M2I-CySat/CySat-1-Structures/20180421_144640.jpg

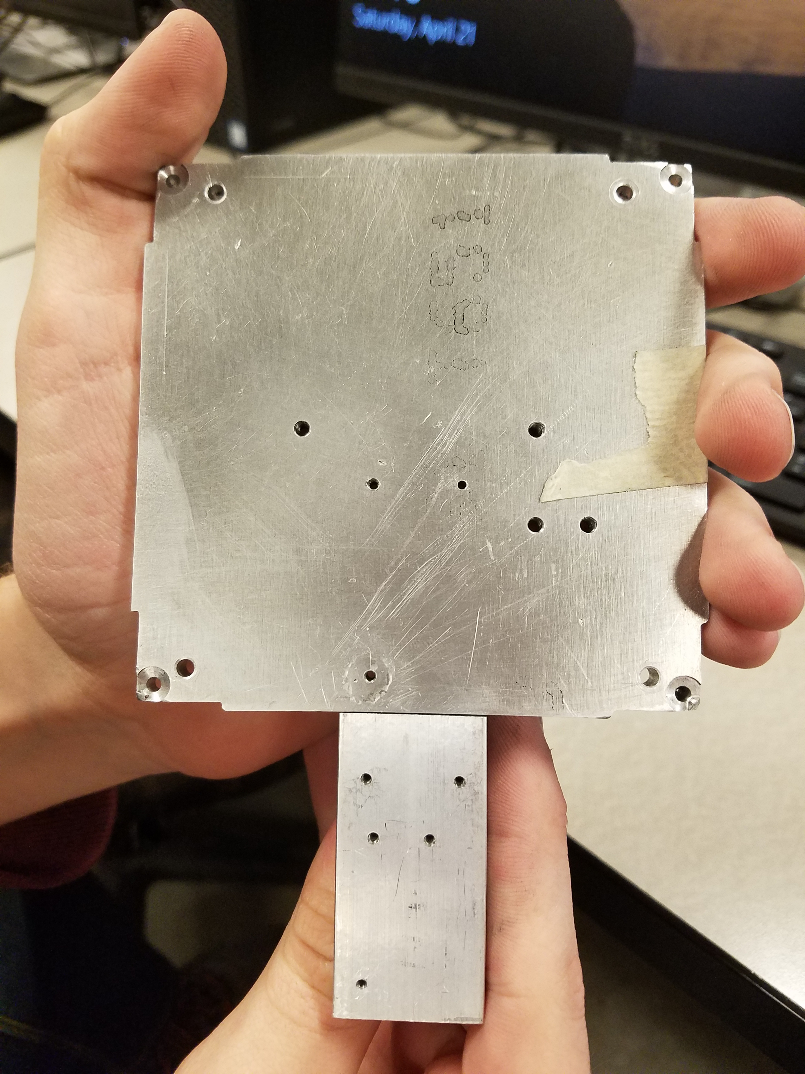
20180421_144640.jpg
