M2I-CySat/CySat-1-Structures/20180418_163143.jpg

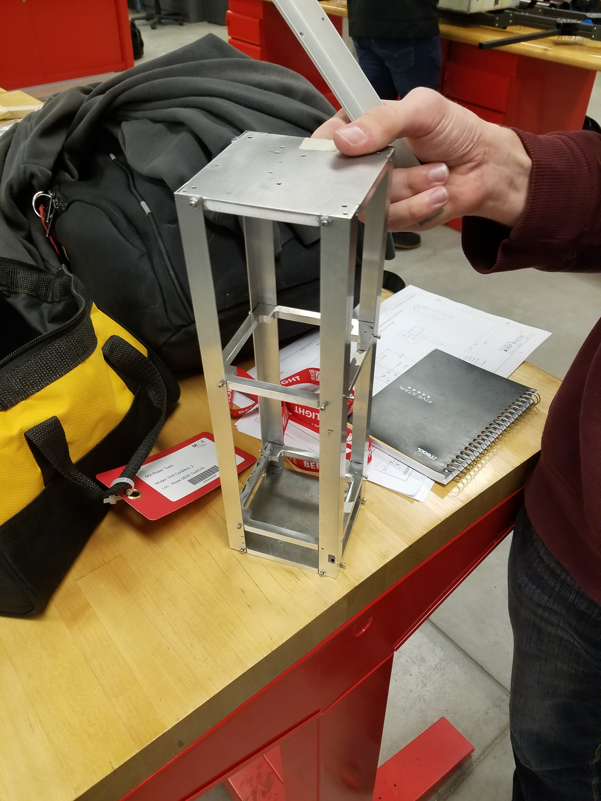
20180418_163143.jpg
