M2I-CySat/CySat-1-Structures/README.md

CySat-Structure

The SolidWorks files showing the structural arrangement of the satellite and all its components

===============
