M2I-CySat/CySat-1-Structures/20180421_144650.jpg

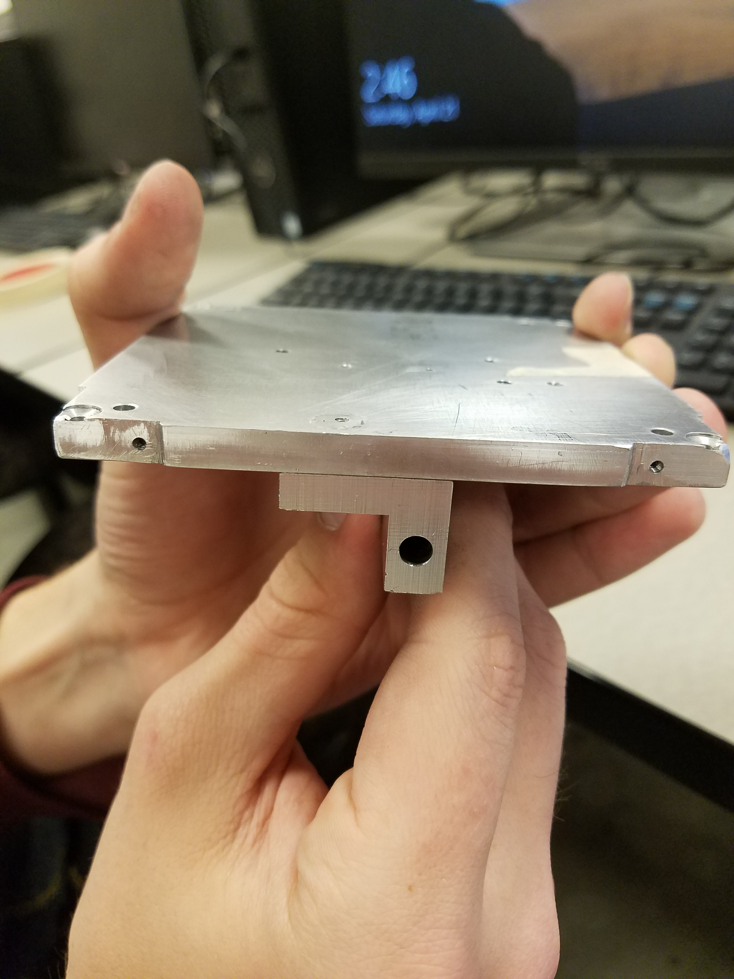
20180421_144650.jpg
