M2I-CySat/CySat-1-Structures/20180421_145329.jpg

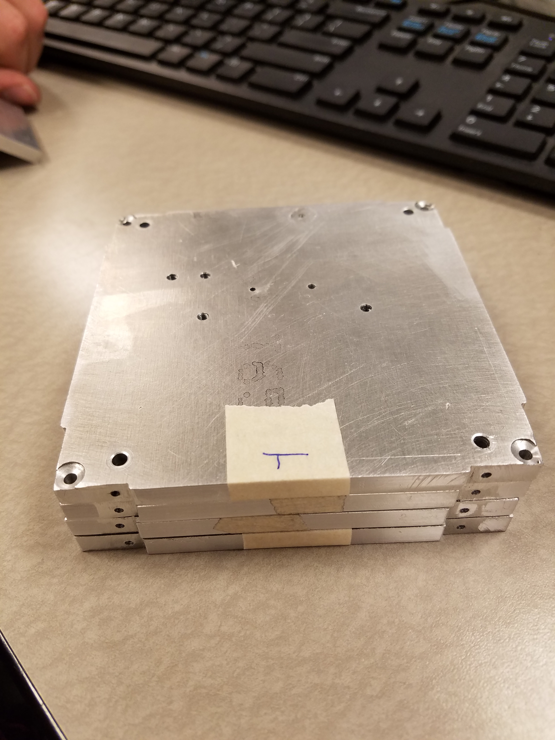
20180421_145329.jpg
