M2I-CySat/CySat-1-Structures/20180421_145657.jpg

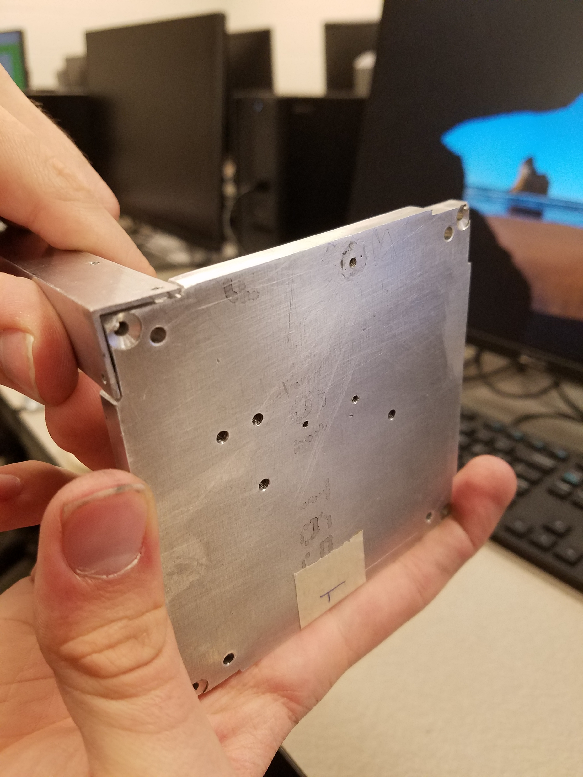
20180421_145657.jpg
