M2I-CySat/CySat-1-Structures/20180421_153506.jpg

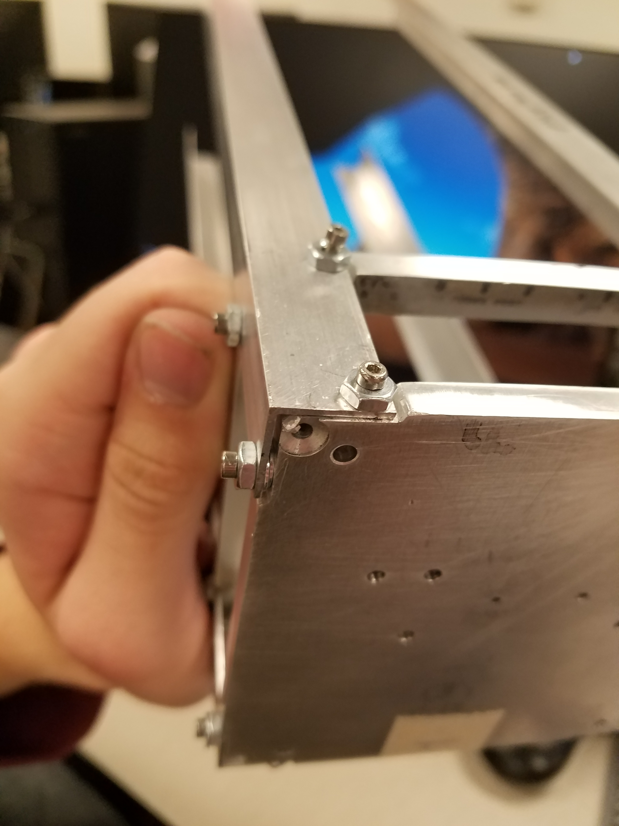
20180421_153506.jpg
