M2I-CySat/CySat-1-Structures/20180421_154950.jpg

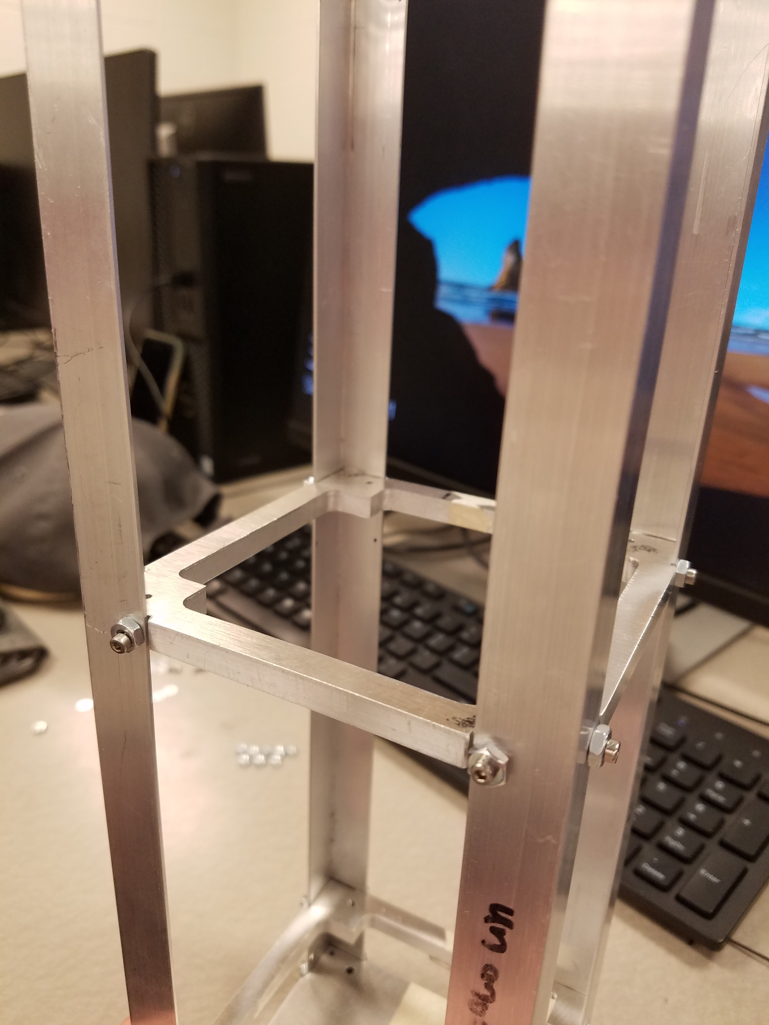
20180421_154950.jpg
