M2I-CySat/CySat-1-Structures/20180421_160213.jpg

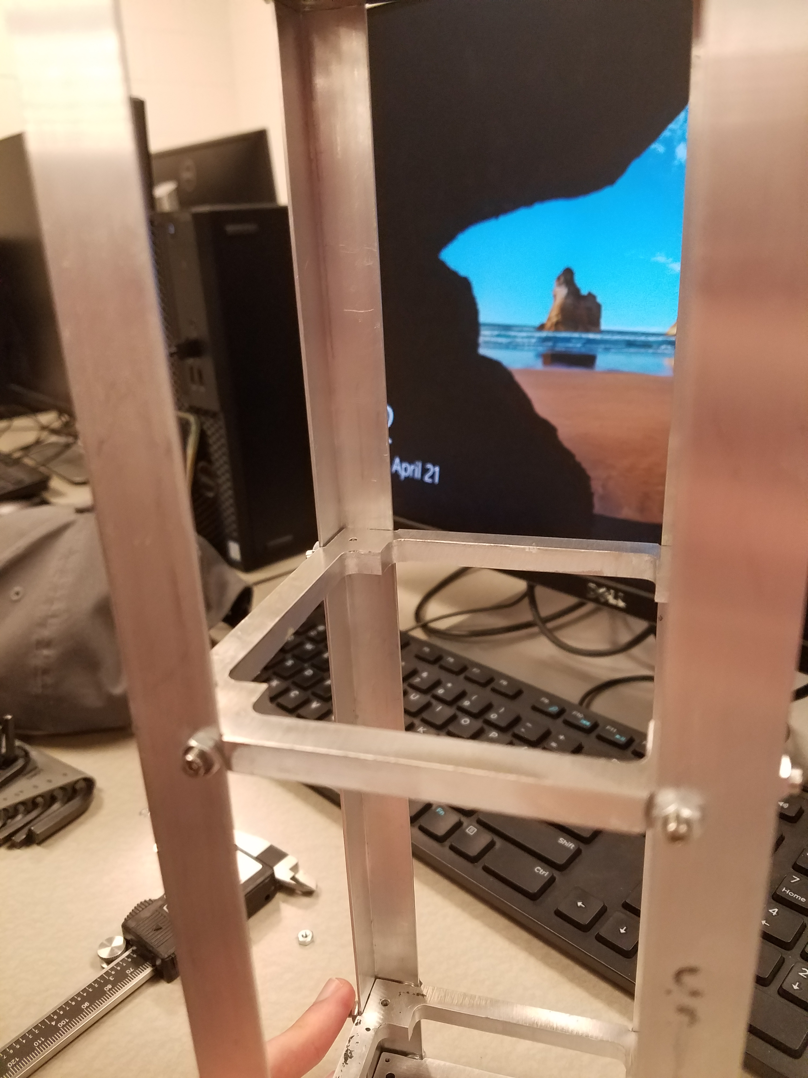
20180421_160213.jpg
