M2I-CySat/CySat-1-Structures/20180421_160232.jpg

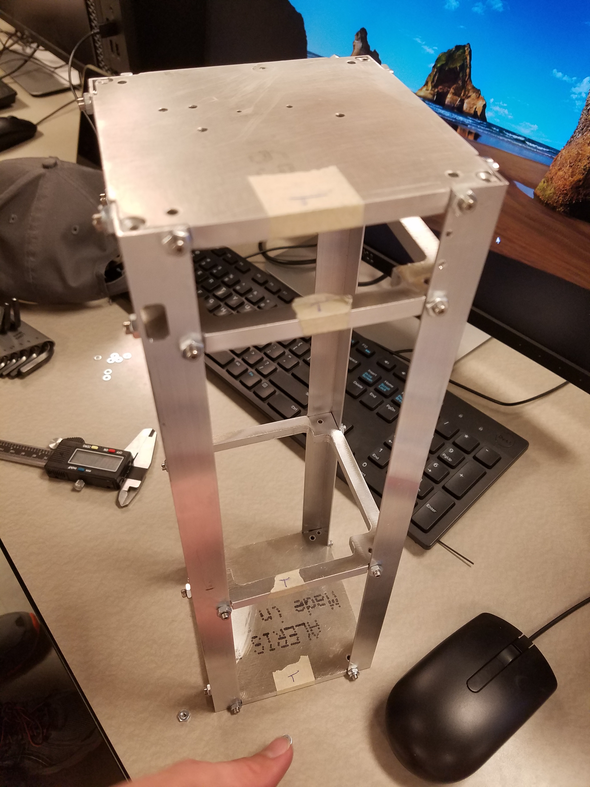
20180421_160232.jpg
