M2I-CySat/CySat-1-Structures/20180421_160246.jpg

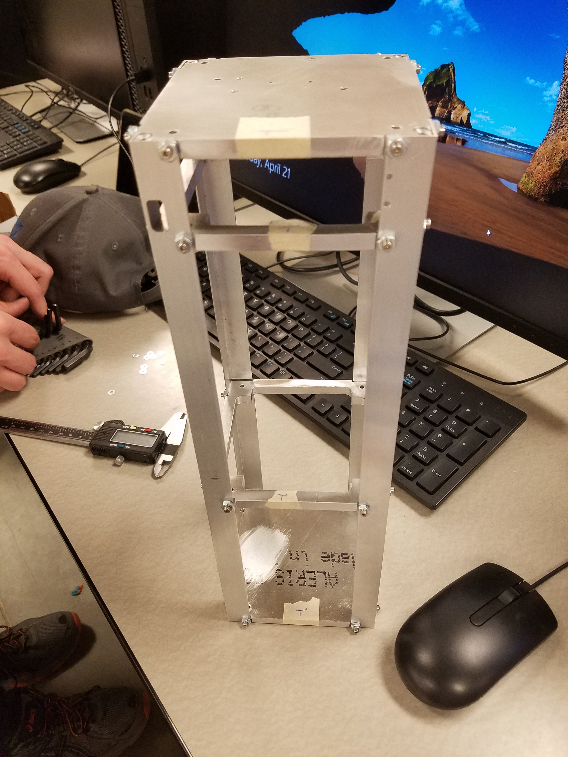
20180421_160246.jpg
