M2I-CySat/CySat-1-Structures/Asteroid 3U Mission - 2014-2015/Render 1.JPG

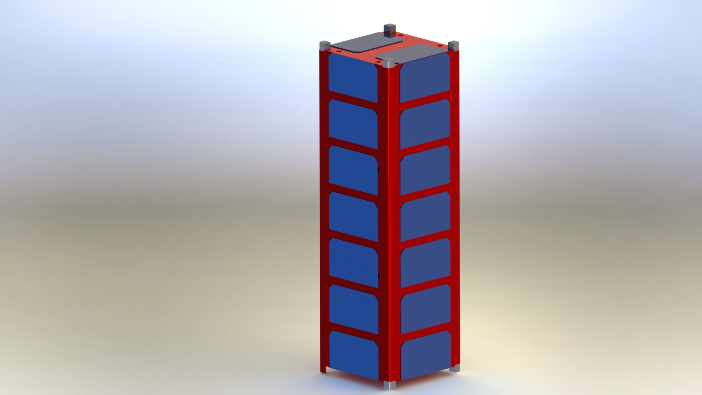
Asteroid 3U Mission - 2014-2015/Render 1.JPG
