M2I-CySat/CySat-1-Structures/2017-2017 Model/Assembly/connected rail assembly.SLDASM

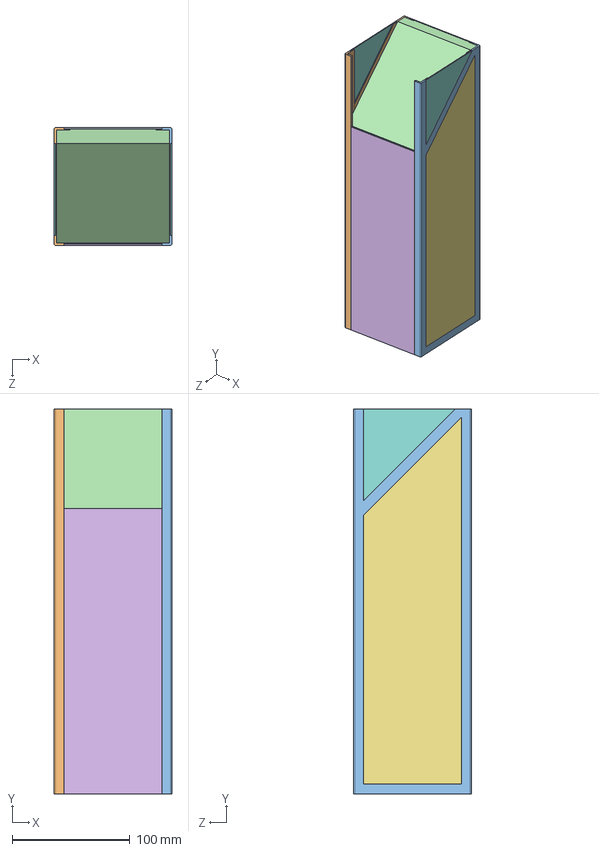
[picture p20: CAD file, 2016-10-22]
2017-2017 Model/Assembly/connected rail assembly.SLDASM
100.0 x 327.5 x 100.0 mm
back panel
Connected rail no midcut left
Connected rail no midcut right
top panel
bottom panel
fore panel
side panel lower x 2
side panel upper x 2
