M2I-CySat/CySat-1-Structures/Asteroid 3U Mission - 2014-2015/Assem4.SLDASM

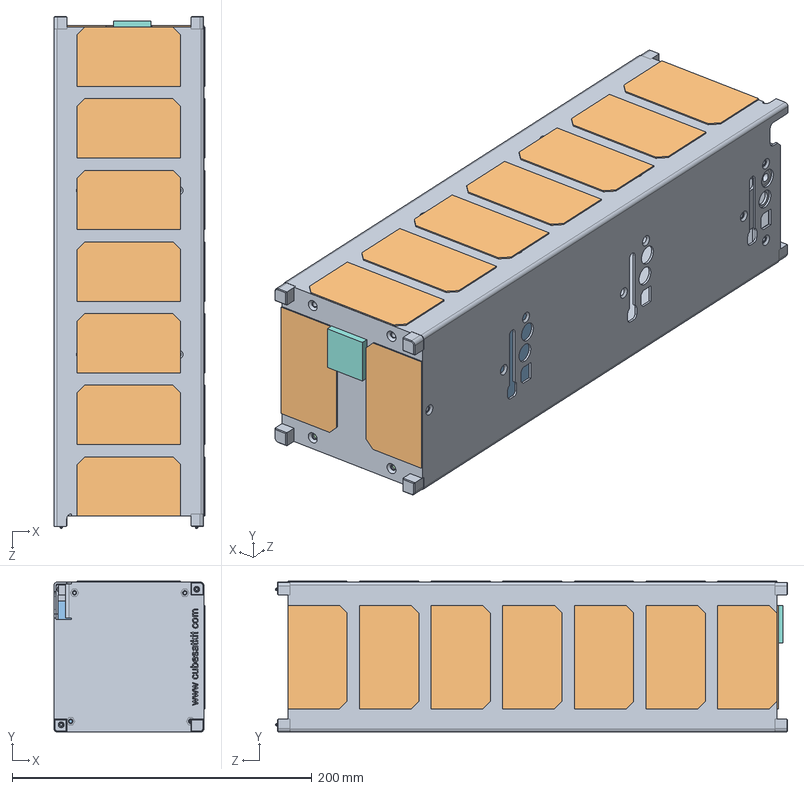
[picture p21: CAD file, 2016-01-22]
Asteroid 3U Mission - 2014-2015/Assem4.SLDASM
100.8 x 100.8 x 341.8 mm
CSK_3U_Chassis_Solid_RevC
Solarcell x 16
Attitude control board
CNDH block
EPS board block
Hack HD block x 2
Infared Spectormeter block
patch antenna
Power Batteries block x 2
