M2I-CySat/CySat-1-Structures/Asteroid 3U Mission-2015-2016/Generalized model/Top Panel components/Top panel solidworks part/Top_Panel_ASSY-2.SLDPRT

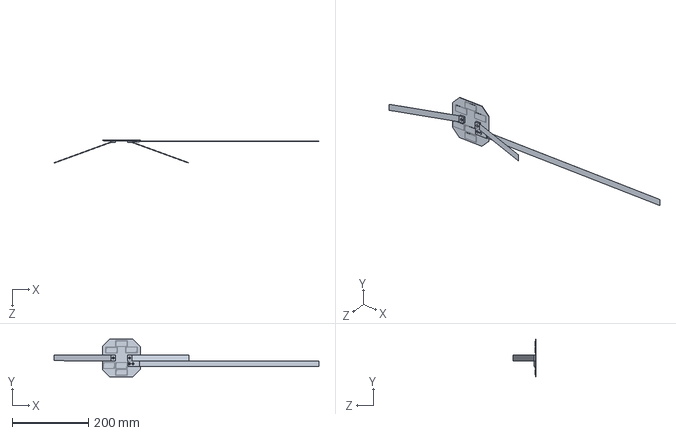
[picture p22: CAD file, 2014-09-20]
Asteroid 3U Mission-2015-2016/Generalized model/Top Panel components/Top panel solidworks part/Top_Panel_ASSY-2.SLDPRT
694.1 x 99.0 x 60.0 mm
