M2I-CySat/CySat-1-Structures/CySAT Mission 1/SolidWorks 2-22-14/Bottom panel components/solidwork part/Bottom_Panel_ASSY-1.SLDPRT

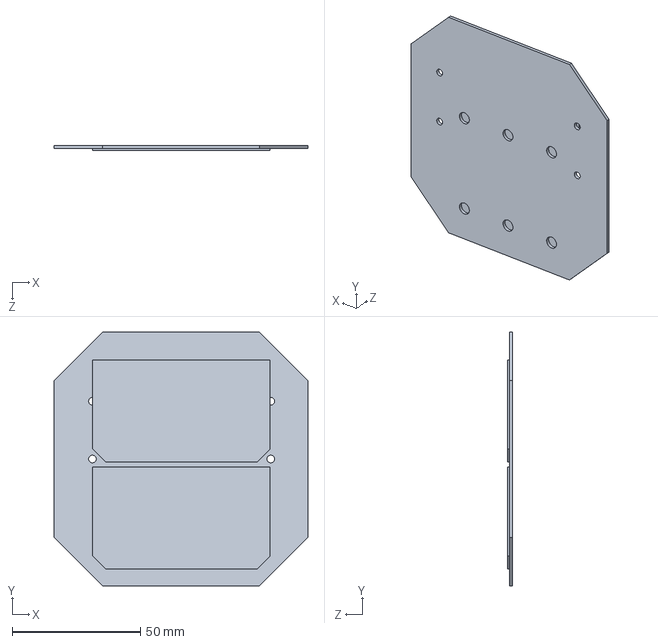
[picture p23: CAD file, 2015-09-26]
CySAT Mission 1/SolidWorks 2-22-14/Bottom panel components/solidwork part/Bottom_Panel_ASSY-1.SLDPRT
99.0 x 99.0 x 2.10 mm
