M2I-CySat/CySat-1-Structures/CySAT Mission 1/SolidWorks 2-22-14/SidePanels/solar panel assembly 2.SLDPRT

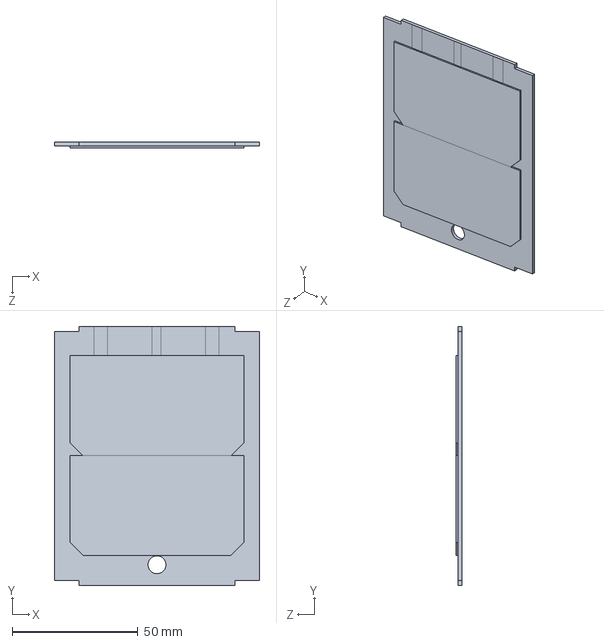
[picture p24: CAD file, 2015-09-26]
CySAT Mission 1/SolidWorks 2-22-14/SidePanels/solar panel assembly 2.SLDPRT
81.7 x 103.0 x 2.30 mm
