M2I-CySat/CySat-1-Structures/Full Assembly.SLDASM

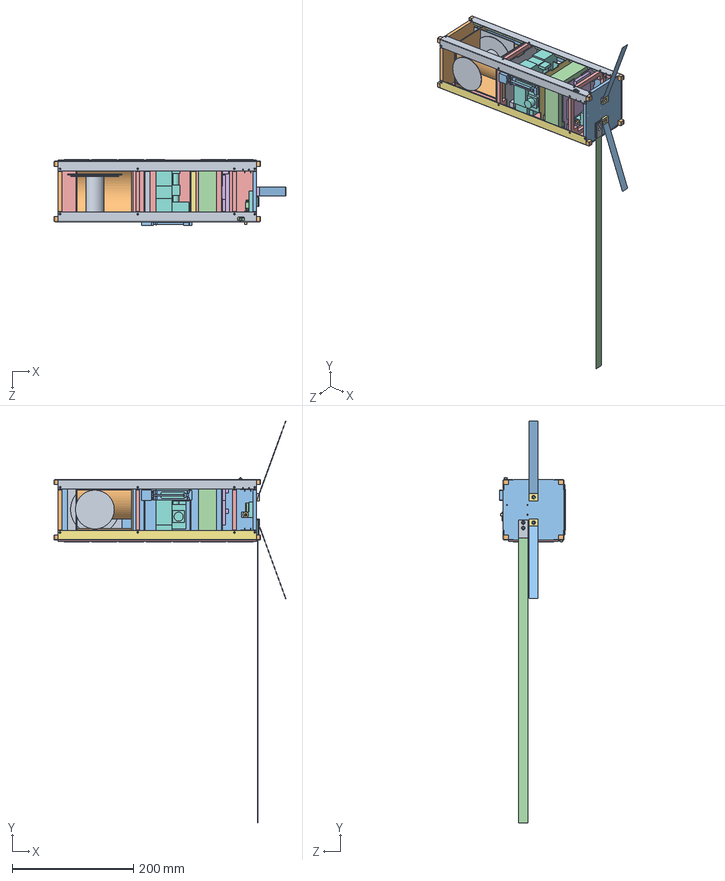
[picture p26: CAD file, 2018-05-31]
Full Assembly.SLDASM
382.0 x 663.1 x 109.5 mm
Rail x 3
Bottom Panel
Top Panel(current)
Basic Rails x 4
Center Supports(1) x 2
Dipole_Antenna_Mount_Bottom x 2
Dipole_Antenna_Mount_Top x 2
Mono_Antenna_Mount_Bottom
Mono_Antenna_Mount_Top
standoff(design2) x 8
Dipole x 2
Monopole
Custom Solar Panel
HeRadio
motherboard
ADCS
payloadcontrolboard
Stowed Deployable Magne
634-01101 CubeSat Kit Remove-Before-Flight (RBF) Switch x 3
Cut down RBF
TopRBF
Rail_no_RBF
Custom RBF Bracket
CySAT Antenna
RBF Pin
Custom Solar Panel with camera
EndurosatEPSBatt
