M2I-CySat/CySat-1-Structures/CySAT Mission 1/SolidWorks 2-22-14/Bottom panel components/Bottom_Panel_ASSY-1.SLDASM

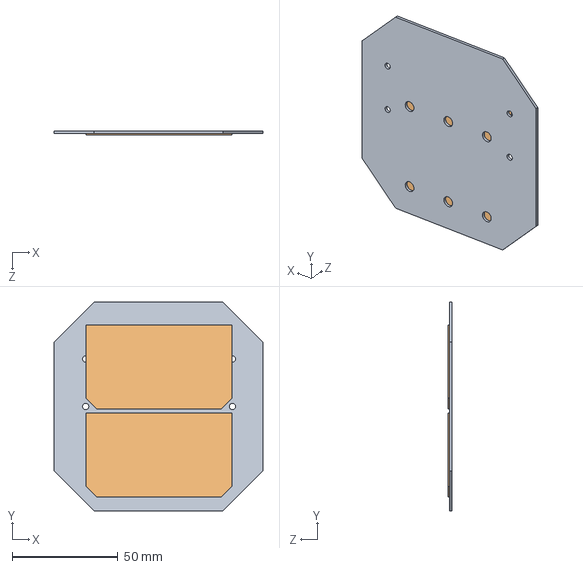
[picture p27: CAD file, 2014-10-18]
CySAT Mission 1/SolidWorks 2-22-14/Bottom panel components/Bottom_Panel_ASSY-1.SLDASM
99.0 x 99.0 x 2.10 mm
Bottom_Panel
Solar_Cell x 2
