M2I-CySat/CySat-1-Structures/CySAT Mission 1/SolidWorks 2-22-14/SidePanels/3D-25-00212-revA_1-6.sldasm

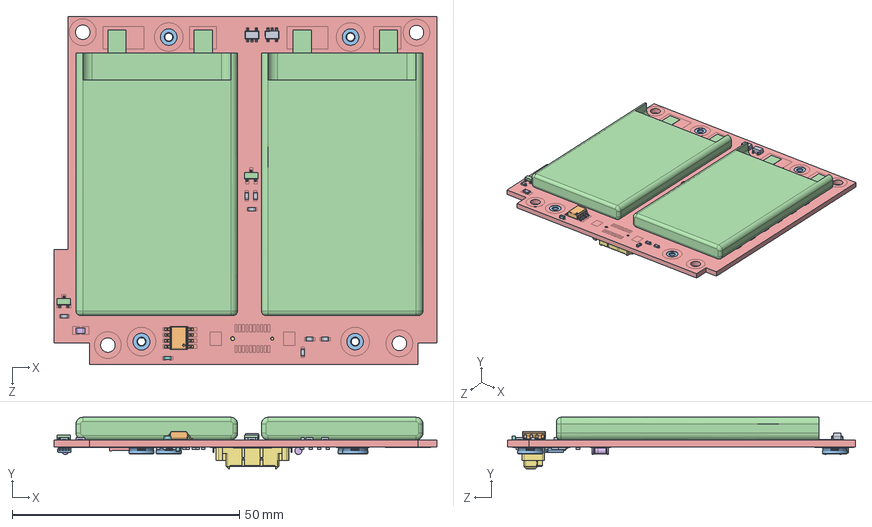
[picture p28: CAD file, 2014-10-18]
CySAT Mission 1/SolidWorks 2-22-14/SidePanels/3D-25-00212-revA_1-6.sldasm
84.3 x 11.3 x 76.6 mm
R0603_1 x 25
SO-8_1
3D-13-00246_1 x 4
SOT-23_1 x 2
R2512_1
minimelf_Domyslna_1 x 2
K3D-KX15-20K3DE-R1 JAE_1
C0603_1 x 2
SOT-23-5_1 x 2
SMDC260F-12_1
TSSOP-8_AA (TSSOP-8)_1
3.7V BATTERY_1 x 2
3D-11-00227-REVA_1
R0805_1
