M2I-CySat/CySat-1-Structures/Asteroid 3U Mission-2015-2016/Generalized model/full rod (no thread).SLDPRT

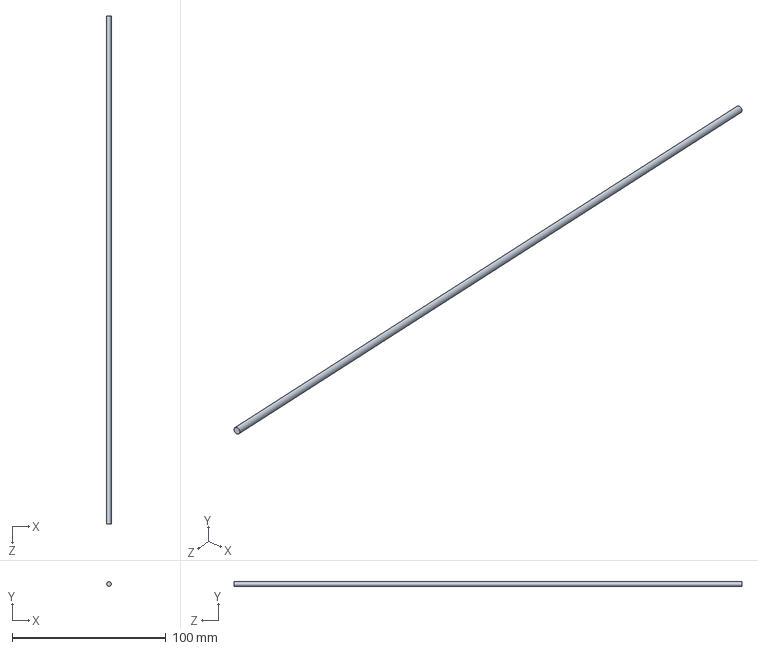
[picture p29: CAD file, 2016-04-02]
Asteroid 3U Mission-2015-2016/Generalized model/full rod (no thread).SLDPRT
3.00 x 3.00 x 330.6 mm
