M2I-CySat/CySat-1-Structures/Asteroid 3U Mission-2015-2016/Generalized model/skeleton structure assembly.SLDASM

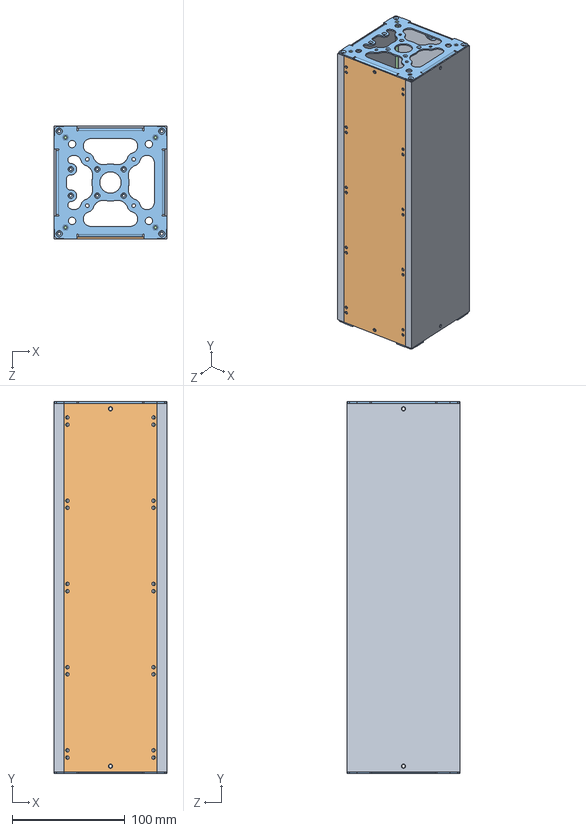
[picture p30: CAD file, 2016-04-02]
Asteroid 3U Mission-2015-2016/Generalized model/skeleton structure assembly.SLDASM
100.0 x 330.6 x 100.0 mm
3sided sidepanel
3panelsidepanel
csk_payload_adapter_plate_reva x 2
full rod (no thread) x 4
