M2I-CySat/CySat-1-Structures/Asteroid 3U Mission-2015-2016/Generalized model/New skeleton structure assembly.SLDASM

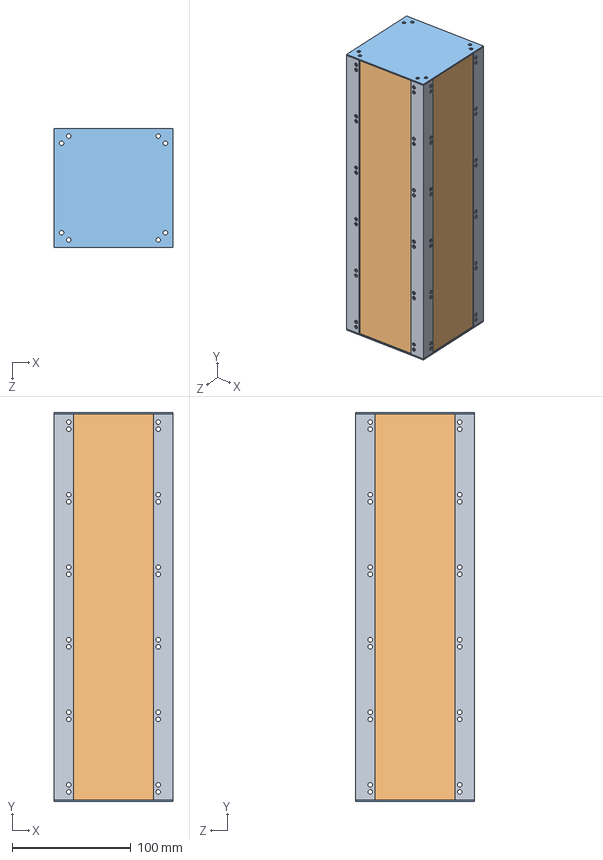
[picture p31: CAD file, 2016-02-27]
Asteroid 3U Mission-2015-2016/Generalized model/New skeleton structure assembly.SLDASM
100.0 x 327.0 x 100.0 mm
Newrails x 4
Sidepanel x 4
general_top_bottom x 2
