M2I-CySat/CySat-1-Structures/Asteroid 3U Mission-2015-2016/Generalized model/Top Panel components/Top_Panel_ASSY-2.SLDASM

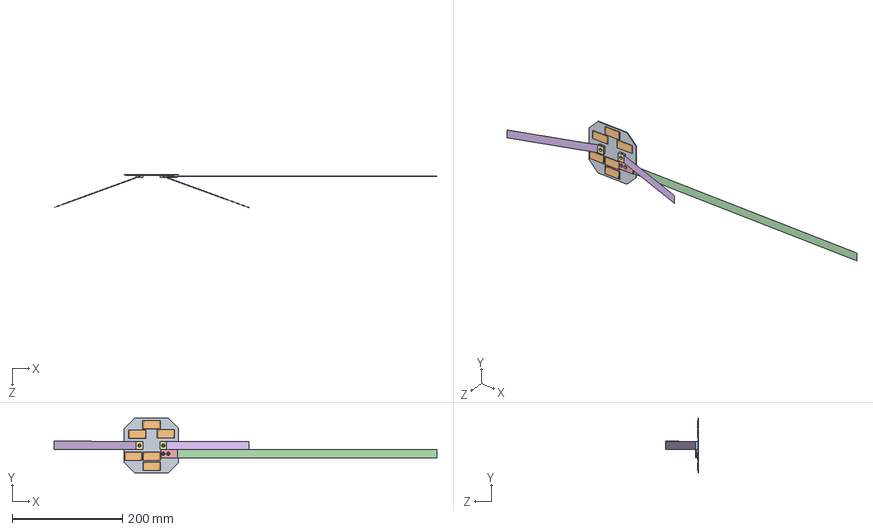
[picture p32: CAD file, 2014-09-20]
Asteroid 3U Mission-2015-2016/Generalized model/Top Panel components/Top_Panel_ASSY-2.SLDASM
694.1 x 99.0 x 60.0 mm
Top_Panel
Taskcell x 6
Dipole_Antenna_Mount_Bottom x 2
Monopole_Antenna
Mono_Antenna_Mount_Top
Dipole_Antenna x 2
Dipole_Antenna_Mount_Top x 2
