M2I-CySat/CySat-1-Structures/CySAT Mission 1/SolidWorks 2-22-14/He-100.SLDASM

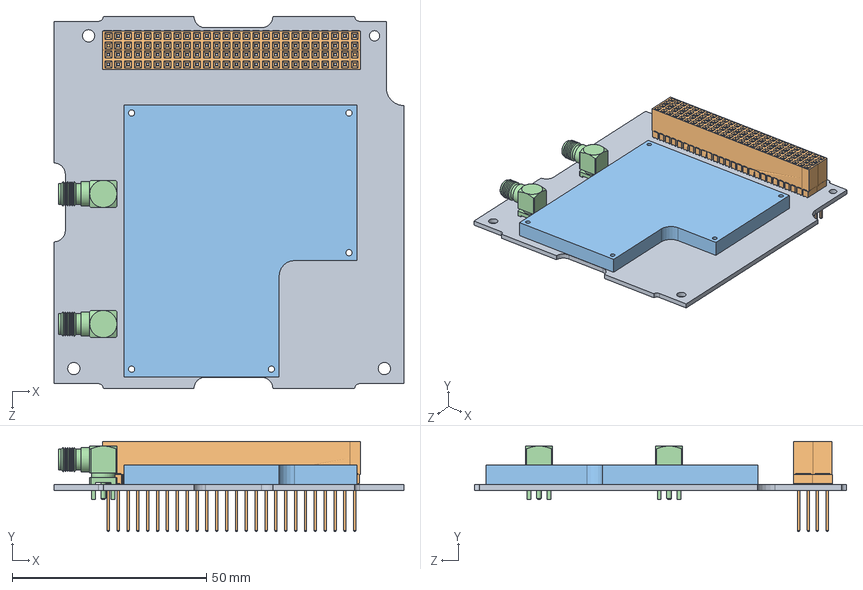
[picture p33: CAD file, 2014-10-18]
CySAT Mission 1/SolidWorks 2-22-14/He-100.SLDASM
90.2 x 23.2 x 95.9 mm
PCB
ESQ-126-14-X-D x 2
Heatsink_He
SMA-J-P-X-RA-TH1 x 2
