M2I-CySat/CySat-1-Structures/UND New Solidworks Parts/New EPS 10w.SLDASM

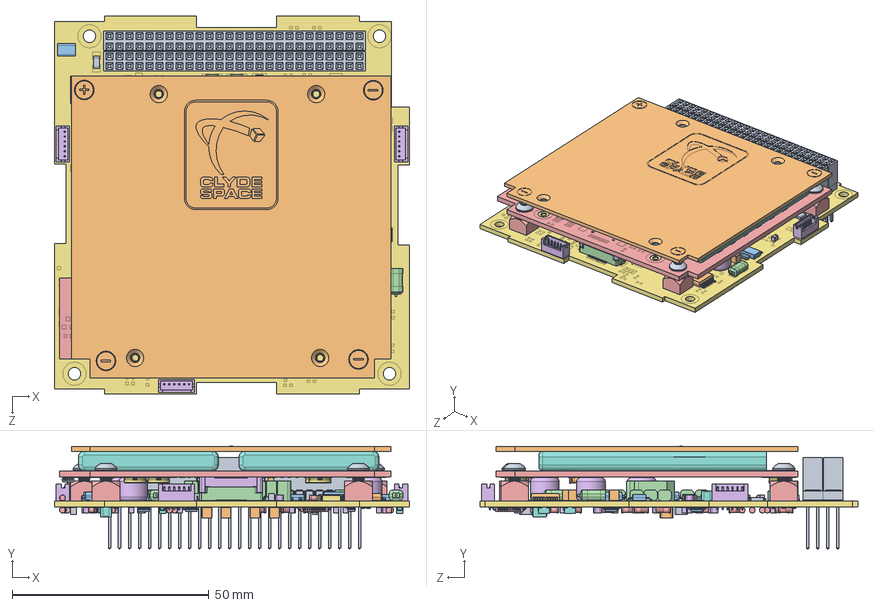
[picture p35: CAD file, 2015-04-13]
UND New Solidworks Parts/New EPS 10w.SLDASM
90.2 x 26.1 x 95.9 mm
3D-13-00250 x 4
3D-11-00224-REVA
sot-223 x 4
C_TANT_C x 12
SOD-8 x 29
C0805x1.52mm x 23
R1206 x 3
C_TANT_A x 3
ESQ-126-39-X-D x 2
C1210x2.8mm x 11
DIODESMC x 3
QFN-14 x 2
TQFP-48
DF13-6P-125-DSA x 3
3D-05-00154
3D-09-00156 x 3
C1206x1.9mm x 5
ssop20
MSOP10 x 3
3D-09-00172 x 2
3D-13-00233 x 4
3D-09-00171 x 3
3D-11-00262-REVA
MSOP12___ _________
R2512 x 3
minimelf_Domyslna x 4
R1218
KX14-20K2DE
3D-11-00227-REVA
KX15-20K4DE-R1
3D-13-00246 x 4
3.7V BATTERY x 2
TSSOP-8_AA (TSSOP-8)
SMDC260F-12
