M2I-CySat/CySat-1-Structures/UND New Solidworks Parts/NewTaskCells1.SLDASM

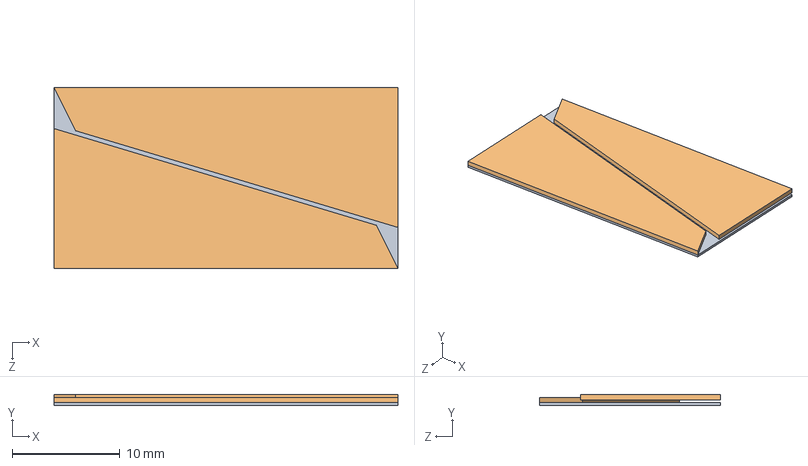
[picture p36: CAD file, 2015-04-06]
UND New Solidworks Parts/NewTaskCells1.SLDASM
32.0 x 1.00 x 16.8 mm
TaskeCellsBase
OnePanelForTaskCells x 2
