M2I-CySat/CySat-1-Structures/UND New Solidworks Parts/Payload Board Assembly.SLDASM

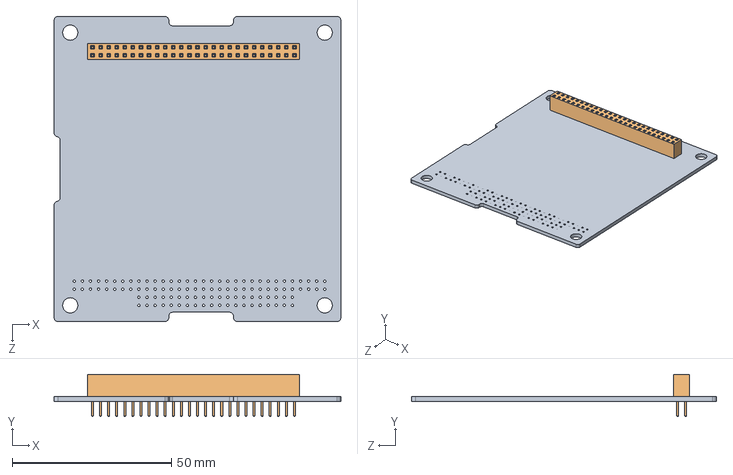
[picture p37: CAD file, 2015-04-04]
UND New Solidworks Parts/Payload Board Assembly.SLDASM
90.2 x 13.3 x 95.9 mm
payloadboard
CSK_Stacking_Bus_Connector
