M2I-CySat/CySat-1-Structures/2015 Mission/radiometer_assem.SLDPRT

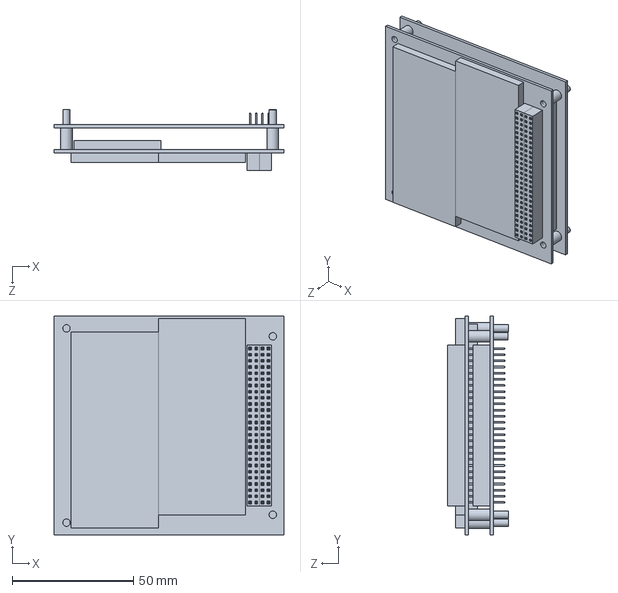
[picture p38: CAD file, 2014-10-18]
2015 Mission/radiometer_assem.SLDPRT
94.9 x 90.2 x 25.0 mm
