M2I-CySat/CySat-1-Structures/2017-2017 Model/Bottom Panel/bottom panel.SLDPRT

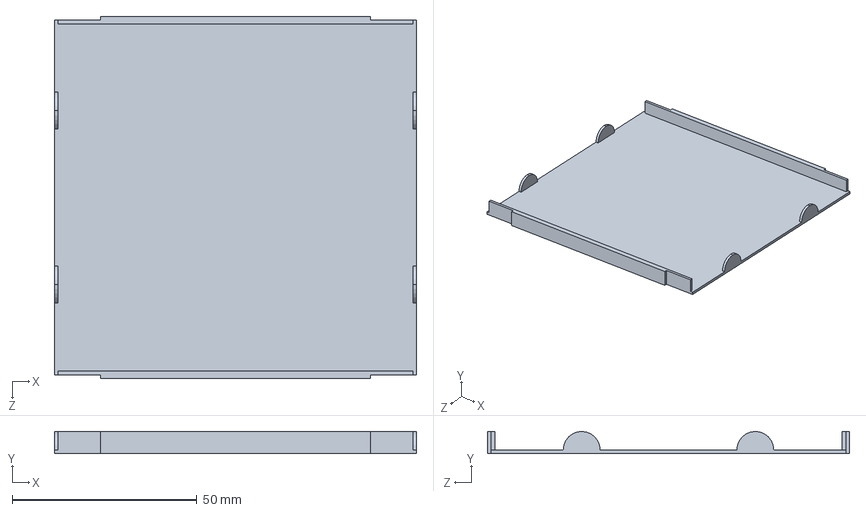
[picture p39: CAD file, 2016-10-22]
2017-2017 Model/Bottom Panel/bottom panel.SLDPRT
98.0 x 6.00 x 98.0 mm
