M2I-CySat/CySat-1-Structures/2017-2017 Model/Rails/Connected rail no midcut right.SLDPRT

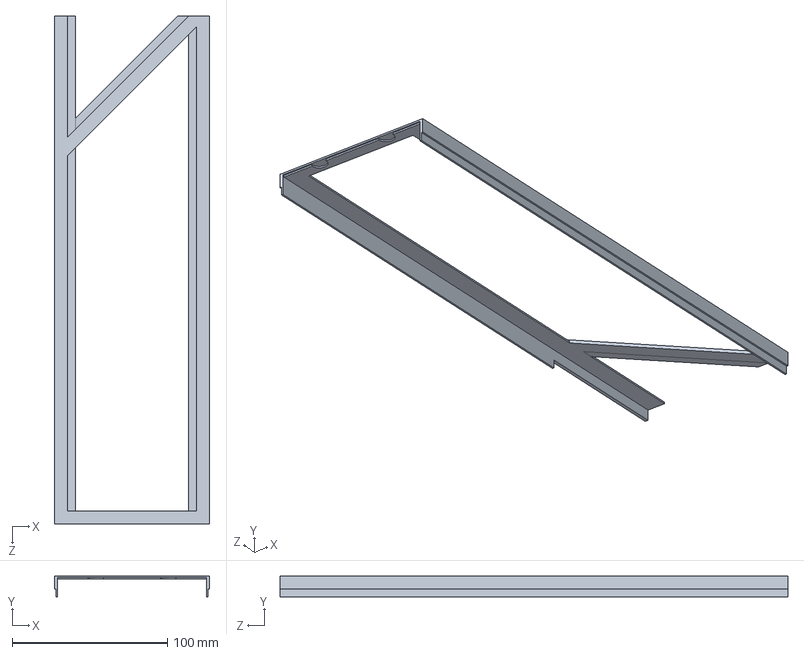
[picture p40: CAD file, 2016-10-22]
2017-2017 Model/Rails/Connected rail no midcut right.SLDPRT
100.0 x 13.5 x 327.5 mm
