M2I-CySat/CySat-1-Structures/2017-2017 Model/Side Panels/side panel lower.SLDPRT

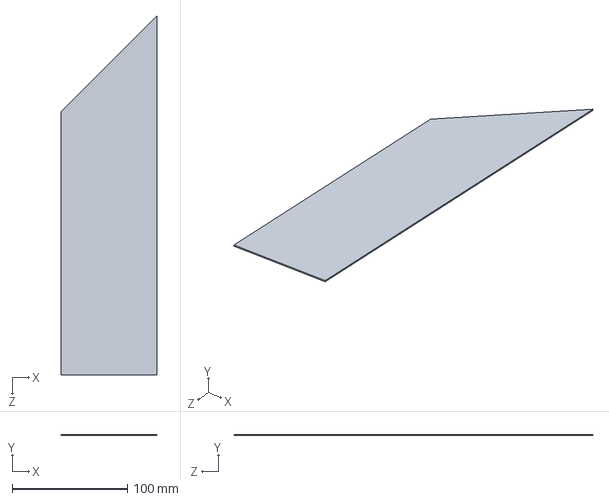
[picture p41: CAD file, 2016-10-22]
2017-2017 Model/Side Panels/side panel lower.SLDPRT
83.0 x 1.00 x 312.0 mm
