M2I-CySat/CySat-1-Structures/2017-2017 Model/Top Panel/top panel.SLDPRT

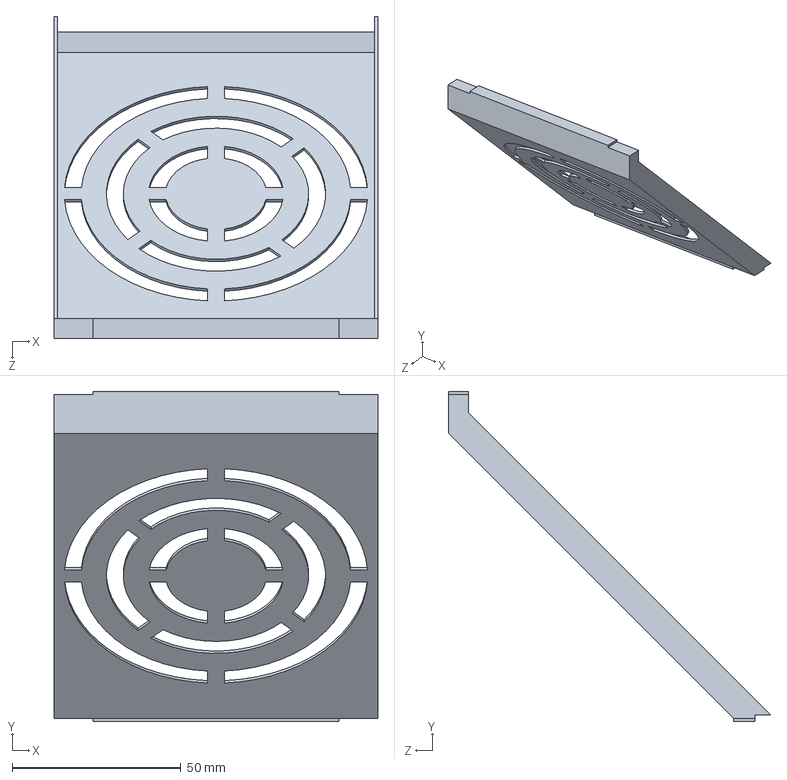
[picture p42: CAD file, 2016-10-22]
2017-2017 Model/Top Panel/top panel.SLDPRT
96.0 x 98.0 x 95.5 mm
