M2I-CySat/CySat-1-Structures/Asteroid 3U Mission - 2014-2015/board block/CNDH block.SLDPRT

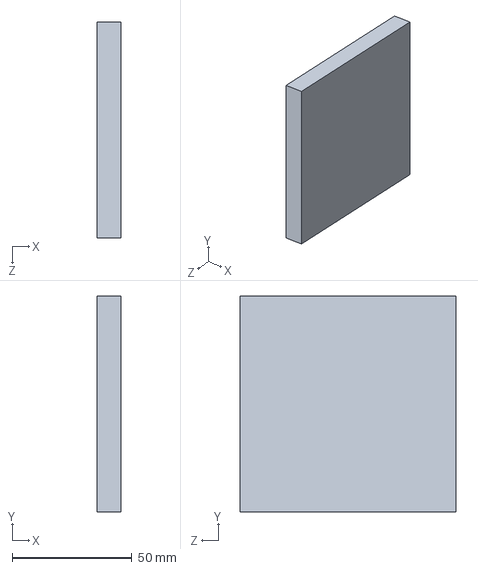
[picture p43: CAD file, 2016-01-22]
Asteroid 3U Mission - 2014-2015/board block/CNDH block.SLDPRT
10.0 x 90.0 x 90.0 mm
