M2I-CySat/CySat-1-Structures/Asteroid 3U Mission-2015-2016/board block/patch antenna.SLDPRT

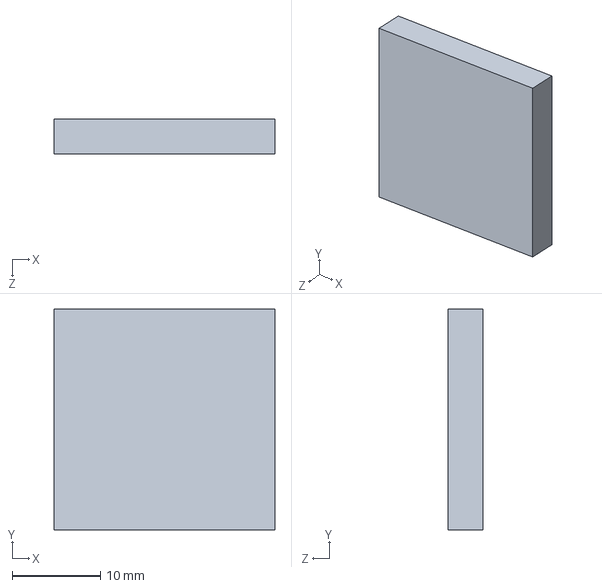
[picture p44: CAD file, 2016-01-23]
Asteroid 3U Mission-2015-2016/board block/patch antenna.SLDPRT
25.0 x 25.0 x 4.00 mm
