M2I-CySat/CySat-1-Structures/Asteroid 3U Mission-2015-2016/Generalized model/3panelsidepanel half.SLDPRT

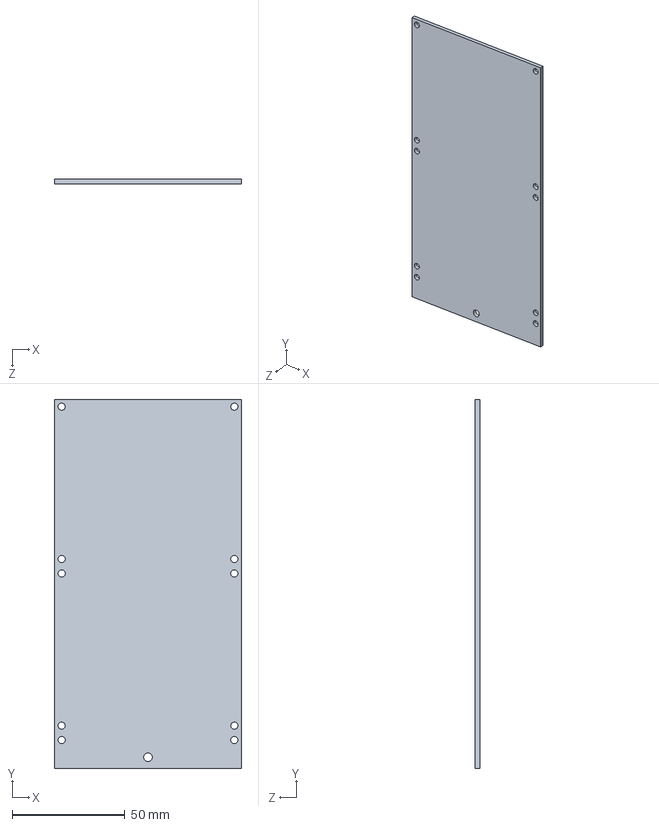
[picture p45: CAD file, 2016-04-16]
Asteroid 3U Mission-2015-2016/Generalized model/3panelsidepanel half.SLDPRT
83.0 x 163.8 x 2.00 mm
