M2I-CySat/CySat-1-Structures/Asteroid 3U Mission-2015-2016/Generalized model/New folder/3sided sidepanel 3d printable conex top half.SLDPRT

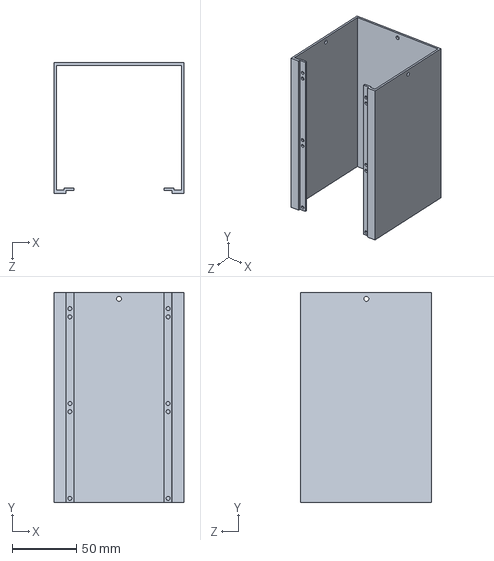
[picture p46: CAD file, 2016-04-16]
Asteroid 3U Mission-2015-2016/Generalized model/New folder/3sided sidepanel 3d printable conex top half.SLDPRT
101.2 x 163.8 x 101.8 mm
