M2I-CySat/CySat-1-Structures/Asteroid 3U Mission-2015-2016/Generalized model/Top Panel components/Mono_Antenna_Mount_Top.SLDPRT

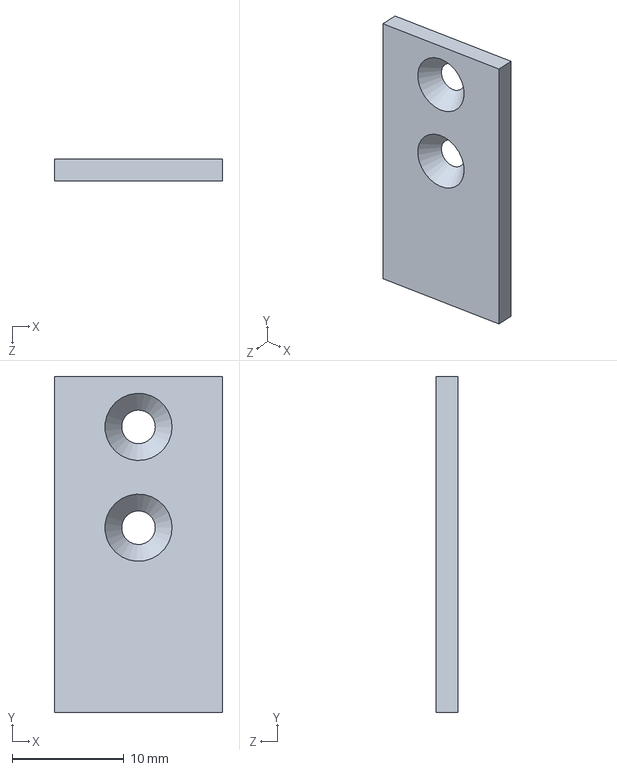
[picture p47: CAD file, 2015-10-31]
Asteroid 3U Mission-2015-2016/Generalized model/Top Panel components/Mono_Antenna_Mount_Top.SLDPRT
15.0 x 30.0 x 2.00 mm
