M2I-CySat/CySat-1-Structures/Bottom Panel With Hole.SLDPRT

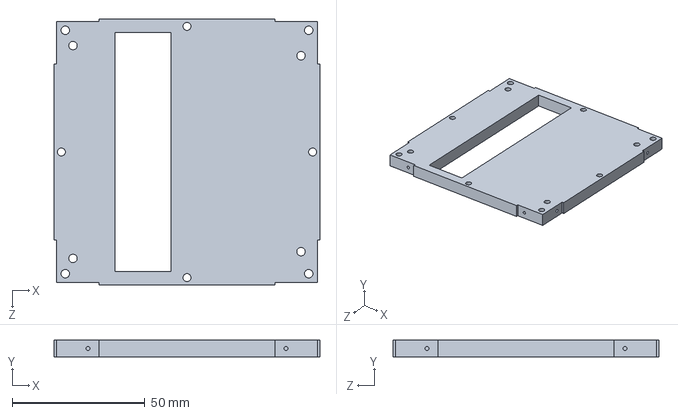
[picture p48: CAD file, 2018-05-31]
Bottom Panel With Hole.SLDPRT
100.0 x 6.35 x 100.0 mm
