M2I-CySat/CySat-1-Structures/CySAT Mission 1/SolidWorks 2-22-14/Bottom panel components/Solar_Cell.SLDPRT

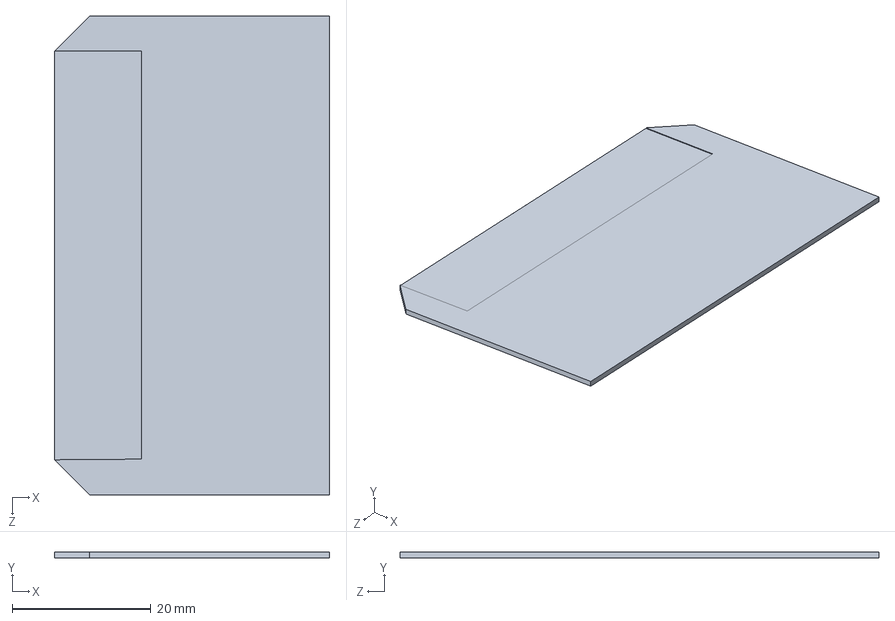
[picture p49: CAD file, 2014-10-18]
CySAT Mission 1/SolidWorks 2-22-14/Bottom panel components/Solar_Cell.SLDPRT
39.7 x 0.8 x 69.1 mm
