M2I-CySat/CySat-1-Structures/CySAT Mission 1/SolidWorks 2-22-14/diagnosticpannlea-1.SLDPRT

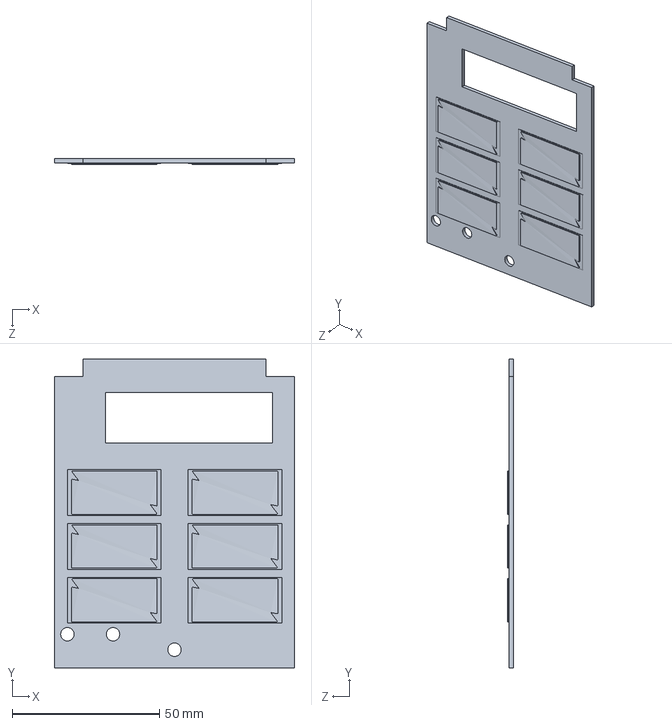
[picture p50: CAD file, 2015-10-31]
CySAT Mission 1/SolidWorks 2-22-14/diagnosticpannlea-1.SLDPRT
81.6 x 104.9 x 2.05 mm
