M2I-CySat/CySat-1-Structures/CySAT Mission 1/SolidWorks 2-22-14/SidePanels/Side Panel Components/Side_panel_feb2.SLDPRT

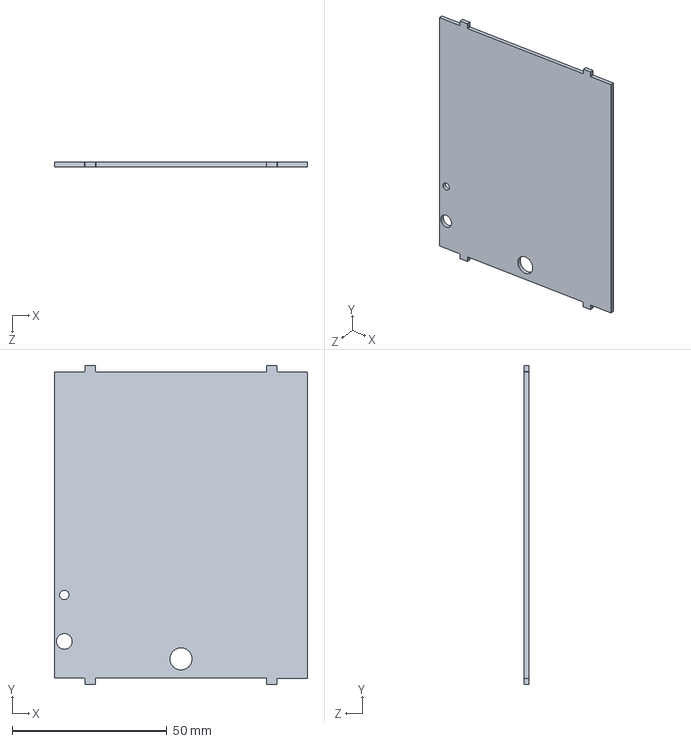
[picture p51: CAD file, 2014-10-18]
CySAT Mission 1/SolidWorks 2-22-14/SidePanels/Side Panel Components/Side_panel_feb2.SLDPRT
81.7 x 103.0 x 1.52 mm
