M2I-CySat/CySat-1-Structures/CySAT Mission 1/SolidWorks 2-22-14/SidePanels/Solidworks parts/3D-25-00212-revA_1.SLDPRT

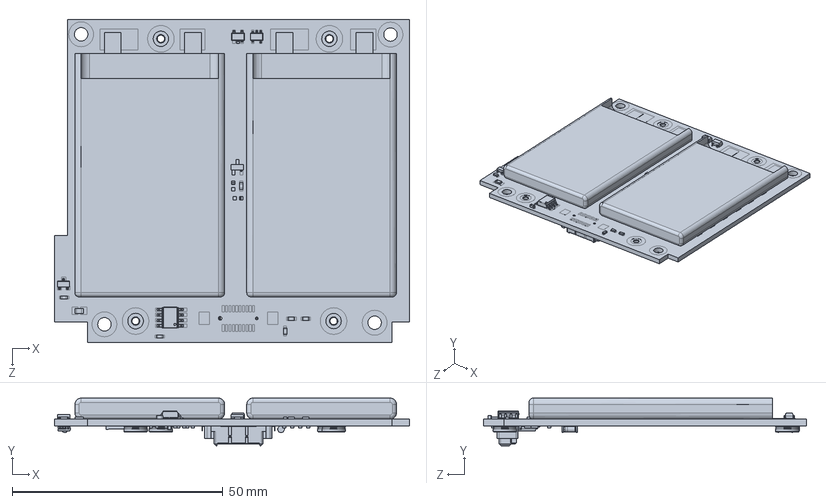
[picture p52: CAD file, 2014-10-18]
CySAT Mission 1/SolidWorks 2-22-14/SidePanels/Solidworks parts/3D-25-00212-revA_1.SLDPRT
84.3 x 11.3 x 76.6 mm
