M2I-CySat/CySat-1-Structures/CySAT Mission 1/SolidWorks 2-22-14/Spacers 2-22-14/Finished 1.55 cm.SLDPRT

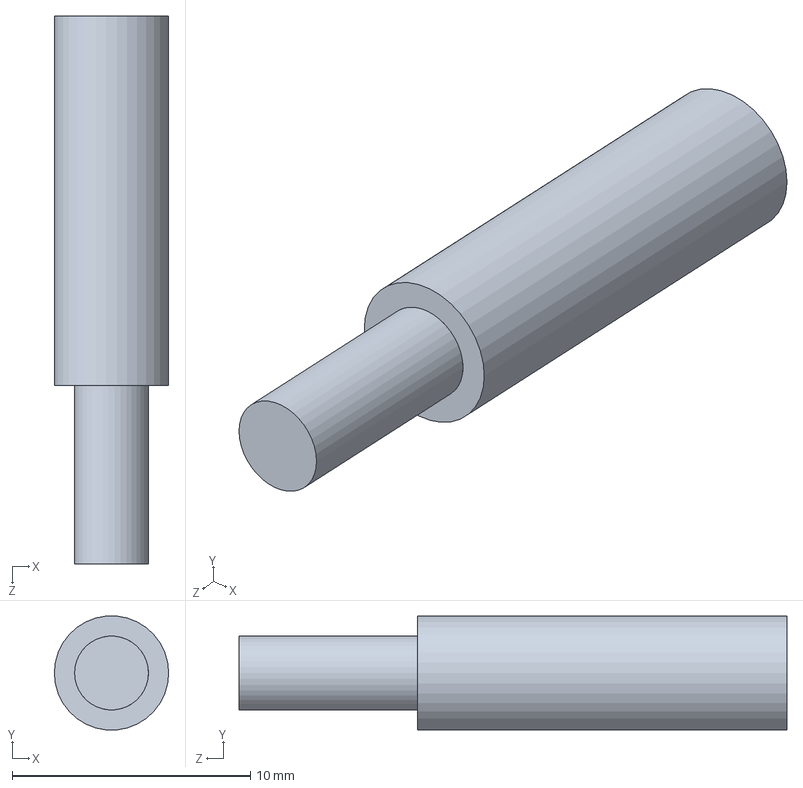
[picture p53: CAD file, 2015-09-26]
CySAT Mission 1/SolidWorks 2-22-14/Spacers 2-22-14/Finished 1.55 cm.SLDPRT
4.80 x 4.78 x 23.0 mm
