M2I-CySat/CySat-1-Structures/SolidWorks Main UND Model/He-100.SLDPRT

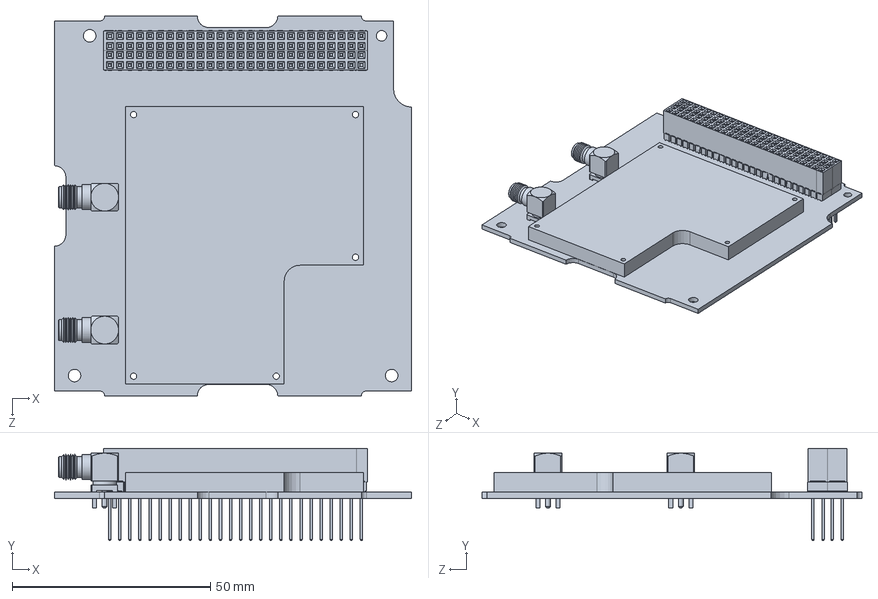
[picture p54: CAD file, 2014-12-13]
SolidWorks Main UND Model/He-100.SLDPRT
90.2 x 23.2 x 95.9 mm
