M2I-CySat/CySat-1-Structures/SolidWorks Main UND Model/Spacers 2-22-14/1.6 cm part 1.SLDPRT

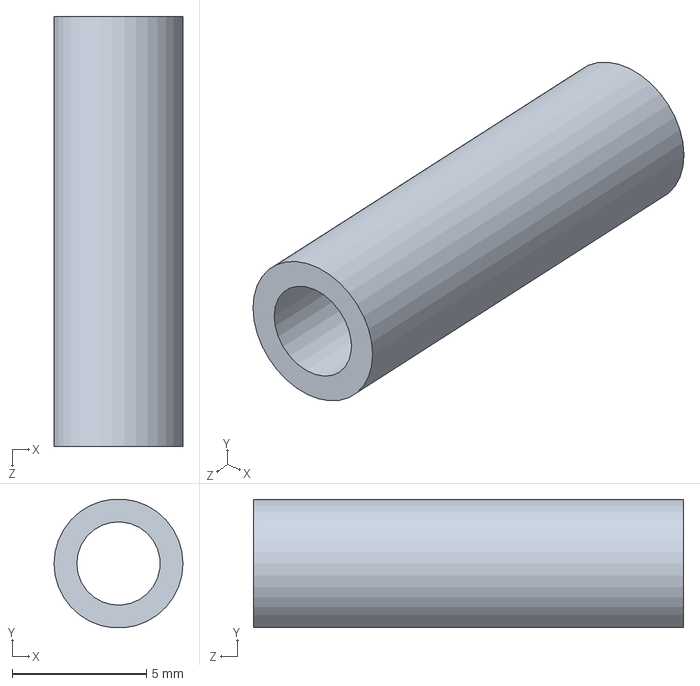
[picture p55: CAD file, 2014-10-18]
SolidWorks Main UND Model/Spacers 2-22-14/1.6 cm part 1.SLDPRT
4.80 x 4.78 x 16.0 mm
