M2I-CySat/CySat-1-Structures/2017-2017 Model/Side Panels/side panel upper.SLDPRT

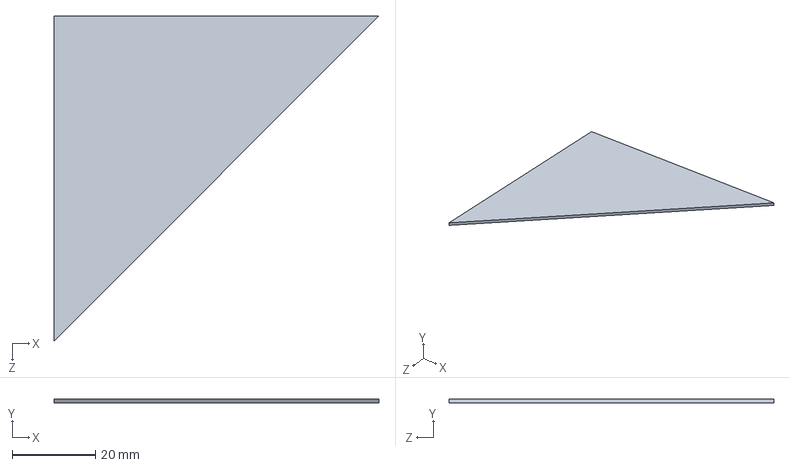
[picture p56: CAD file, 2016-10-22]
2017-2017 Model/Side Panels/side panel upper.SLDPRT
78.0 x 1.00 x 78.0 mm
