M2I-CySat/CySat-1-Structures/Asteroid 3U Mission - 2014-2015/board block/Power Batteries block.SLDPRT

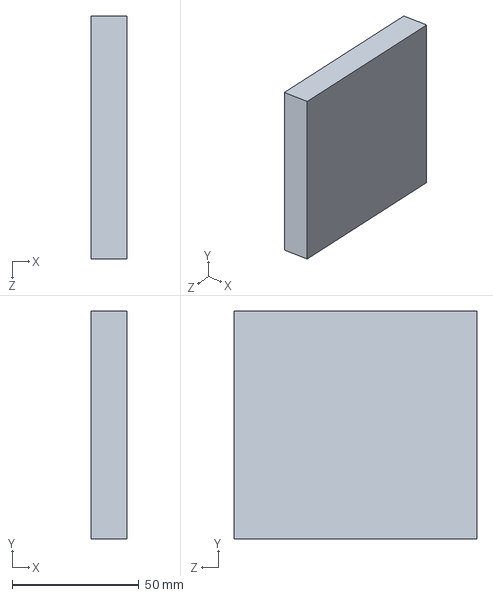
[picture p57: CAD file, 2016-01-22]
Asteroid 3U Mission - 2014-2015/board block/Power Batteries block.SLDPRT
14.4 x 90.0 x 96.0 mm
