M2I-CySat/CySat-1-Structures/Asteroid 3U Mission - 2014-2015/Solarcell.SLDPRT

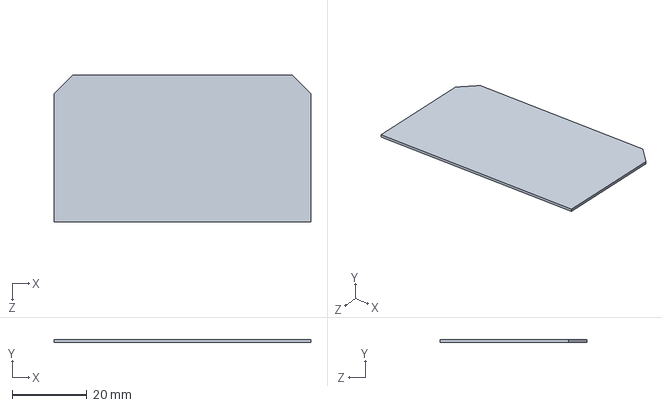
[picture p58: CAD file, 2015-11-14]
Asteroid 3U Mission - 2014-2015/Solarcell.SLDPRT
69.0 x 0.762 x 39.6 mm
