M2I-CySat/CySat-1-Structures/Asteroid 3U Mission-2015-2016/board block/Infared Spectormeter block.SLDPRT

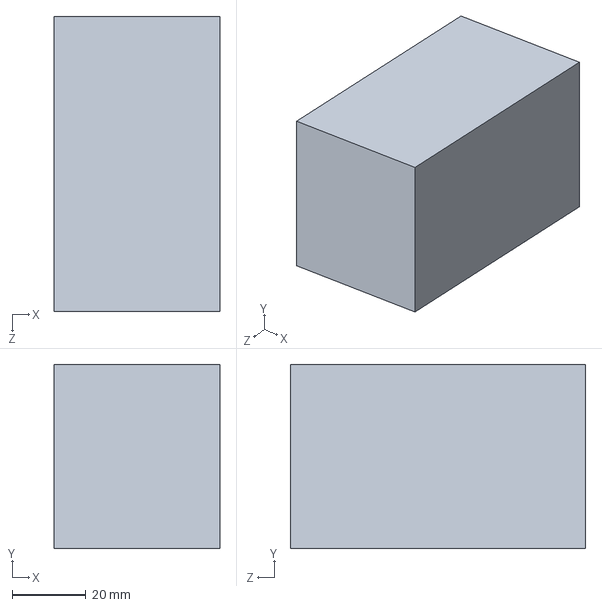
[picture p59: CAD file, 2016-01-23]
Asteroid 3U Mission-2015-2016/board block/Infared Spectormeter block.SLDPRT
45.0 x 50.0 x 80.0 mm
