M2I-CySat/CySat-1-Structures/Asteroid 3U Mission-2015-2016/Generalized model/3panelsidepanel.SLDPRT

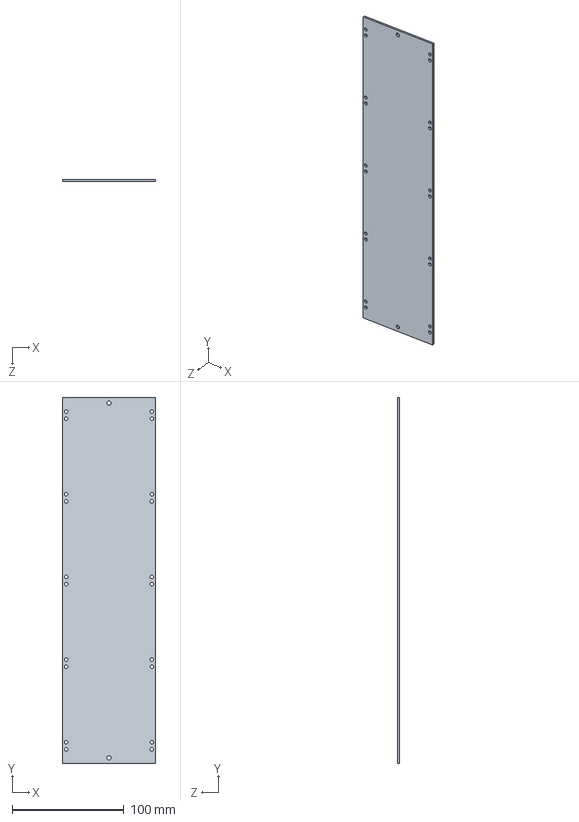
[picture p60: CAD file, 2016-04-09]
Asteroid 3U Mission-2015-2016/Generalized model/3panelsidepanel.SLDPRT
83.0 x 327.5 x 2.00 mm
