M2I-CySat/CySat-1-Structures/CySAT Mission 1/SolidWorks 2-22-14/Bottom panel components/Bottom_Panel.SLDPRT

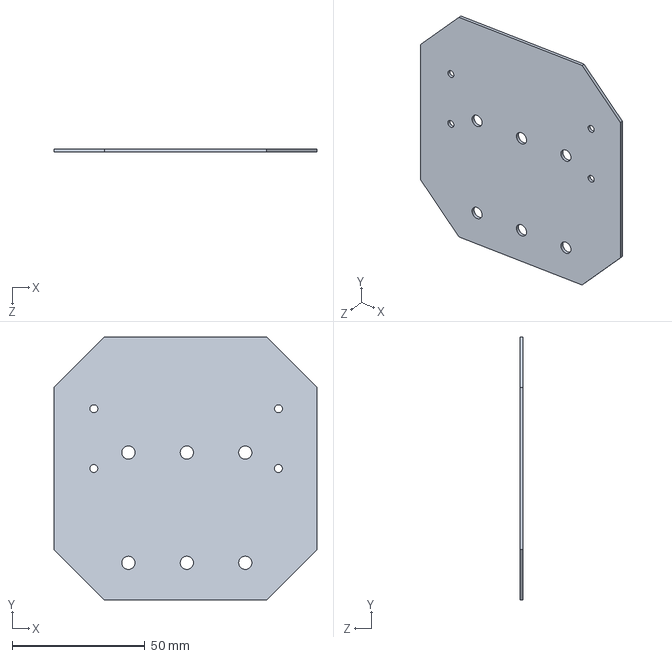
[picture p62: CAD file, 2014-10-18]
CySAT Mission 1/SolidWorks 2-22-14/Bottom panel components/Bottom_Panel.SLDPRT
99.0 x 99.0 x 1.30 mm
