M2I-CySat/CySat-1-Structures/CySAT Mission 1/SolidWorks 2-22-14/Solar clips.SLDPRT

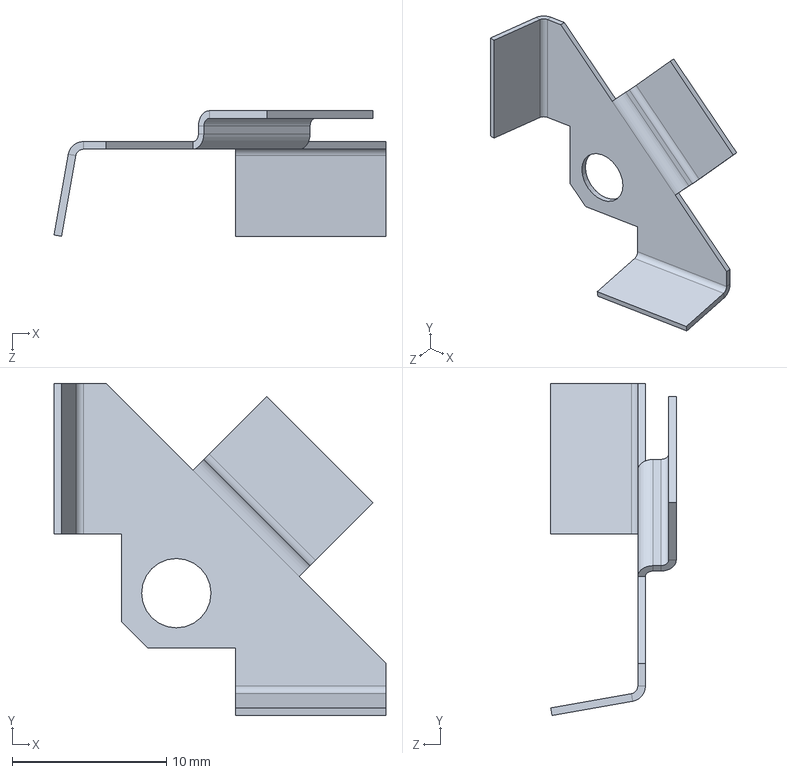
[picture p63: CAD file, 2015-09-26]
CySAT Mission 1/SolidWorks 2-22-14/Solar clips.SLDPRT
21.5 x 21.5 x 8.15 mm
