M2I-CySat/CySat-1-Structures/2017-2017 Model/Side Panels/back panel.SLDPRT

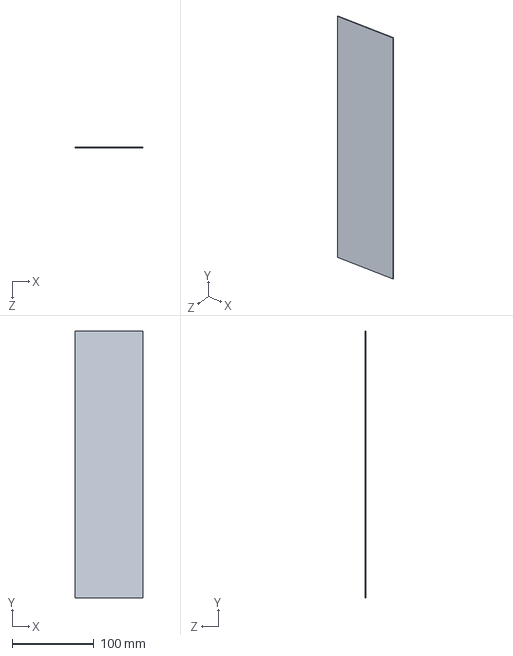
[picture p65: CAD file, 2016-10-22]
2017-2017 Model/Side Panels/back panel.SLDPRT
83.0 x 327.5 x 1.00 mm
