M2I-CySat/CySat-1-Structures/Asteroid 3U Mission - 2014-2015/board block/EPS board block.SLDPRT

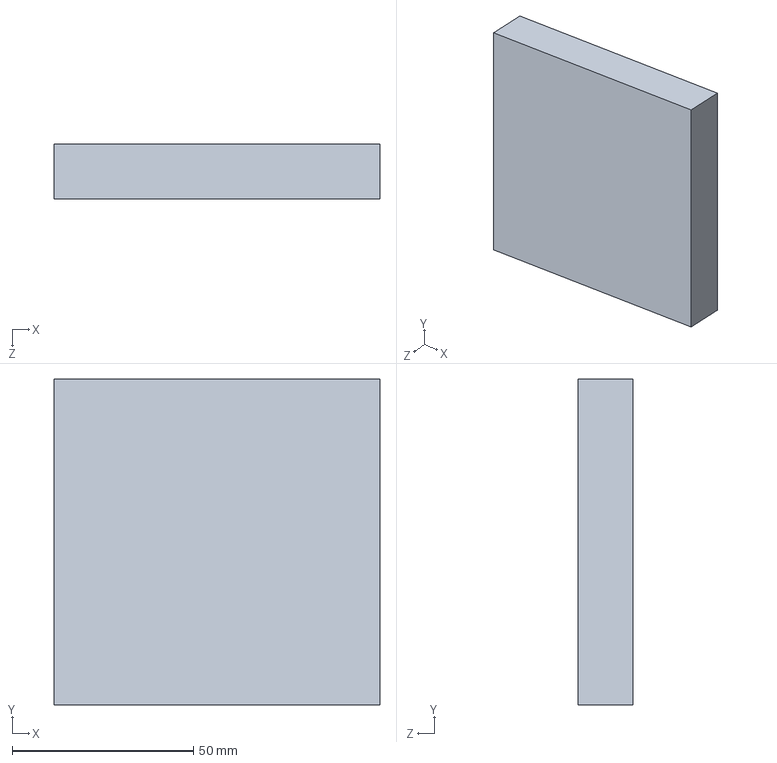
[picture p66: CAD file, 2016-01-22]
Asteroid 3U Mission - 2014-2015/board block/EPS board block.SLDPRT
90.0 x 90.0 x 15.3 mm
