M2I-CySat/CySat-1-Structures/Asteroid 3U Mission - 2014-2015/CSK_3U_Chassis_Solid_RevC.SLDPRT

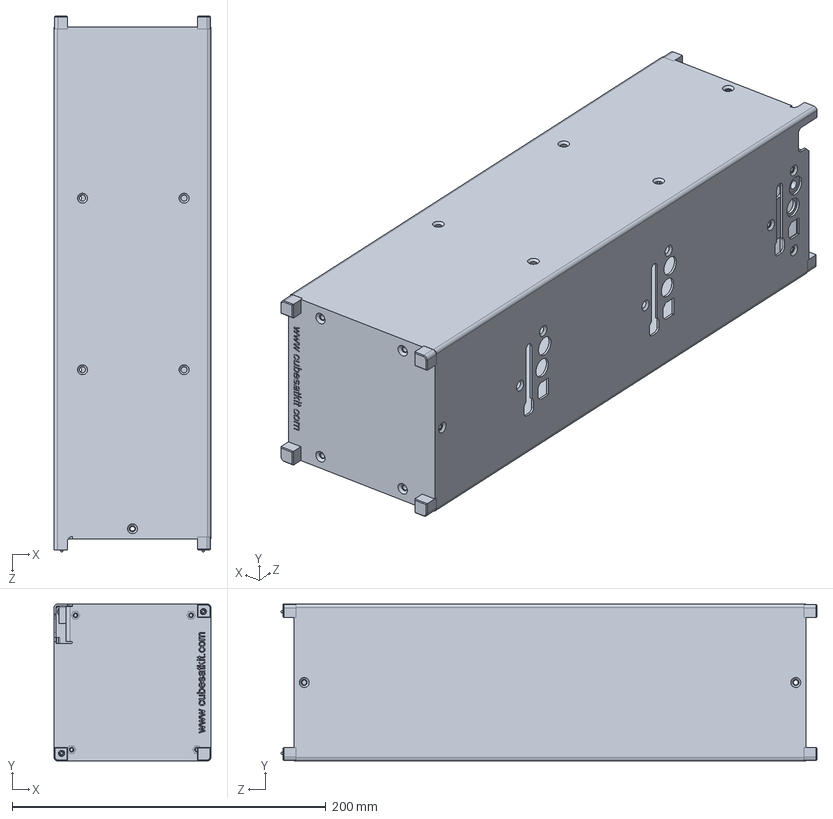
[picture p67: CAD file, 2015-11-14]
Asteroid 3U Mission - 2014-2015/CSK_3U_Chassis_Solid_RevC.SLDPRT
100.0 x 100.0 x 341.8 mm
