M2I-CySat/CySat-1-Structures/Asteroid 3U Mission-2015-2016/board block/Hack HD block.SLDPRT

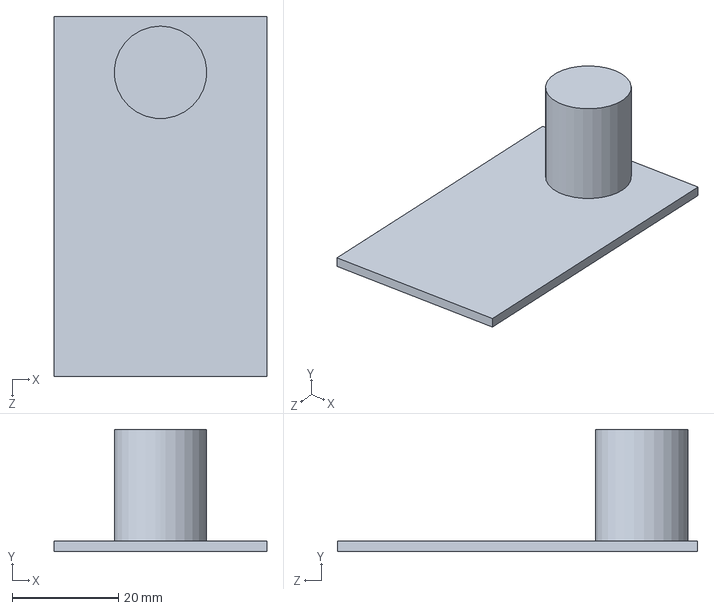
[picture p68: CAD file, 2016-01-23]
Asteroid 3U Mission-2015-2016/board block/Hack HD block.SLDPRT
40.0 x 23.0 x 67.7 mm
