M2I-CySat/CySat-1-Structures/Asteroid 3U Mission-2015-2016/Generalized model/csk_payload_adapter_plate_reva.SLDPRT

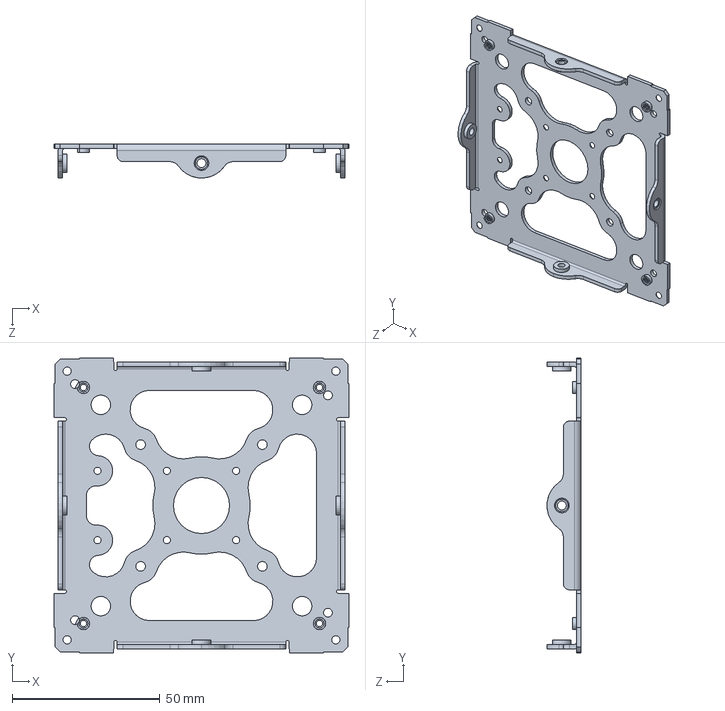
[picture p69: CAD file, 2016-04-09]
Asteroid 3U Mission-2015-2016/Generalized model/csk_payload_adapter_plate_reva.SLDPRT
100.0 x 100.0 x 11.6 mm
