M2I-CySat/CySat-1-Structures/CySAT Mission 1/SolidWorks 2-22-14/radiometer.SLDPRT

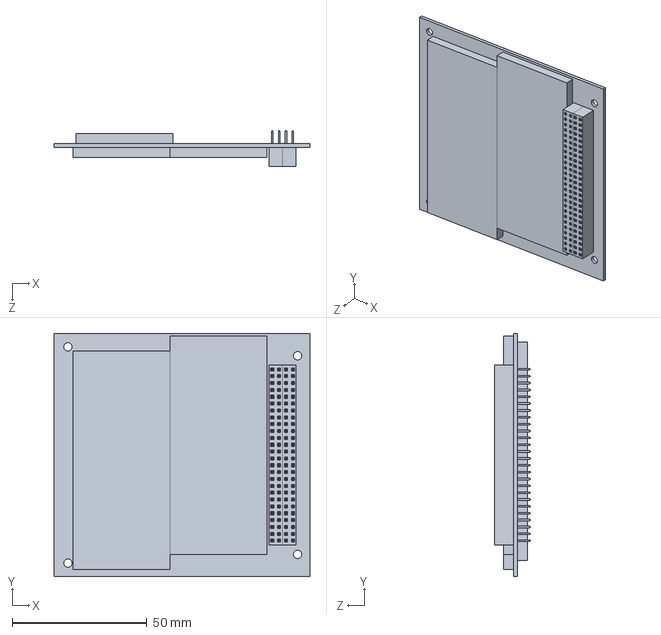
[picture p70: CAD file, 2015-09-26]
CySAT Mission 1/SolidWorks 2-22-14/radiometer.SLDPRT
94.9 x 90.2 x 13.3 mm
