M2I-CySat/CySat-1-Structures/CySAT Mission 1/SolidWorks 2-22-14/Spacers 2-22-14/Finished 2.35 cm.SLDPRT

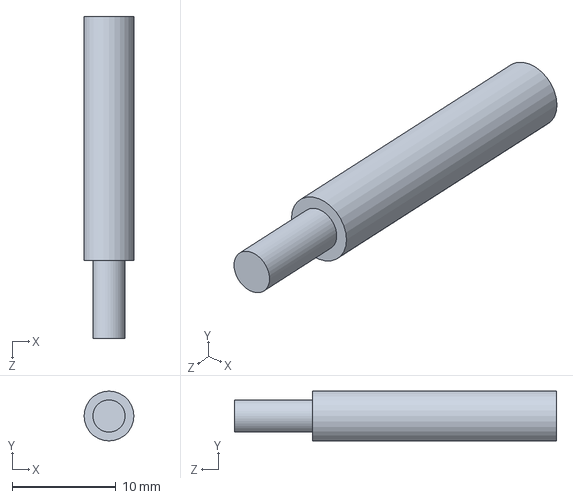
[picture p71: CAD file, 2015-09-26]
CySAT Mission 1/SolidWorks 2-22-14/Spacers 2-22-14/Finished 2.35 cm.SLDPRT
4.80 x 4.80 x 31.0 mm
