M2I-CySat/CySat-1-Structures/R.SLDPRT

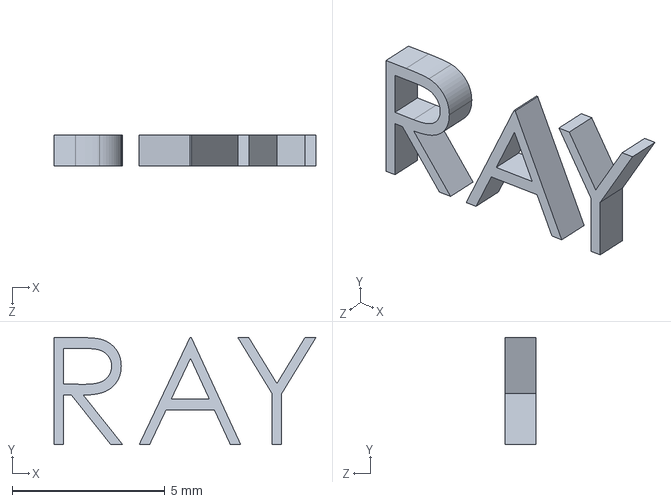
[picture p72: CAD file, 2014-09-20]
R.SLDPRT
8.56 x 3.50 x 1.00 mm
