M2I-CySat/CySat-1-Structures/2017-2017 Model/Side Panels/fore panel.SLDPRT

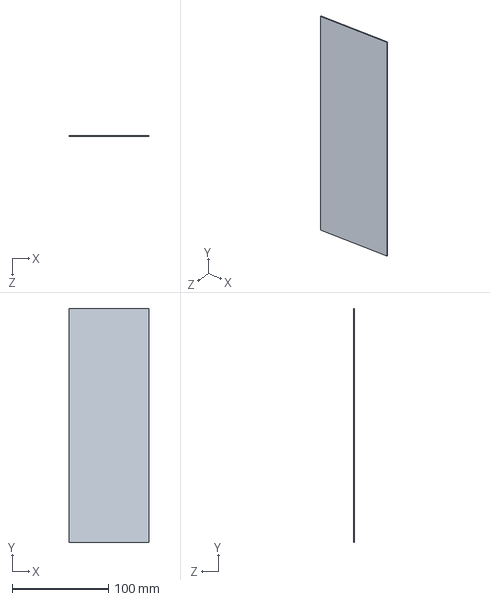
[picture p73: CAD file, 2016-10-22]
2017-2017 Model/Side Panels/fore panel.SLDPRT
83.0 x 243.0 x 1.00 mm
