M2I-CySat/CySat-1-Structures/Asteroid 3U Mission-2015-2016/Generalized model/3sided sidepanel 3d printable.SLDPRT

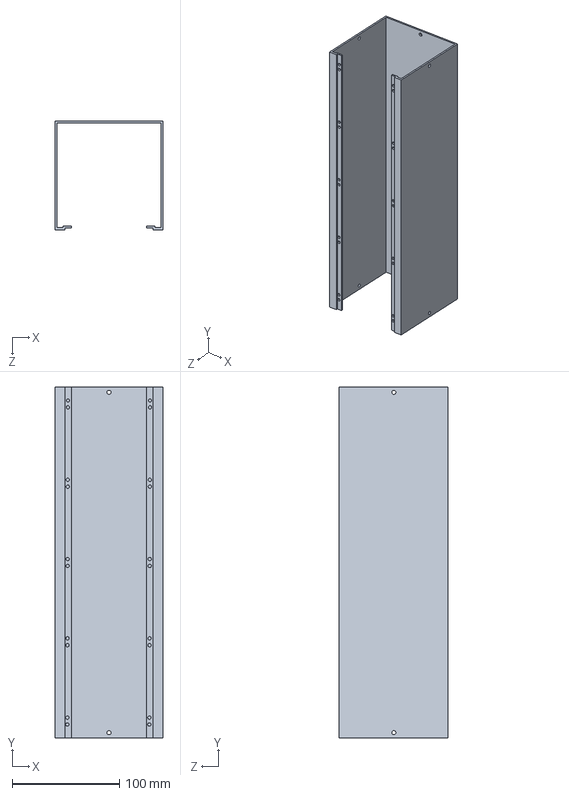
[picture p74: CAD file, 2016-04-09]
Asteroid 3U Mission-2015-2016/Generalized model/3sided sidepanel 3d printable.SLDPRT
101.2 x 327.5 x 101.8 mm
