M2I-CySat/CySat-1-Structures/CySAT Mission 1/SolidWorks 2-22-14/CSK_1U_Chassis_Skeleton_RevD.SLDPRT

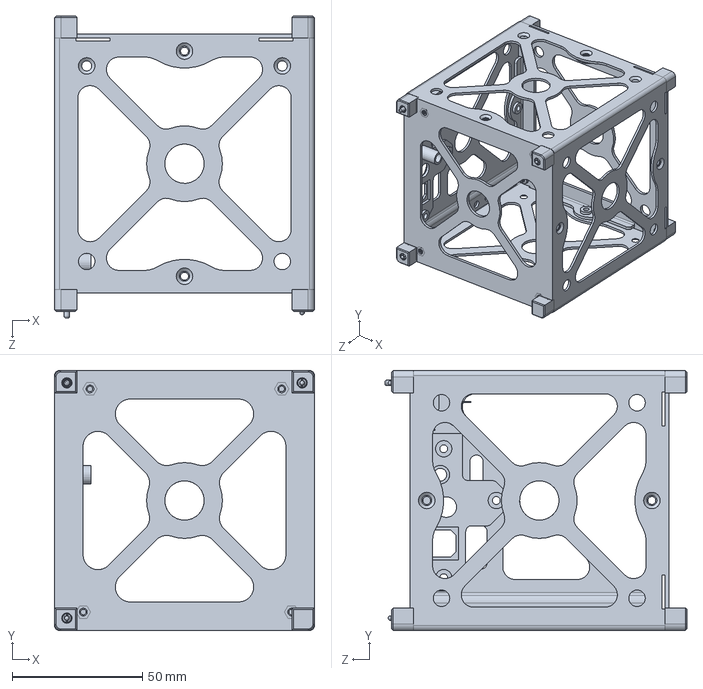
[picture p76: CAD file, 2015-09-26]
CySAT Mission 1/SolidWorks 2-22-14/CSK_1U_Chassis_Skeleton_RevD.SLDPRT
100.0 x 100.0 x 116.0 mm
