M2I-CySat/CySat-1-Structures/CySAT Mission 1/SolidWorks 2-22-14/Spacers 2-22-14/Finished 1.5 cm.SLDPRT

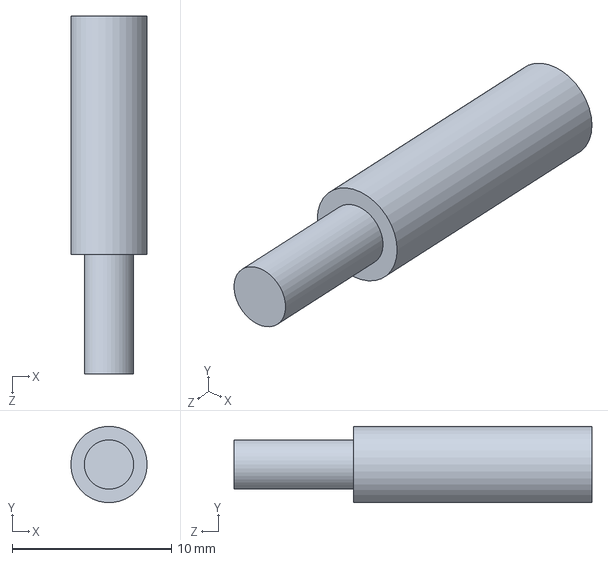
[picture p77: CAD file, 2015-09-26]
CySAT Mission 1/SolidWorks 2-22-14/Spacers 2-22-14/Finished 1.5 cm.SLDPRT
4.80 x 4.78 x 22.5 mm
