M2I-CySat/CySat-1-Structures/Asteroid 3U Mission - 2014-2015/board block/Reaction wheel block.SLDPRT

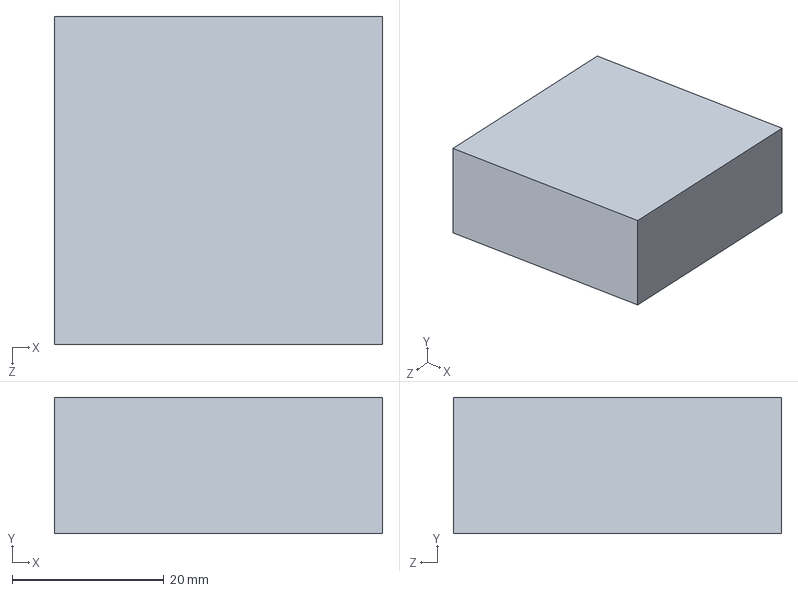
[picture p78: CAD file, 2016-01-22]
Asteroid 3U Mission - 2014-2015/board block/Reaction wheel block.SLDPRT
43.3 x 18.0 x 43.3 mm
