M2I-CySat/CySat-1-Structures/Asteroid 3U Mission-2015-2016/Generalized model/Top Panel components/Dipole.SLDPRT

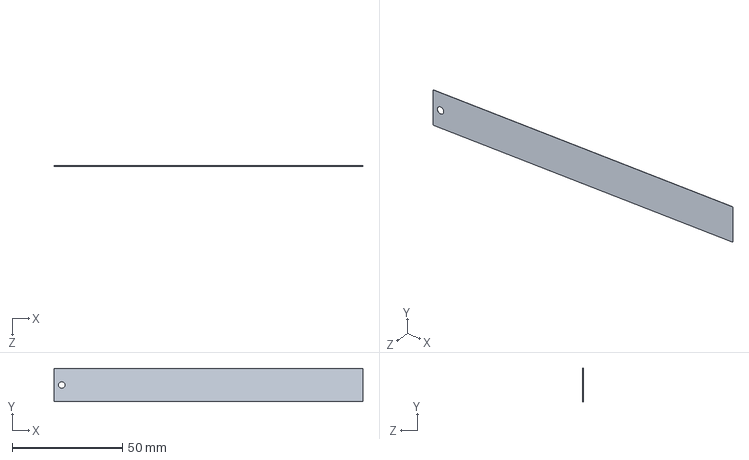
[picture p79: CAD file, 2015-10-31]
Asteroid 3U Mission-2015-2016/Generalized model/Top Panel components/Dipole.SLDPRT
140.0 x 15.0 x 0.1 mm
