M2I-CySat/CySat-1-Structures/CySAT Mission 1/SolidWorks 2-22-14/Spacers 2-22-14/1.7 cm part 1.SLDPRT

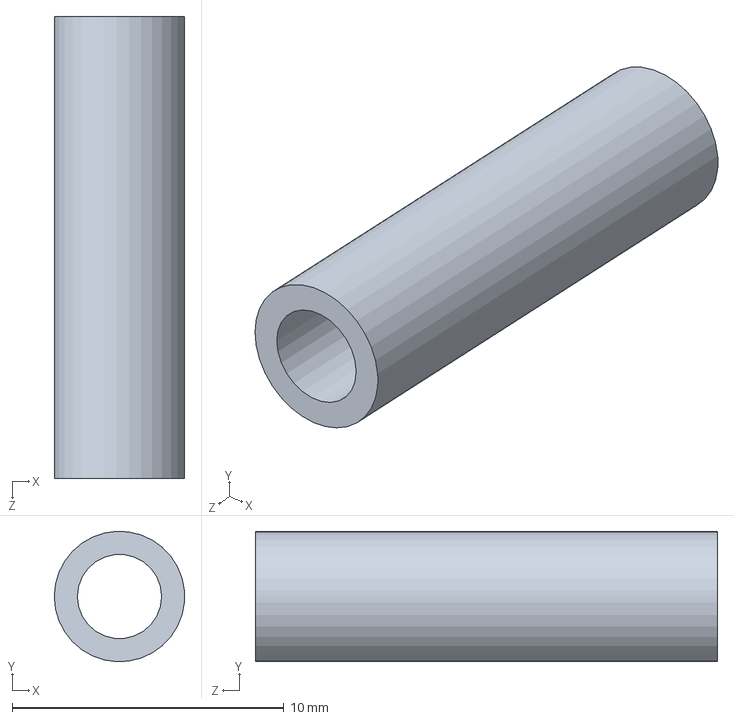
[picture p80: CAD file, 2014-10-18]
CySAT Mission 1/SolidWorks 2-22-14/Spacers 2-22-14/1.7 cm part 1.SLDPRT
4.80 x 4.79 x 17.0 mm
