M2I-CySat/CySat-1-Structures/Asteroid 3U Mission-2015-2016/board block/Attitude control board.SLDPRT

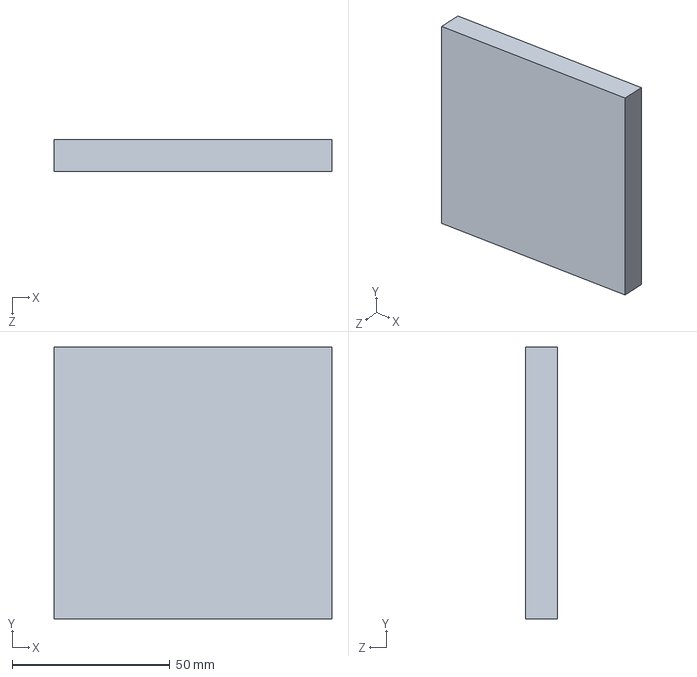
[picture p81: CAD file, 2016-01-23]
Asteroid 3U Mission-2015-2016/board block/Attitude control board.SLDPRT
88.0 x 86.0 x 10.0 mm
