M2I-CySat/CySat-1-Structures/Asteroid 3U Mission-2015-2016/Generalized model/3panelsidepanel 3dprintable.SLDPRT

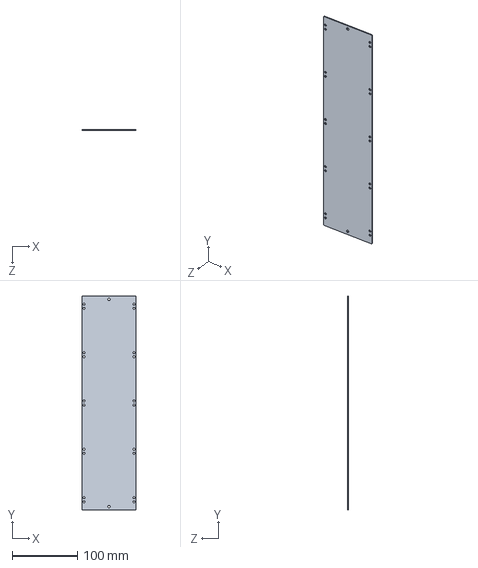
[picture p82: CAD file, 2016-04-09]
Asteroid 3U Mission-2015-2016/Generalized model/3panelsidepanel 3dprintable.SLDPRT
83.0 x 327.5 x 1.40 mm
