M2I-CySat/CySat-1-Structures/Asteroid 3U Mission-2015-2016/Generalized model/Top Panel components/Dipole_Antenna_Mount_Bottom.SLDPRT

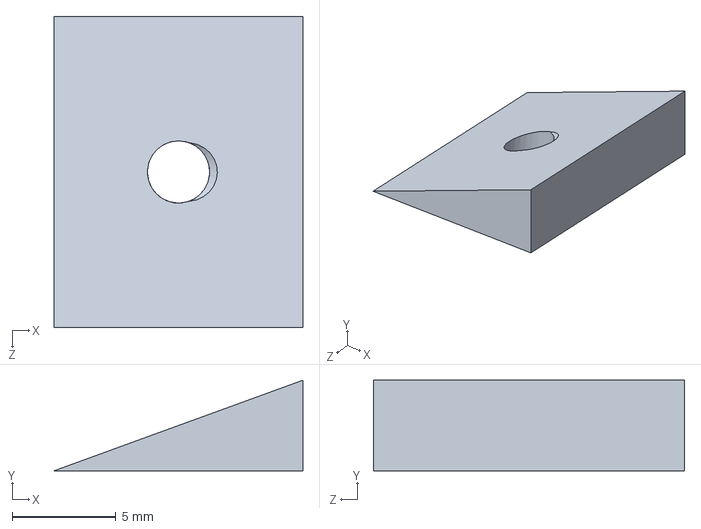
[picture p83: CAD file, 2015-10-31]
Asteroid 3U Mission-2015-2016/Generalized model/Top Panel components/Dipole_Antenna_Mount_Bottom.SLDPRT
12.0 x 4.37 x 15.0 mm
