M2I-CySat/CySat-1-Structures/CySAT Mission 1/SolidWorks 2-22-14/Spacers 2-22-14/bottom part of spacer.SLDPRT

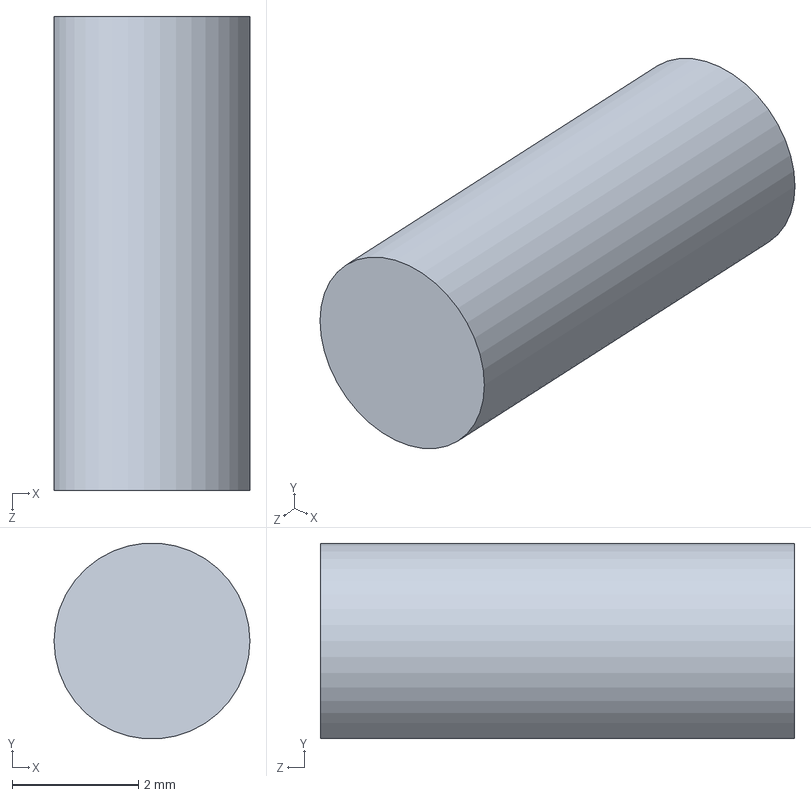
[picture p85: CAD file, 2014-10-18]
CySAT Mission 1/SolidWorks 2-22-14/Spacers 2-22-14/bottom part of spacer.SLDPRT
3.10 x 3.09 x 7.50 mm
