M2I-CySat/CySat-1-Structures/Asteroid 3U Mission-2015-2016/Generalized model/Top Panel components/Top_Panel_board.SLDPRT

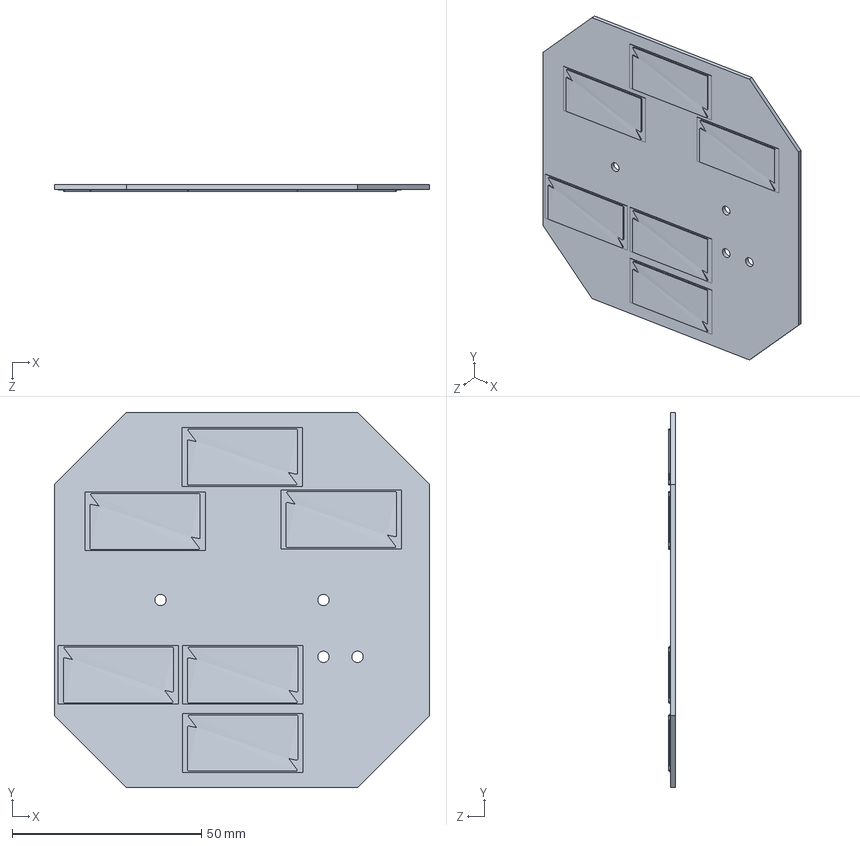
[picture p86: CAD file, 2015-09-26]
Asteroid 3U Mission-2015-2016/Generalized model/Top Panel components/Top_Panel_board.SLDPRT
99.0 x 99.0 x 1.85 mm
