M2I-CySat/CySat-1-Structures/Asteroid 3U Mission-2015-2016/Generalized model/Top Panel components/Top_Panel.SLDPRT

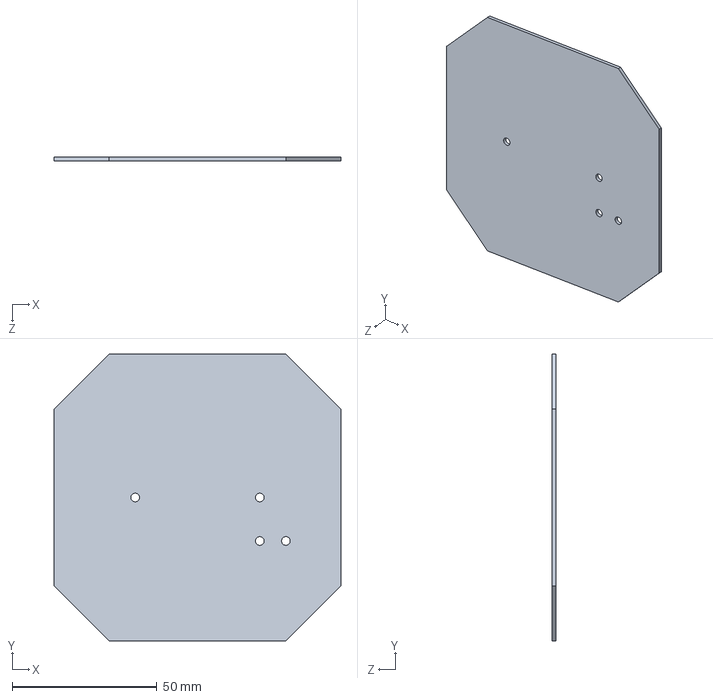
[picture p88: CAD file, 2014-09-20]
Asteroid 3U Mission-2015-2016/Generalized model/Top Panel components/Top_Panel.SLDPRT
99.0 x 99.0 x 1.30 mm
