M2I-CySat/CySat-1-Structures/CySAT Mission 1/SolidWorks 2-22-14/MSOP12___ _________1.sldprt

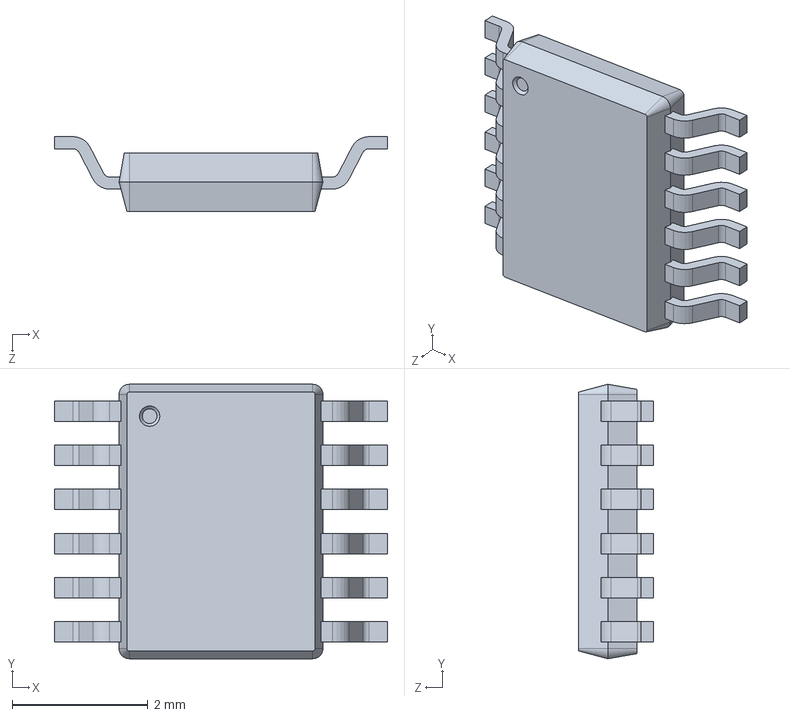
[picture p90: CAD file, 2014-10-18]
CySAT Mission 1/SolidWorks 2-22-14/MSOP12___ _________1.sldprt
4.90 x 4.04 x 1.10 mm
