M2I-CySat/CySat-1-Structures/CySAT Mission 1/SolidWorks 2-22-14/Spacers 2-22-14/1.55 cm.SLDPRT

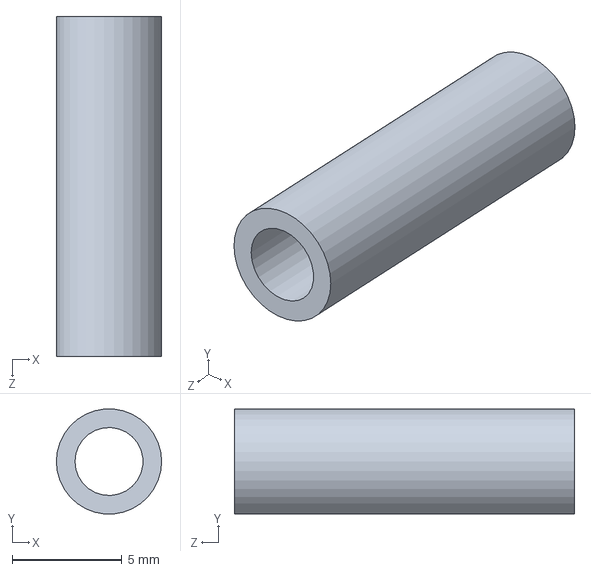
[picture p91: CAD file, 2014-10-18]
CySAT Mission 1/SolidWorks 2-22-14/Spacers 2-22-14/1.55 cm.SLDPRT
4.80 x 4.78 x 15.5 mm
