M2I-CySat/CySat-1-Structures/Asteroid 3U Mission-2015-2016/Generalized model/general_top_bottom.SLDPRT

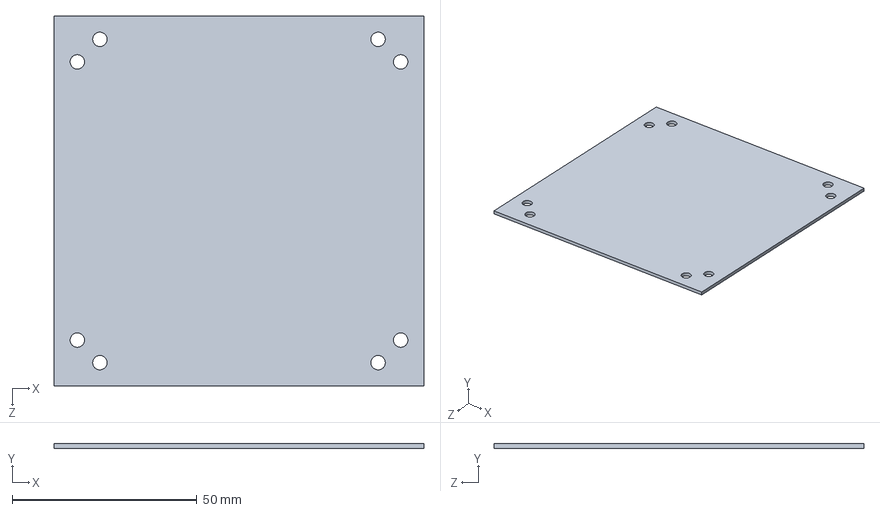
[picture p92: CAD file, 2016-02-27]
Asteroid 3U Mission-2015-2016/Generalized model/general_top_bottom.SLDPRT
100.0 x 1.30 x 100.0 mm
