M2I-CySat/CySat-1-Structures/Asteroid 3U Mission-2015-2016/Generalized model/Top Panel components/Taskcell.SLDPRT

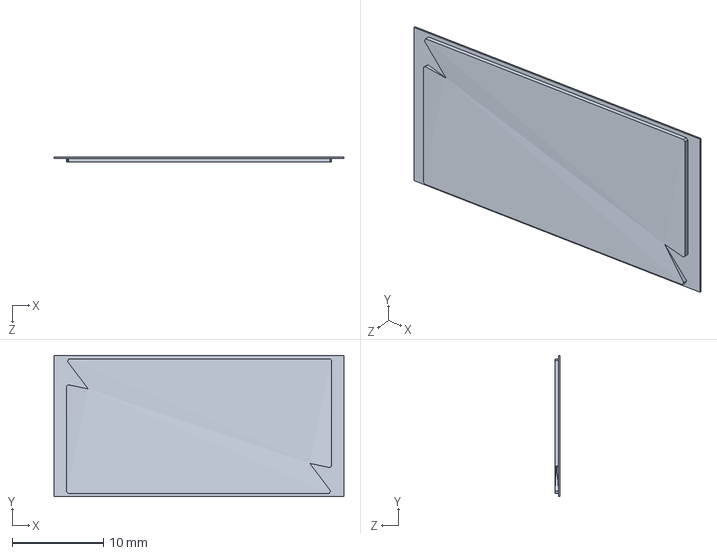
[picture p93: CAD file, 2014-09-20]
Asteroid 3U Mission-2015-2016/Generalized model/Top Panel components/Taskcell.SLDPRT
31.8 x 15.5 x 0.55 mm
