M2I-CySat/CySat-1-Structures/Asteroid 3U Mission-2015-2016/Generalized model/Newrails.SLDPRT

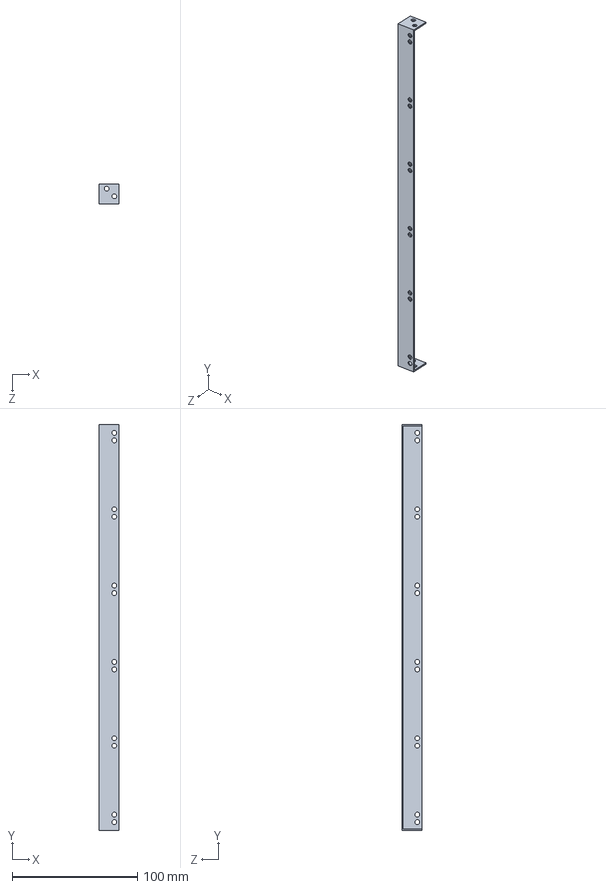
[picture p94: CAD file, 2016-02-27]
Asteroid 3U Mission-2015-2016/Generalized model/Newrails.SLDPRT
16.3 x 324.4 x 16.3 mm
