M2I-CySat/CySat-1-Structures/Asteroid 3U Mission-2015-2016/Generalized model/Sidepanel.SLDPRT

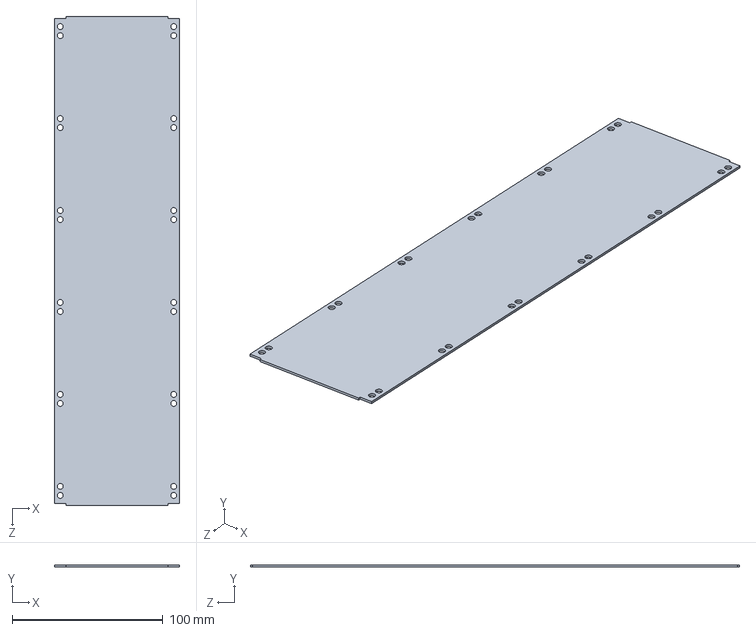
[picture p95: CAD file, 2016-02-20]
Asteroid 3U Mission-2015-2016/Generalized model/Sidepanel.SLDPRT
83.0 x 1.30 x 324.4 mm
