M2I-CySat/CySat-1-Structures/CySAT Mission 1/SolidWorks 2-22-14/3.7V BATTERY.sldprt

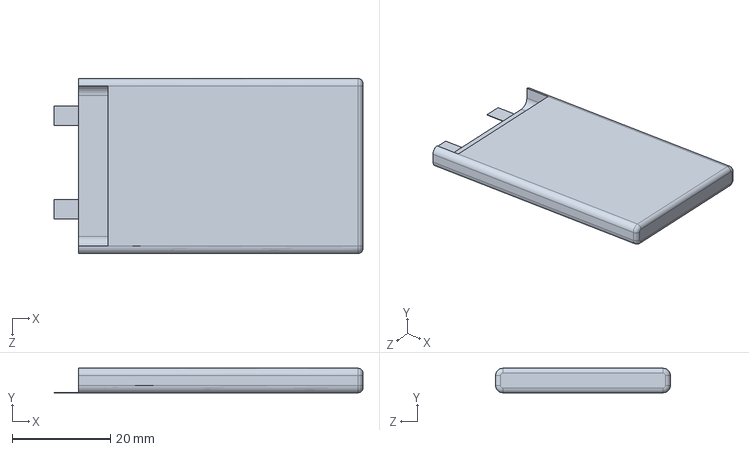
[picture p96: CAD file, 2014-10-18]
CySAT Mission 1/SolidWorks 2-22-14/3.7V BATTERY.sldprt
62.8 x 5.00 x 35.6 mm
