M2I-CySat/CySat-1-Structures/Asteroid 3U Mission-2015-2016/Generalized model/Rails.SLDPRT

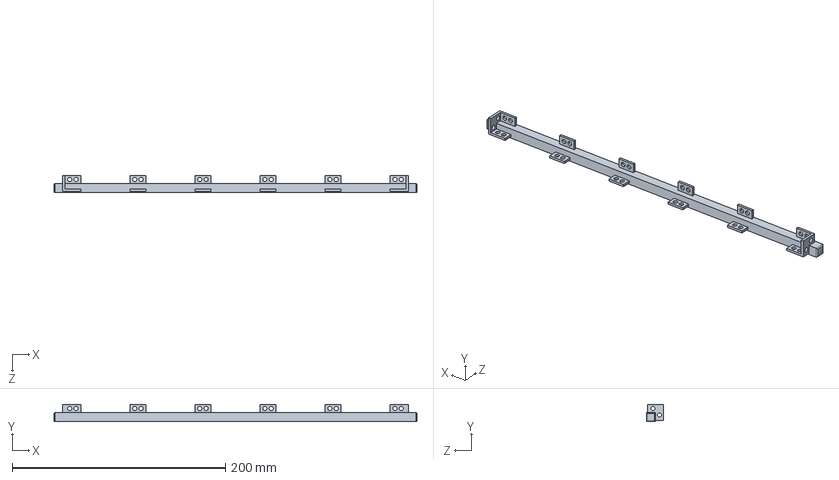
[picture p97: CAD file, 2016-02-20]
Asteroid 3U Mission-2015-2016/Generalized model/Rails.SLDPRT
340.5 x 16.3 x 16.3 mm
