M2I-CySat/CySat-1-Structures/CySAT Mission 1/SolidWorks 2-22-14/KX15-20K4DE-R1.sldprt

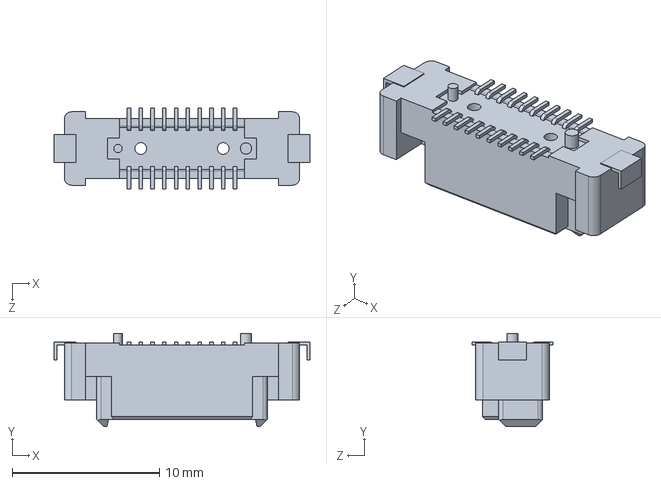
[picture p98: CAD file, 2014-10-18]
CySAT Mission 1/SolidWorks 2-22-14/KX15-20K4DE-R1.sldprt
17.4 x 6.35 x 5.50 mm
