M2I-CySat/CySat-1-Structures/CySAT Mission 1/SolidWorks 2-22-14/SO-8.sldprt

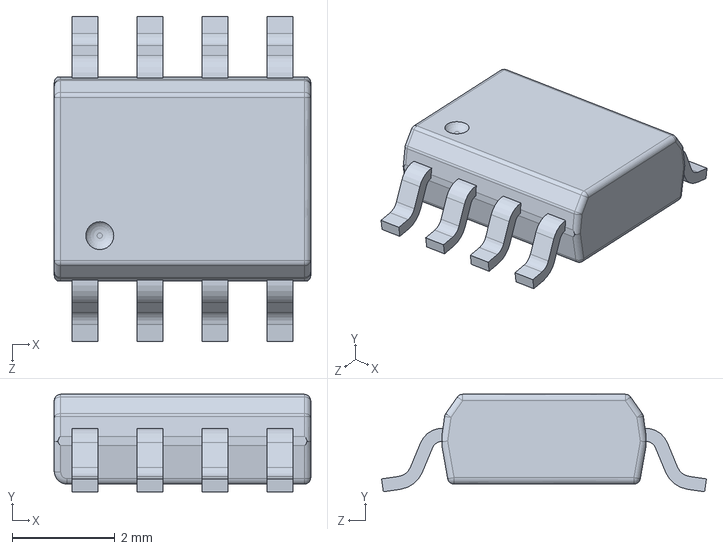
[picture p99: CAD file, 2014-10-18]
CySAT Mission 1/SolidWorks 2-22-14/SO-8.sldprt
5.00 x 1.90 x 6.34 mm
