M2I-CySat/CySat-1-Structures/CySAT Mission 1/SolidWorks 2-22-14/MSOP10_1.sldprt

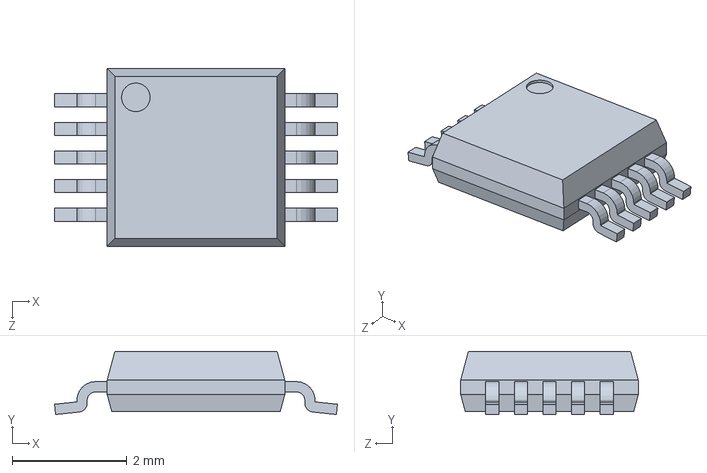
[picture p100: CAD file, 2014-10-18]
CySAT Mission 1/SolidWorks 2-22-14/MSOP10_1.sldprt
4.94 x 1.10 x 3.10 mm
