M2I-CySat/CySat-1-Structures/CySAT Mission 1/SolidWorks 2-22-14/3D-13-00247.sldprt

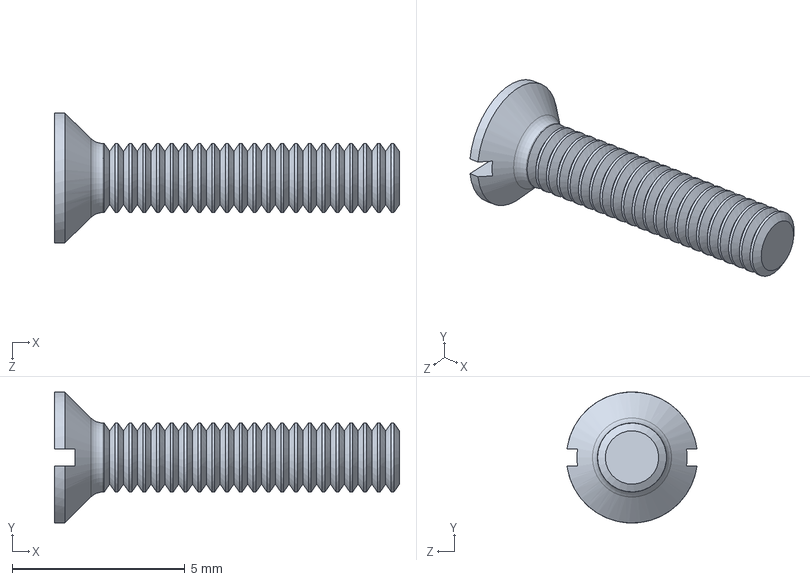
[picture p101: CAD file, 2014-10-18]
CySAT Mission 1/SolidWorks 2-22-14/3D-13-00247.sldprt
10.0 x 3.80 x 3.77 mm
