M2I-CySat/CySat-1-Structures/CySAT Mission 1/SolidWorks 2-22-14/SOT-23-5.sldprt

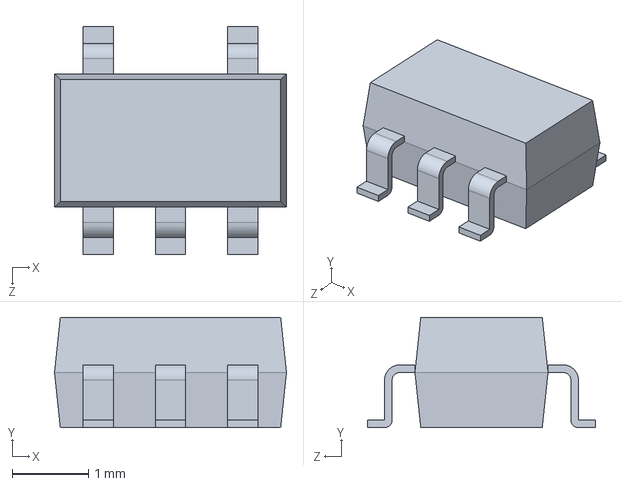
[picture p102: CAD file, 2014-10-18]
CySAT Mission 1/SolidWorks 2-22-14/SOT-23-5.sldprt
3.05 x 1.45 x 3.00 mm
