M2I-CySat/CySat-1-Structures/CySAT Mission 1/SolidWorks 2-22-14/minimelf_Domyslna.sldprt

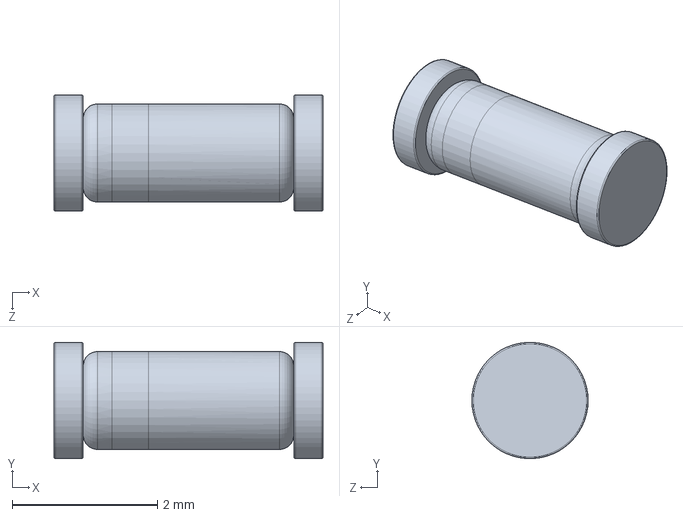
[picture p103: CAD file, 2014-10-18]
CySAT Mission 1/SolidWorks 2-22-14/minimelf_Domyslna.sldprt
3.70 x 1.60 x 1.60 mm
