M2I-CySat/CySat-1-Structures/CySAT Mission 1/SolidWorks 2-22-14/Motherboard.SLDPRT

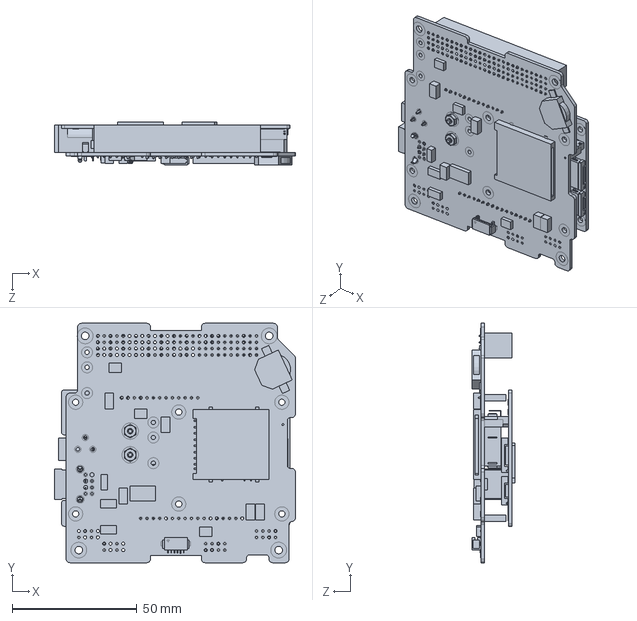
[picture p104: CAD file, 2014-10-18]
CySAT Mission 1/SolidWorks 2-22-14/Motherboard.SLDPRT
96.5 x 95.9 x 17.4 mm
