M2I-CySat/CySat-1-Structures/CySAT Mission 1/SolidWorks 2-22-14/R1206_1.sldprt

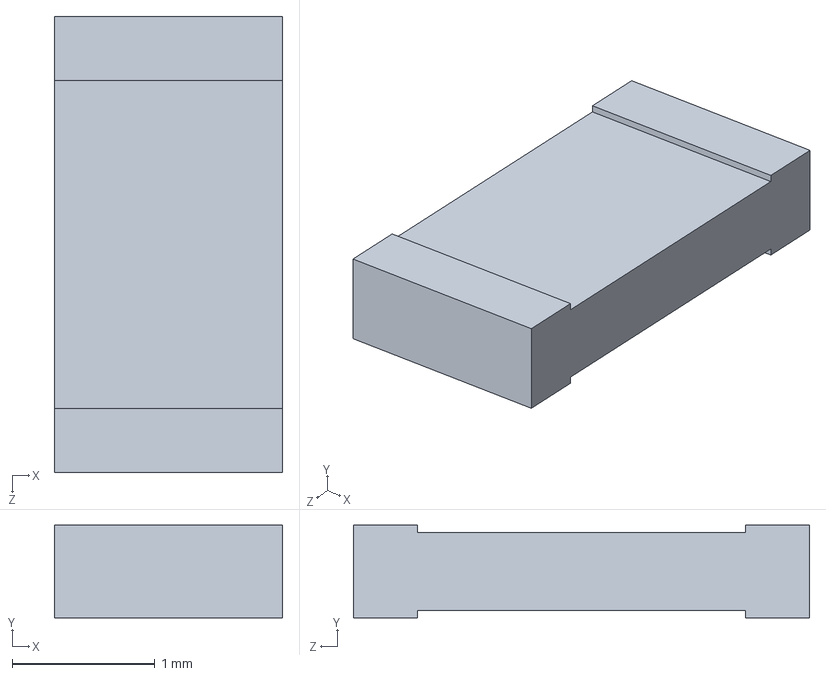
[picture p105: CAD file, 2014-10-18]
CySAT Mission 1/SolidWorks 2-22-14/R1206_1.sldprt
1.60 x 0.65 x 3.20 mm
