M2I-CySat/CySat-1-Structures/CySAT Mission 1/SolidWorks 2-22-14/DIODESMC_1.sldprt

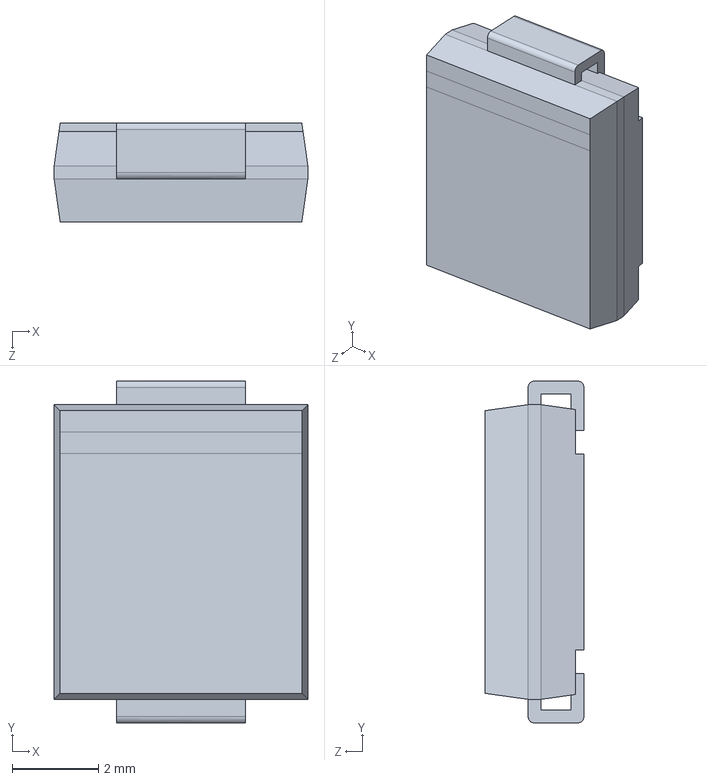
[picture p106: CAD file, 2014-10-18]
CySAT Mission 1/SolidWorks 2-22-14/DIODESMC_1.sldprt
5.90 x 7.95 x 2.30 mm
