M2I-CySat/CySat-1-Structures/CySAT Mission 1/SolidWorks 2-22-14/sot-223_1.sldprt

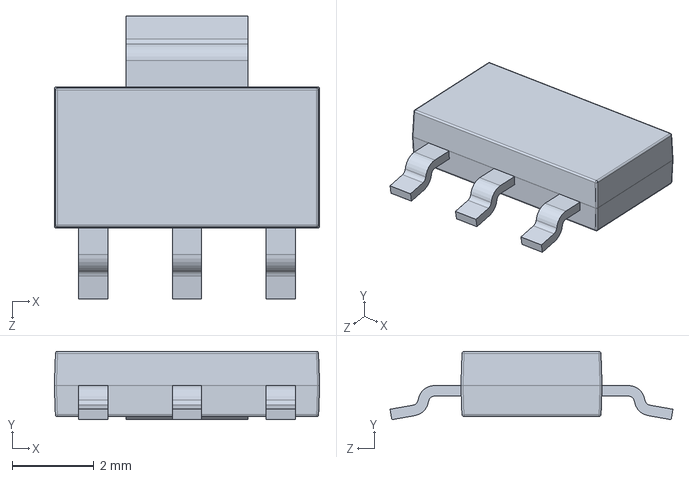
[picture p107: CAD file, 2014-10-18]
CySAT Mission 1/SolidWorks 2-22-14/sot-223_1.sldprt
6.50 x 1.67 x 6.93 mm
