M2I-CySat/CySat-1-Structures/CySAT Mission 1/SolidWorks 2-22-14/3D-13-00253.sldprt

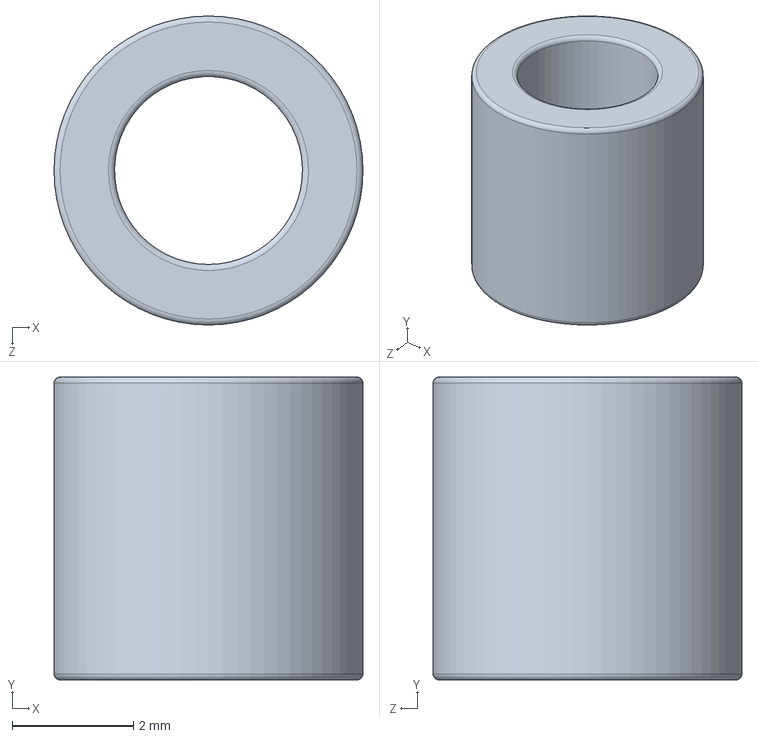
[picture p108: CAD file, 2014-10-18]
CySAT Mission 1/SolidWorks 2-22-14/3D-13-00253.sldprt
5.10 x 5.00 x 5.10 mm
