M2I-CySat/CySat-1-Structures/CySAT Mission 1/SolidWorks 2-22-14/ssop20_1.sldprt

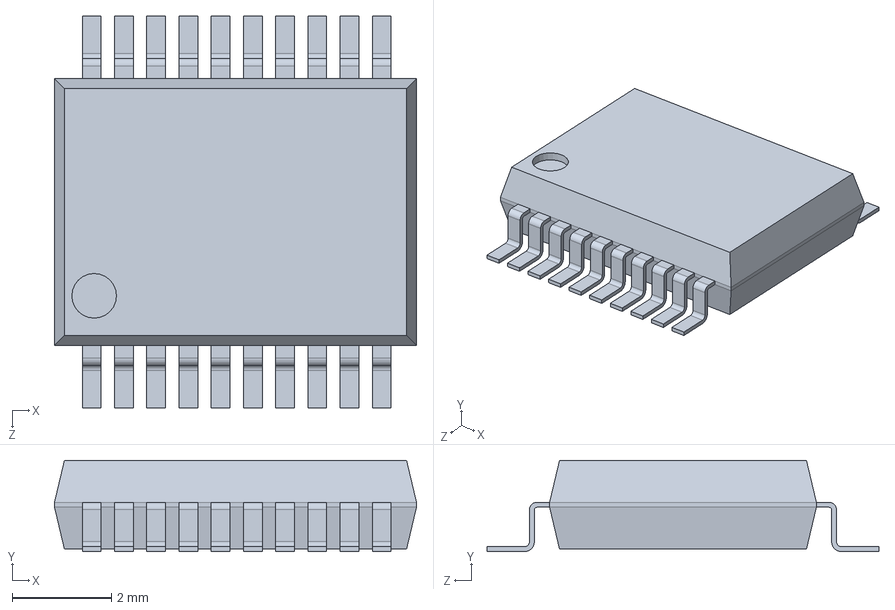
[picture p109: CAD file, 2014-10-18]
CySAT Mission 1/SolidWorks 2-22-14/ssop20_1.sldprt
7.30 x 1.84 x 7.90 mm
