M2I-CySat/CySat-1-Structures/CySAT Mission 1/SolidWorks 2-22-14/3D-11-00227-REVA.sldprt

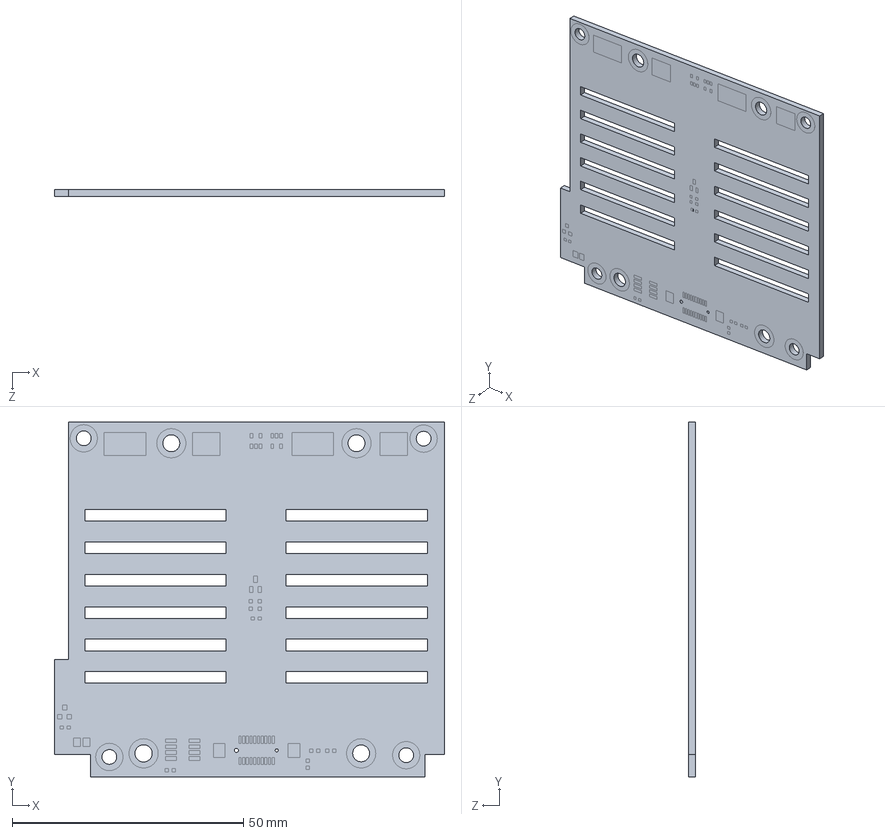
[picture p110: CAD file, 2014-10-18]
CySAT Mission 1/SolidWorks 2-22-14/3D-11-00227-REVA.sldprt
84.3 x 76.6 x 1.62 mm
