M2I-CySat/CySat-1-Structures/(list of files, cad)

Other CAD files:
Asteroid 3U Mission-2015-2016/Assem4.SLDASM
SolidWorks Main UND Model/Bottom panel components/solidwork part/Bottom_Panel_ASSY-1.SLDPRT
Asteroid 3U Mission - 2014-2015/solar panel assembly 2.SLDPRT
Asteroid 3U Mission-2015-2016/solar panel assembly 2.SLDPRT
CySAT Mission 1/SolidWorks 2-22-14/SidePanels/3D-25-00212-revA_1-5.sldasm
UND New Solidworks Parts/3D-25-00220-REVB.sldasm
CySAT Mission 1/SolidWorks 2-22-14/3D-25-00220-REVB_1.sldasm
UND New Solidworks Parts/3D-25-00211-revA.sldasm
CySAT Mission 1/SolidWorks 2-22-14/Bottom_Panel_ASSY-2.SLDASM
UND New Solidworks Parts/C0603.sldprt
2017-2017 Model/Rails/Connected rail no midcut left.SLDPRT
Asteroid 3U Mission-2015-2016/Generalized model/New folder/3sided sidepanel conex bottom half.SLDPRT
Asteroid 3U Mission-2015-2016/Solarcell.SLDPRT
UND New Solidworks Parts/3D-13-00246.sldprt
Asteroid 3U Mission-2015-2016/CSK_3U_Chassis_Solid_RevC.SLDPRT
Asteroid 3U Mission-2015-2016/Generalized model/Top Panel components/Mono_Antenna_Mount_Bottom.SLDPRT
UND New Solidworks Parts/SO-8.sldprt
Asteroid 3U Mission - 2014-2015/board block/Infared Spectormeter block.SLDPRT
Asteroid 3U Mission-2015-2016/board block/Power Batteries block.SLDPRT
CySAT Mission 1/SolidWorks 2-22-14/SidePanels/Side_panel_feb2.SLDPRT
UND New Solidworks Parts/R2512.sldprt
Asteroid 3U Mission - 2014-2015/diagnosticpannlea-1.SLDPRT
Asteroid 3U Mission-2015-2016/board block/CNDH block.SLDPRT
Asteroid 3U Mission-2015-2016/diagnosticpannlea-1.SLDPRT
Asteroid 3U Mission-2015-2016/Generalized model/3sided sidepanel.SLDPRT
CySAT Mission 1/SolidWorks 2-22-14/radiometer_assem.SLDPRT
UND New Solidworks Parts/C1206x1.9mm.sldprt
Asteroid 3U Mission - 2014-2015/board block/patch antenna.SLDPRT
UND New Solidworks Parts/QFN-14.sldprt
Asteroid 3U Mission - 2014-2015/board block/Hack HD block.SLDPRT
Asteroid 3U Mission-2015-2016/board block/EPS board block.SLDPRT
CySAT Mission 1/SolidWorks 2-22-14/minimelf_Domyslna_1.sldprt
UND New Solidworks Parts/3D-09-00156.sldprt
Asteroid 3U Mission - 2014-2015/board block/Attitude control board.SLDPRT
CySAT Mission 1/SolidWorks 2-22-14/3D-11-00227-REVA_1.sldprt
UND New Solidworks Parts/3D-09-00171.sldprt
UND New Solidworks Parts/TSSOP-8_AA (TSSOP-8).sldprt
CySAT Mission 1/SolidWorks 2-22-14/power.SLDPRT
UND New Solidworks Parts/3D-13-00245-REV02_COMPRESSED.sldprt
UND New Solidworks Parts/DIODESMC.sldprt
UND New Solidworks Parts/3D-13-00250.sldprt
UND New Solidworks Parts/R1206.sldprt
CySAT Mission 1/SolidWorks 2-22-14/KX15-20K4DE-R1_1.sldprt
UND New Solidworks Parts/C1210x2.8mm.sldprt
UND New Solidworks Parts/3D-13-00233.sldprt
UND New Solidworks Parts/C_TANT_C.sldprt
UND New Solidworks Parts/R0603.sldprt
UND New Solidworks Parts/3D-11-00224-REVA.sldprt
UND New Solidworks Parts/R0805.sldprt
UND New Solidworks Parts/minimelf_Domyslna.sldprt
UND New Solidworks Parts/MSOP10.sldprt
UND New Solidworks Parts/SOD-8.sldprt
UND New Solidworks Parts/C0805x1.52mm.sldprt
UND New Solidworks Parts/MSOP12___ _________.sldprt
UND New Solidworks Parts/KX15-20K4DE-R1.sldprt
UND New Solidworks Parts/sot-223.sldprt
CySAT Mission 1/SolidWorks 2-22-14/K3D-KX15-20K3DE-R1 JAE_1.sldprt
UND New Solidworks Parts/DF13-6P-125-DSA.sldprt
CySAT Mission 1/SolidWorks 2-22-14/3.7V BATTERY_1.sldprt
CySAT Mission 1/SolidWorks 2-22-14/3D-05-00154_1.SLDPRT
CySAT Mission 1/SolidWorks 2-22-14/3D-09-00156_1.sldprt
CySAT Mission 1/SolidWorks 2-22-14/3D-09-00171_1.SLDPRT
CySAT Mission 1/SolidWorks 2-22-14/3D-09-00172_1.SLDPRT
CySAT Mission 1/SolidWorks 2-22-14/3D-13-00191_ISO 7380 - M3 x 12 --- 12N.sldprt
CySAT Mission 1/SolidWorks 2-22-14/3D-13-00197_PreviewCfg.sldprt
CySAT Mission 1/SolidWorks 2-22-14/3D-13-00233_1.sldprt
CySAT Mission 1/SolidWorks 2-22-14/3D-13-00245-REV02_COMPRESSED.sldprt
CySAT Mission 1/SolidWorks 2-22-14/3D-13-00246.sldprt
CySAT Mission 1/SolidWorks 2-22-14/3D-13-00246_1.sldprt
CySAT Mission 1/SolidWorks 2-22-14/3S-11-00224-REVA.SLDPRT
CySAT Mission 1/SolidWorks 2-22-14/Bottom_Panel-1.SLDPRT
CySAT Mission 1/SolidWorks 2-22-14/C0603.sldprt
CySAT Mission 1/SolidWorks 2-22-14/C0603_1.sldprt
CySAT Mission 1/SolidWorks 2-22-14/C0805x1.52mm_1.sldprt
CySAT Mission 1/SolidWorks 2-22-14/C1206x1.9mm_1.sldprt
CySAT Mission 1/SolidWorks 2-22-14/C1210x2.8mm_1.sldprt
CySAT Mission 1/SolidWorks 2-22-14/CSK_Stacking_Bus_Connector.SLDPRT
CySAT Mission 1/SolidWorks 2-22-14/C_TANT_A_1.sldprt
CySAT Mission 1/SolidWorks 2-22-14/C_TANT_C_1.sldprt
CySAT Mission 1/SolidWorks 2-22-14/DF13-6P-125-DSA_1.sldprt
CySAT Mission 1/SolidWorks 2-22-14/ESQ-126-14-X-D.sldprt
CySAT Mission 1/SolidWorks 2-22-14/ESQ-126-39-X-D_1.sldprt
CySAT Mission 1/SolidWorks 2-22-14/Heatsink_He.sldprt
CySAT Mission 1/SolidWorks 2-22-14/K3D-KX15-20K3DE-R1 JAE.sldprt
CySAT Mission 1/SolidWorks 2-22-14/KX14-20K2DE.sldprt
CySAT Mission 1/SolidWorks 2-22-14/KX14-20K2DE_1.sldprt
CySAT Mission 1/SolidWorks 2-22-14/Monopole_Antenna_Mount_Bottom.SLDPRT
CySAT Mission 1/SolidWorks 2-22-14/PCB.sldprt
CySAT Mission 1/SolidWorks 2-22-14/QFN-14_1.sldprt
CySAT Mission 1/SolidWorks 2-22-14/R0603.sldprt
CySAT Mission 1/SolidWorks 2-22-14/R0603_1-1.sldprt
CySAT Mission 1/SolidWorks 2-22-14/R0603_1.sldprt
CySAT Mission 1/SolidWorks 2-22-14/R0805.sldprt
CySAT Mission 1/SolidWorks 2-22-14/R0805_1.sldprt
CySAT Mission 1/SolidWorks 2-22-14/R1218_1.sldprt
CySAT Mission 1/SolidWorks 2-22-14/R2512.sldprt
CySAT Mission 1/SolidWorks 2-22-14/R2512_1.sldprt
CySAT Mission 1/SolidWorks 2-22-14/SMA-J-P-X-RA-TH1.sldprt
CySAT Mission 1/SolidWorks 2-22-14/SMDC260F-12.sldprt
CySAT Mission 1/SolidWorks 2-22-14/SMDC260F-12_1.sldprt
CySAT Mission 1/SolidWorks 2-22-14/SO-8_1.sldprt
CySAT Mission 1/SolidWorks 2-22-14/SOD-8_1.sldprt
CySAT Mission 1/SolidWorks 2-22-14/SOT-23-5_1.sldprt
CySAT Mission 1/SolidWorks 2-22-14/SOT-23.sldprt
CySAT Mission 1/SolidWorks 2-22-14/SOT-23_1.sldprt
CySAT Mission 1/SolidWorks 2-22-14/SidePanels/Solidworks parts/3D-25-00212-revA_1-5.SLDPRT
CySAT Mission 1/SolidWorks 2-22-14/SidePanels/Solidworks parts/3D-25-00212-revA_1-6.SLDPRT
CySAT Mission 1/SolidWorks 2-22-14/SidePanels/Solidworks parts/3D-25-00214-revA_1-2.sldasm
CySAT Mission 1/SolidWorks 2-22-14/Solar_Panel_Clip.SLDPRT
CySAT Mission 1/SolidWorks 2-22-14/TQFP-48_1.sldprt
CySAT Mission 1/SolidWorks 2-22-14/TSSOP-8_AA (TSSOP-8).sldprt
CySAT Mission 1/SolidWorks 2-22-14/TSSOP-8_AA (TSSOP-8)_1.sldprt
SolidWorks Main UND Model/Spacers 2-22-14/Finished 1.5 cm.SLDPRT
SolidWorks Main UND Model/Spacers 2-22-14/Finished 1.55 cm.SLDPRT
SolidWorks Main UND Model/Spacers 2-22-14/Finished 1.7 cm.SLDPRT
SolidWorks Main UND Model/Spacers 2-22-14/Finished 2.35 cm.SLDPRT
SolidWorks Main UND Model/Top Panel components/Dipole.SLDPRT
SolidWorks Main UND Model/Top Panel components/Dipole_Antenna_Mount_Bottom.SLDPRT
SolidWorks Main UND Model/Top Panel components/Dipole_Antenna_Mount_Top.SLDPRT
SolidWorks Main UND Model/Top Panel components/Mono_Antenna_Mount_Bottom.SLDPRT
SolidWorks Main UND Model/Top Panel components/Mono_Antenna_Mount_Top.SLDPRT
SolidWorks Main UND Model/Top Panel components/Monopole.SLDPRT
SolidWorks Main UND Model/Top Panel components/Top_Panel.SLDPRT
SolidWorks Main UND Model/Top Panel components/Top_Panel_board.SLDPRT
SolidWorks Top Panel DO NOT EDIT!!!!/Dipole.SLDPRT
SolidWorks Top Panel DO NOT EDIT!!!!/Dipole_Antenna_Mount_Bottom.SLDPRT
SolidWorks Top Panel DO NOT EDIT!!!!/Dipole_Antenna_Mount_Top.SLDPRT
SolidWorks Top Panel DO NOT EDIT!!!!/Mono_Antenna_Mount_Top.SLDPRT
SolidWorks Top Panel DO NOT EDIT!!!!/Monopole.SLDPRT
SolidWorks Top Panel DO NOT EDIT!!!!/Top_Panel_board.SLDPRT
TECHNICAL DRAWINGS/New Diagnostic Panel and top panel.SLDDRW
UND New Solidworks Parts/3.7V BATTERY.sldprt
UND New Solidworks Parts/3D-05-00154.sldprt
UND New Solidworks Parts/3D-09-00172.sldprt
UND New Solidworks Parts/3D-11-00227-REVA.sldprt
UND New Solidworks Parts/3D-13-00197_PreviewCfg.sldprt
UND New Solidworks Parts/3D-13-00247.sldprt
UND New Solidworks Parts/3D-13-00253.sldprt
UND New Solidworks Parts/B18.2.4.1M - Hex nut, Style 1, M2.5 x 0.45 --D-S.sldprt
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
