M2I-CySat/CySat-1-Structures/Bottom Panel.PDF

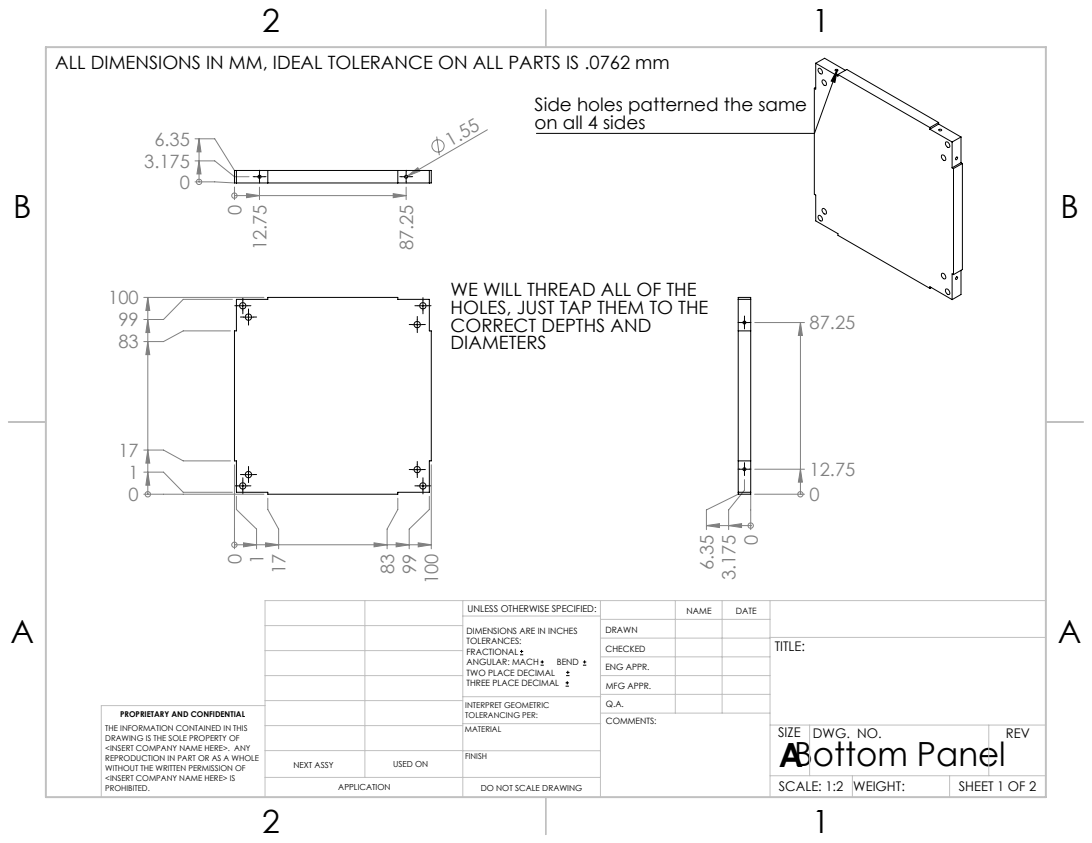
[picture p119: page 1]

ALL DIMENSIONS IN MM, IDEAL TOLERANCE ON ALL PARTS IS .0762 mm

Side holes patterned the same
on all 4 sides

WE WILL THREAD ALL OF THE
HOLES, JUST TAP THEM TO THE
CORRECT DEPTHS AND
DIAMETERS

UNLESS OTHERWISE SPECIFIED: | | NAME | DATE
DIMENSIONS ARE IN INCHES TOLERANCES: FRACTIONAL ANGULAR: MACH BEND TWO PLACE DECIMAL THREE PLACE DECIMAL | DRAWN

CHECKED | | | TITLE:

ENG APPR.
MFG APPR.

INTERPRET GEOMETRIC TOLERANCING PER: | Q.A.
MATERIAL | | SIZE A Bottom Panel | DWG. NO. | REV

PROPRIETARY AND CONFIDENTIAL
THE INFORMATION CONTAINED IN THIS
DRAWING IS THE SOLE PROPERTY OF
<INSERT COMPANY NAME HERE>. ANY
REPRODUCTION IN PART OR AS A WHOLE
WITHOUT THE WRITTEN PERMISSION OF
<INSERT COMPANY NAME HERE> IS
PROHIBITED.

NEXT ASSY | USED ON | FINISH

APPLICATION | DO NOT SCALE DRAWING | | SCALE: 1:2 | WEIGHT: | SHEET 1 OF 2

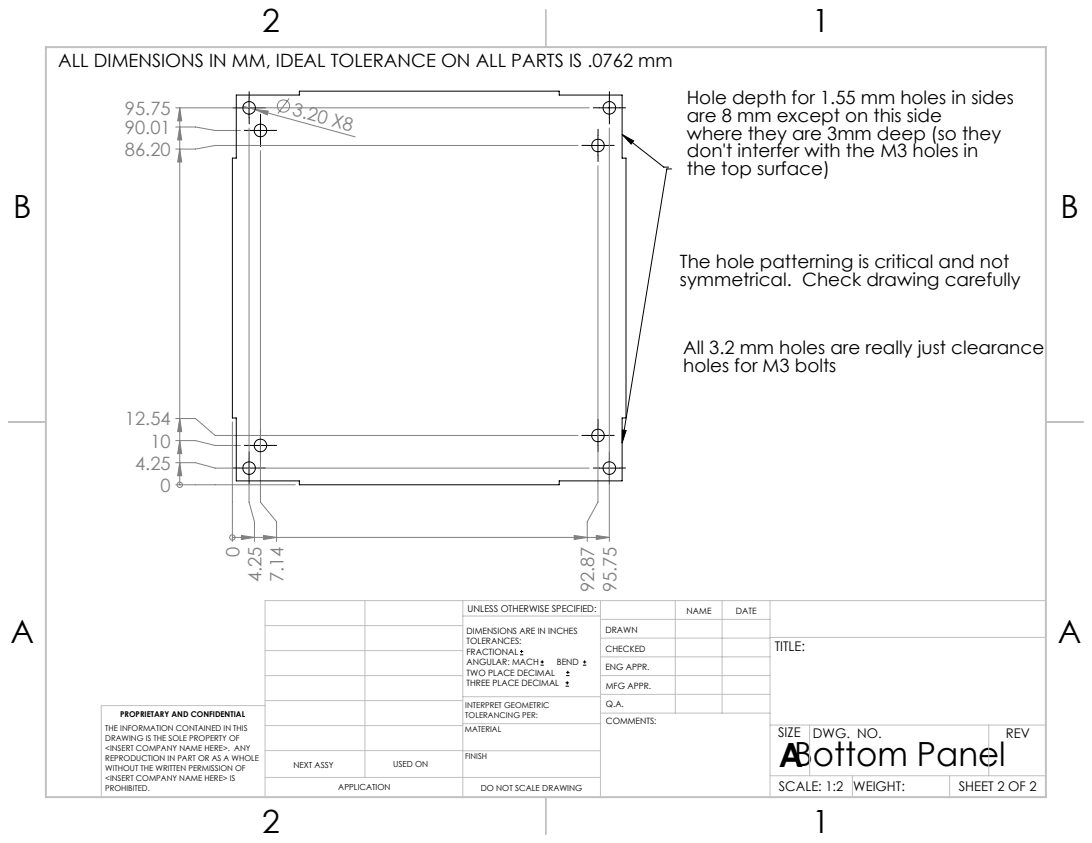
[picture p120: page 2]

ALL DIMENSIONS IN MM, IDEAL TOLERANCE ON ALL PARTS IS .0762 mm

Hole depth for 1.55 mm holes in sides
are 8 mm except on this side
where they are 3mm deep (so they
don't interfer with the M3 holes in
the top surface)

The hole patterning is critical and not
symmetrical. Check drawing carefully

All 3.2 mm holes are really just clearance
holes for M3 bolts

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

CHECKED | | | TITLE:

ENG APPR.
MFG APPR.

INTERPRET GEOMETRIC TOLERANCING PER: | Q.A.
MATERIAL | | SIZE A Bottom Panel | DWG. NO. | REV

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

NEXT ASSY | USED ON | FINISH

APPLICATION | DO NOT SCALE DRAWING | | SCALE: 1:2 | WEIGHT: | SHEET 2 OF 2
