M2I-CySat/CySat-1-Structures/Internal Panel Threaded.PDF

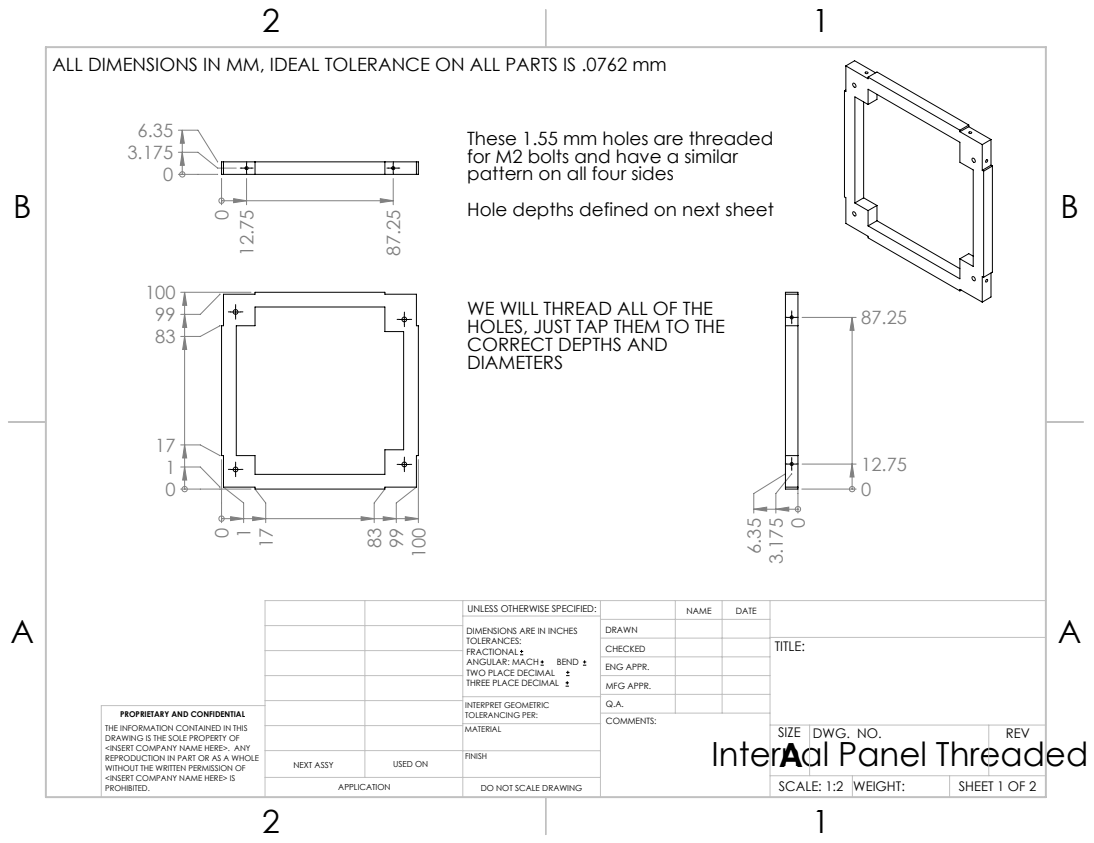
[picture p121: page 1]
Internal Panel Threaded

ALL DIMENSIONS IN MM, IDEAL TOLERANCE ON ALL PARTS IS .0762 mm

These 1.55 mm holes are threaded
for M2 bolts and have a similar
pattern on all four sides
Hole depths defined on next sheet

WE WILL THREAD ALL OF THE
HOLES, JUST TAP THEM TO THE
CORRECT DEPTHS AND
DIAMETERS

UNLESS OTHERWISE SPECIFIED: | | NAME | DATE
DIMENSIONS ARE IN INCHES TOLERANCES: FRACTIONAL ANGULAR: MACH BEND TWO PLACE DECIMAL THREE PLACE DECIMAL | DRAWN

CHECKED | | | TITLE:

ENG APPR.
MFG APPR.

INTERPRET GEOMETRIC TOLERANCING PER: | Q.A.
MATERIAL | | SIZE A | DWG. NO. | REV

PROPRIETARY AND CONFIDENTIAL
THE INFORMATION CONTAINED IN THIS
DRAWING IS THE SOLE PROPERTY OF
<INSERT COMPANY NAME HERE>. ANY
REPRODUCTION IN PART OR AS A WHOLE
WITHOUT THE WRITTEN PERMISSION OF
<INSERT COMPANY NAME HERE> IS
PROHIBITED.

NEXT ASSY | USED ON | FINISH

APPLICATION | DO NOT SCALE DRAWING | | SCALE: 1:2 | WEIGHT: | SHEET 1 OF 2

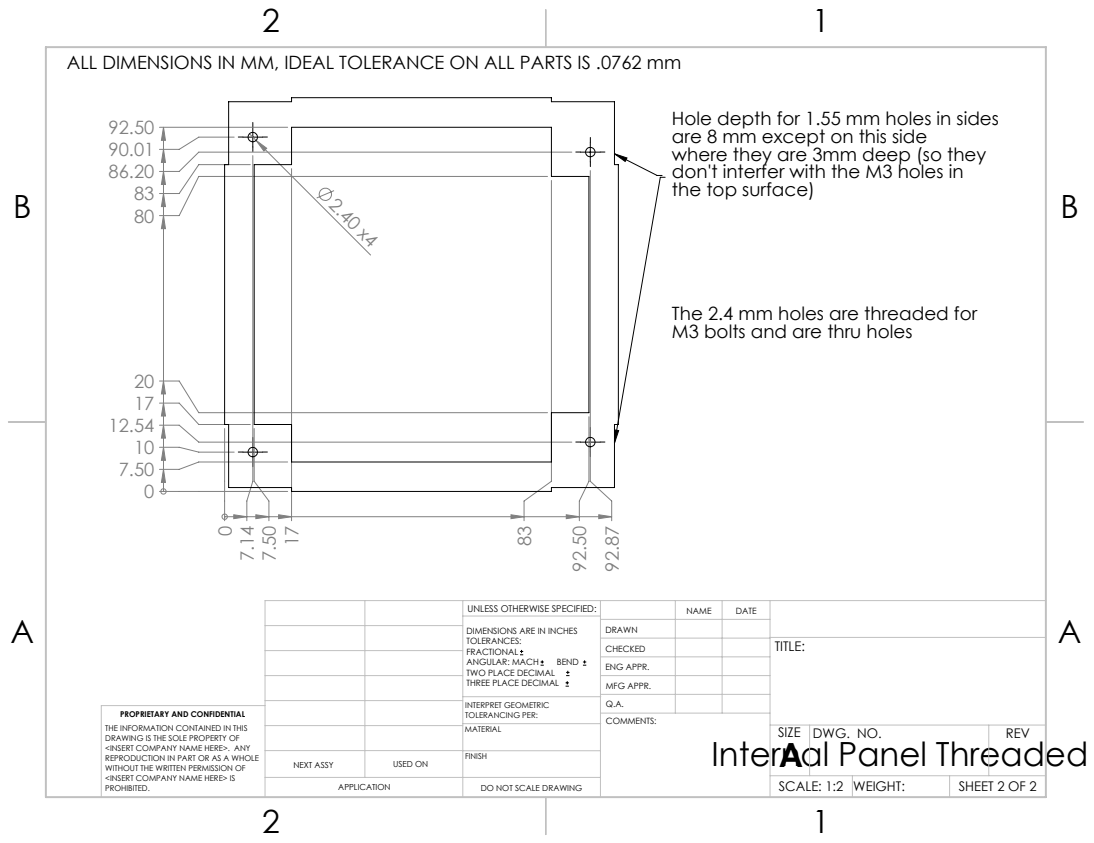
[picture p122: page 2]
Internal Panel Threaded

ALL DIMENSIONS IN MM, IDEAL TOLERANCE ON ALL PARTS IS .0762 mm

Hole depth for 1.55 mm holes in sides
are 8 mm except on this side
where they are 3mm deep (so they
don't interfer with the M3 holes in
the top surface)

The 2.4 mm holes are threaded for
M3 bolts and are thru holes

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

CHECKED | | | TITLE:

ENG APPR.
MFG APPR.

INTERPRET GEOMETRIC TOLERANCING PER: | Q.A.
MATERIAL | | SIZE A | DWG. NO. | REV

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

NEXT ASSY | USED ON | FINISH

APPLICATION | DO NOT SCALE DRAWING | | SCALE: 1:2 | WEIGHT: | SHEET 2 OF 2
