M2I-CySat/CySat-1-Structures/Top Panel.PDF

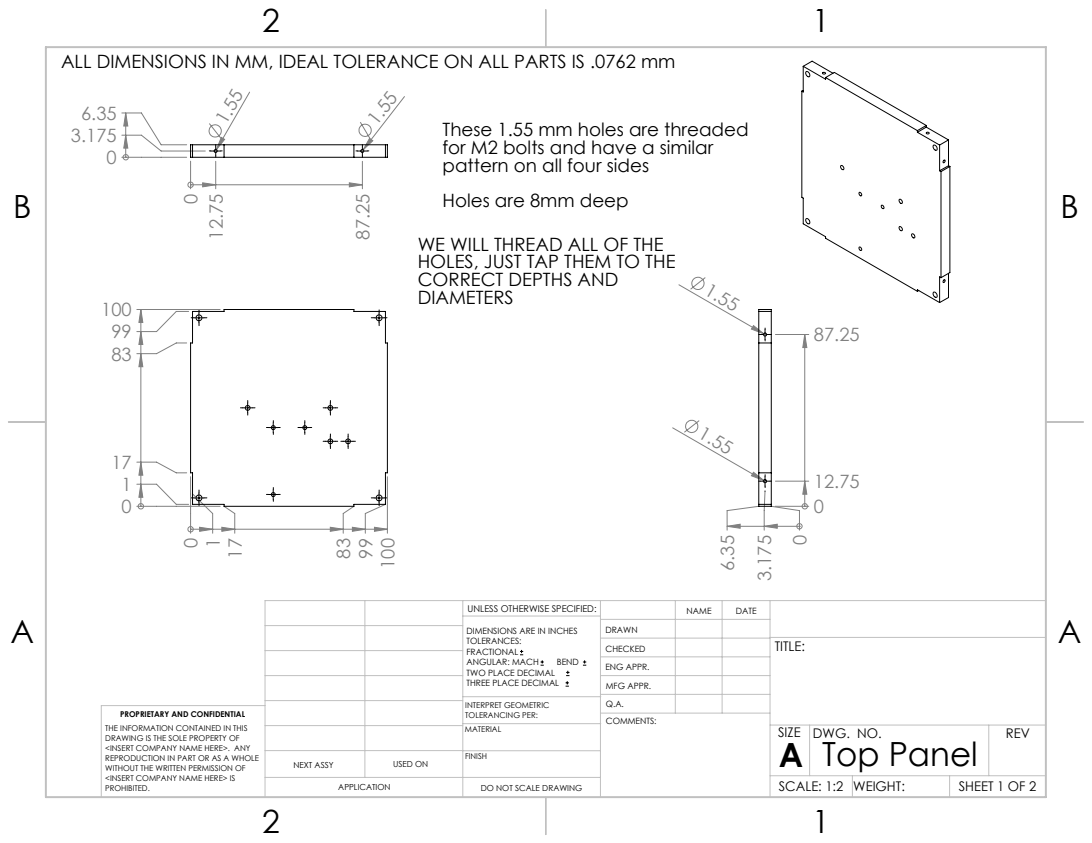
[picture p123: page 1]

ALL DIMENSIONS IN MM, IDEAL TOLERANCE ON ALL PARTS IS .0762 mm

These 1.55 mm holes are threaded
for M2 bolts and have a similar
pattern on all four sides
Holes are 8mm deep
WE WILL THREAD ALL OF THE
HOLES, JUST TAP THEM TO THE
CORRECT DEPTHS AND
DIAMETERS

UNLESS OTHERWISE SPECIFIED: | | NAME | DATE
DIMENSIONS ARE IN INCHES TOLERANCES: FRACTIONAL ANGULAR: MACH BEND TWO PLACE DECIMAL THREE PLACE DECIMAL | DRAWN

CHECKED | | | TITLE:

ENG APPR.
MFG APPR.

INTERPRET GEOMETRIC TOLERANCING PER: | Q.A.
MATERIAL | | SIZE A | DWG. NO. Top Panel | REV

PROPRIETARY AND CONFIDENTIAL
THE INFORMATION CONTAINED IN THIS
DRAWING IS THE SOLE PROPERTY OF
<INSERT COMPANY NAME HERE>. ANY
REPRODUCTION IN PART OR AS A WHOLE
WITHOUT THE WRITTEN PERMISSION OF
<INSERT COMPANY NAME HERE> IS
PROHIBITED.

NEXT ASSY | USED ON | FINISH

APPLICATION | DO NOT SCALE DRAWING | | SCALE: 1:2 | WEIGHT: | SHEET 1 OF 2

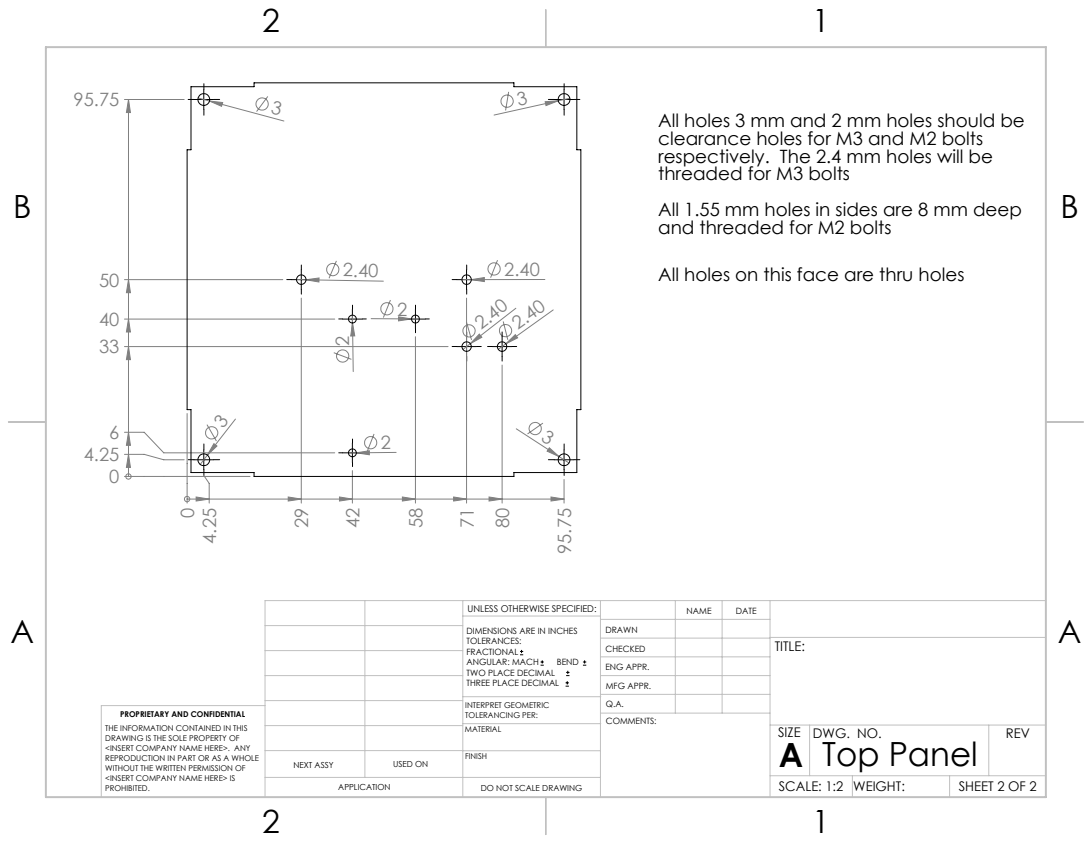
[picture p124: page 2]

All holes 3 mm and 2 mm holes should be
clearance holes for M3 and M2 bolts
respectively. The 2.4 mm holes will be
threaded for M3 bolts
All 1.55 mm holes in sides are 8 mm deep
and threaded for M2 bolts
All holes on this face are thru holes

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

CHECKED | | | TITLE:

ENG APPR.
MFG APPR.

INTERPRET GEOMETRIC TOLERANCING PER: | Q.A.
MATERIAL | | SIZE A | DWG. NO. Top Panel | REV

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

NEXT ASSY | USED ON | FINISH

APPLICATION | DO NOT SCALE DRAWING | | SCALE: 1:2 | WEIGHT: | SHEET 2 OF 2
