M2I-CySat/CySat-1-Structures/(commit log)

2014-09-13 CySat Top Pannel Board
    [Top_Panel_board.SLDPRT]
2014-09-20 Deleted these 2 files
    [Top_Panel_board.SLDPRT]
2014-09-20 Complete Top Panel
    [Dipole.SLDPRT, Dipole_Antenna_Mount_Bottom.SLDPRT, Dipole_Antenna_Mount_Top.SLDPRT, Mono_Antenna_Mount_Bottom.SLDPRT, Mono_Antenna_Mount_Top.SLDPRT, Monopole.SLDPRT, Taskcell.SLDPRT, Top_Panel.SLDPRT]
2014-09-20 Experimental solidworks edit part
    [R.SLDPRT]
2014-09-20 Changed from R to RAY
    [R.SLDPRT]
2014-09-20 Changed name of folder
    [Dipole.SLDPRT, Dipole_Antenna_Mount_Bottom.SLDPRT, Dipole_Antenna_Mount_Top.SLDPRT, Mono_Antenna_Mount_Bottom.SLDPRT, Mono_Antenna_Mount_Top.SLDPRT, Monopole.SLDPRT, Taskcell.SLDPRT, Top_Panel.SLDPRT]
2014-09-27 I switched the location of the folder on the U drive
2014-09-30 Outer skeleton for the cubesat
    [CSK_1U_Chassis_Skeleton_RevD.SLDPRT]
2014-10-18 Full Solidworks Model for 2014
    [1.5 cm part 1.SLDPRT, 1.55 cm.SLDPRT, 1.7 cm part 1.SLDPRT, 2.35 cm.SLDPRT, 3.7V BATTERY.sldprt, 3.7V BATTERY_1.sldprt, 3D-05-00154_1.SLDPRT, 3D-09-00156_1.sldprt]
2014-10-18 Create New Part
    [1.6 cm part 1.SLDPRT]
2014-10-18 Inserted Spacers
2014-10-25 Deleted Spacer
2014-10-25 Inserted Spacer
2014-10-28 Added Softronics Model
    [1.5 cm part 1.SLDPRT, 1.55 cm.SLDPRT, 1.7 cm part 1.SLDPRT, 2.35 cm.SLDPRT, 3.7V BATTERY.sldprt, 3.7V BATTERY_1.sldprt, 3D-05-00154_1.SLDPRT, 3D-09-00156_1.sldprt]
2014-11-01 deleted files
    [1.5 cm part 1.SLDPRT, 1.7 cm part 1.SLDPRT, 2.35 cm.SLDPRT, 3.7V BATTERY.sldprt, 3.7V BATTERY_1.sldprt, 3D-05-00154_1.SLDPRT, 3D-09-00156_1.sldprt, 3D-09-00171_1.SLDPRT]
2014-11-01 Deleted softronics model
    [1.55 cm.SLDPRT, Finished 1.5 cm.SLDPRT, Mono_Antenna_Mount_Top.SLDPRT, Top_Panel_ASSY-2.SLDPRT]
2014-12-13 Renamed Solidworks model to better name
    [1.5 cm part 1.SLDPRT, 1.55 cm.SLDPRT, 1.6 cm part 1.SLDPRT, 1.7 cm part 1.SLDPRT, 2.35 cm.SLDPRT, 3.7V BATTERY.sldprt, 3.7V BATTERY_1.sldprt, 3D-05-00154_1.SLDPRT]
2015-02-28 Payload Board and Camera
    [cameramodule.SLDPRT, payloadboard.SLDPRT]
2015-03-28 inserted new components
    [cameramodule.SLDPRT, payloadboard.SLDPRT]
2015-03-28 Moved Boards Around
2015-04-01 modifying payload
    [CSK_Stacking_Bus_Connector.SLDPRT, payloadboard.SLDPRT]
2015-04-01 turned payload board into assembly
    [Payload Board Assembly.SLDASM]
2015-04-01 created new connecting bus
    [CSK_Stacking_Bus_Connector new.SLDPRT, CSK_Stacking_Bus_Connector new1.SLDPRT]
2015-04-01 modifing payload board
    [payloadboard.SLDPRT]
2015-04-01 Payload Board has been fitted
2015-04-01 Updated Payload
    [ESQ-126-14-X-D.sldprt, He-100.SLDASM, Heatsink_He.sldprt, PCB.sldprt, SMA-J-P-X-RA-TH1.sldprt, new aux board.SLDPRT]
2015-04-04 modified radio
    [He-100.SLDASM, RadioWireHead2.SLDPRT]
2015-04-04 uploaded new radio board
2015-04-04 Added Task Cell
    [NewTaskCells1.SLDASM, OnePanelForTaskCells.SLDPRT, TaskeCellsBase.SLDPRT]
2015-04-04 Added new diagnostic panel
    [New Diagnostic Panel.SLDPRT]
2015-04-04 nearly completed stackup
    [Dipole.SLDPRT, New Diagnostic Panel.SLDPRT, NewTaskCells1.SLDASM, Top_Panel.SLDPRT]
2015-04-06 updated fasteners
    [B18.2.4.1M - Hex nut, Style 1, M2.5 x 0.45 --D-S.sldprt, B18.22M - Plain washer, 2.5 mm, regular.sldprt, B18.22M - Plain washer, 2.5 mm, regular111.sldprt, Monopole.SLDPRT]
2015-04-06 Inserting fasteners
    [B18.22M - Plain washer, 2.5 mm, regular.sldprt, B18.6.7M - M2.5 x 0.45 x 8 Type I Cross Recessed FHMS --8S.sldprt, B18.6.7M - M2.5 x 0.45 x 8 Type I Cross Recessed PHMS --8S.sldprt, He-100.SLDASM, NewTaskCells1.SLDASM, camera mounting bracket.SLDPRT]
2015-04-07 Finished and rendered the stack
    [B18.2.4.1M - Hex nut, Style 1, M2.5 x 0.45 --D-S.sldprt, B18.22M - Plain washer, 2.5 mm, regular.sldprt, B18.22M - Plain washer, 2.5 mm, regular111.sldprt, B18.6.7M - M2.5 x 0.45 x 8 Plain HHMS --8S.sldprt, B18.6.7M - M2.5 x 0.45 x 8 Type I Cross Recessed FHMS --8S.sldprt, B18.6.7M - M2.5 x 0.45 x 8 Type I Cross Recessed PHMS --8S.sldprt, PCB.sldprt, camera mounting bracket.SLDPRT]
2015-04-13 Updated model with new eps
    [3.7V BATTERY.sldprt, 3D-05-00154.sldprt, 3D-09-00156.sldprt, 3D-09-00171.sldprt, 3D-09-00172.sldprt, 3D-11-00224-REVA.sldprt, 3D-11-00227-REVA.sldprt, 3D-13-00197_PreviewCfg.sldprt]
2015-04-13 New Files
    [3D-25-00211-revA.sldasm, 3D-25-00220-REVB.sldasm, New Diagnostic Panel.SLDPRT, New EPS 10w.SLDASM, Top_Panel.SLDPRT]
2015-04-13 Revert "New Files"
    This reverts commit fcd788421c6beaf29a11a6e3fd9bfe7d882a3bdb.
    [3D-25-00211-revA.sldasm, 3D-25-00220-REVB.sldasm, New Diagnostic Panel.SLDPRT, New EPS 10w.SLDASM, Top_Panel.SLDPRT]
2015-04-13 created drafts of panels
    [New Diagnostic Panel and top panel.SLDDRW]
2015-09-26 Added mission 1 model
    [1.5 cm part 1.SLDPRT, 1.55 cm.SLDPRT, 1.7 cm part 1.SLDPRT, 2.35 cm.SLDPRT, 3.7V BATTERY.sldprt, 3.7V BATTERY_1.sldprt, 3D-05-00154_1.SLDPRT, 3D-09-00156_1.sldprt]
2015-11-14 side panel addition 3U
    [solar panel assembly 2.SLDPRT]
2015-11-14 added diagnostic pannel
    [diagnosticpannlea-1.SLDPRT]
2015-11-14 Added 3U model
    [CSK_3U_Chassis_Solid_RevC.SLDPRT]
2015-11-14 Add solar cell
    [Solarcell.SLDPRT]
2015-11-14 Solar cell assembly
    [Assem4.SLDASM]
2015-11-14 Updated assembly and rendered
    [Assem4.SLDASM, CSK_3U_Chassis_Solid_RevC.SLDPRT, Solarcell.SLDPRT]
2015-12-05 Added board block folder
    [Attitude control board.SLDPRT, CNDH block.SLDPRT, EPS board block.SLDPRT, Hack HD block.SLDPRT, Infared Spectormeter block.SLDPRT, Power Batteries block.SLDPRT, Reaction wheel block.SLDPRT, patch antenna.SLDPRT]
2015-12-05 block render and image
    [Assem4.SLDASM, Attitude control board.SLDPRT]
2016-01-23 Copied old solidworks version for M2I computers
    [Assem4.SLDASM, Attitude control board.SLDPRT, CNDH block.SLDPRT, CSK_3U_Chassis_Solid_RevC.SLDPRT, EPS board block.SLDPRT, Hack HD block.SLDPRT, Infared Spectormeter block.SLDPRT, Power Batteries block.SLDPRT]
2016-01-23 Updated changes
    [Assem4.SLDASM, Attitude control board.SLDPRT, CNDH block.SLDPRT, CSK_3U_Chassis_Solid_RevC.SLDPRT, EPS board block.SLDPRT, Hack HD block.SLDPRT, Infared Spectormeter block.SLDPRT, Power Batteries block.SLDPRT]
2016-02-06 Side panel and rails
2016-02-13 updated rails
    [Rails.SLDPRT, skeleton structure assembly.SLDASM]
2016-02-13 basic structure outline (rails, side and top panels)
    [Rails.SLDPRT, general_top_bottom.SLDPRT, skeleton structure assembly.SLDASM]
2016-02-20 New model
    [Newrails.SLDPRT, Rails.SLDPRT, Sidepanel.SLDPRT, general_top_bottom.SLDPRT]
2016-02-20 new assembly
    [New skeleton structure assembly.SLDASM]
2016-02-27 redesign of structure to fit boards
    [3sided sidepanel.SLDPRT, New skeleton structure assembly.SLDASM, Newrails.SLDPRT, general_top_bottom.SLDPRT]
2016-03-26 Creation of final custom structure outside
    [3panelsidepanel.SLDPRT, 3sided sidepanel.SLDPRT, csk_payload_adapter_plate_reva.SLDPRT]
2016-04-02 Dimensions fixed and rail fillits added, need to find top panel
    [3panelsidepanel.SLDPRT, 3sided sidepanel.SLDPRT, full rod (no thread).SLDPRT, skeleton structure assembly.SLDASM]
2016-04-02 Added top panel to new model
    [Dipole.SLDPRT, Dipole_Antenna_Mount_Bottom.SLDPRT, Dipole_Antenna_Mount_Top.SLDPRT, Mono_Antenna_Mount_Bottom.SLDPRT, Mono_Antenna_Mount_Top.SLDPRT, Monopole.SLDPRT, Taskcell.SLDPRT, Top_Panel.SLDPRT]
2016-04-09 Making the model printable
    Added correct hole positions for top panel
    [3panelsidepanel 3dprintable.SLDPRT, 3panelsidepanel.SLDPRT, 3sided sidepanel 3d printable.SLDPRT, 3sided sidepanel.SLDPRT, csk_payload_adapter_plate_reva.SLDPRT]
2016-04-16 splitting parts
    [3panelsidepanel half.SLDPRT, 3sided sidepanel 3d printable conex top half.SLDPRT, 3sided sidepanel conex bottom half.SLDPRT]
2016-10-22 Added current model to repository
    [Connected rail no midcut left.SLDPRT, Connected rail no midcut right.SLDPRT, back panel.SLDPRT, bottom panel.SLDPRT, connected rail assembly.SLDASM, fore panel.SLDPRT, side panel lower.SLDPRT, side panel upper.SLDPRT]
2018-05-31 New Bottom Panel
    [Bottom Panel With Hole.SLDPRT, Full Assembly.SLDASM]
